jgrip/Amiga-2000-EATX/Schematics/2000ATX-REV22-Schematics.pdf

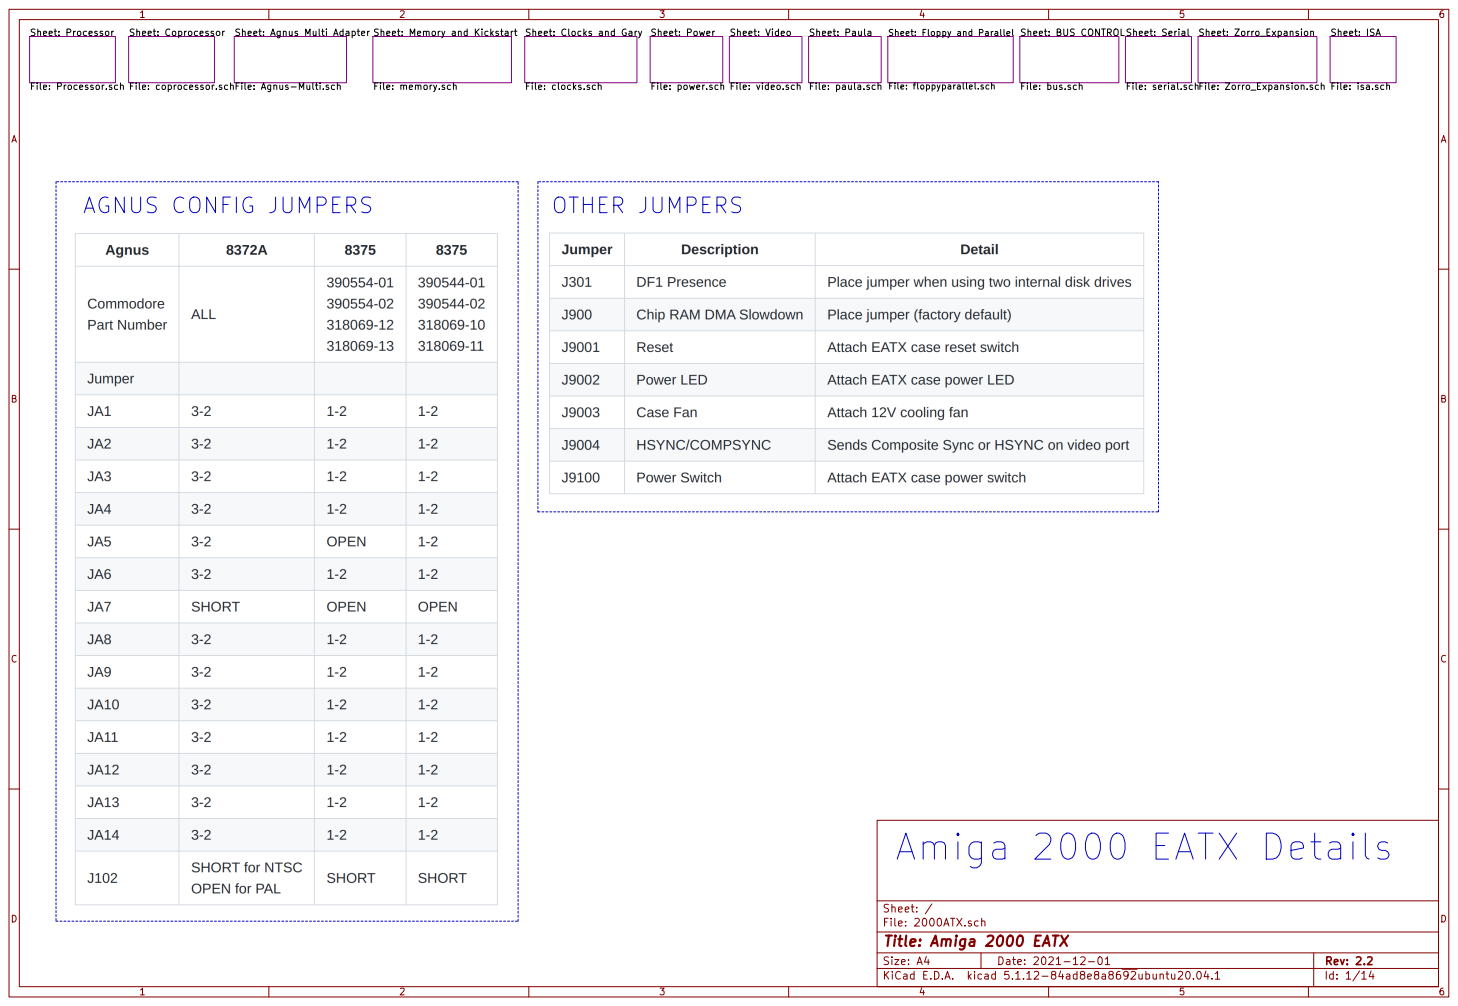
[picture p1: page 1]

Sheet: Memory and Kickstart

File: isa.sch Sheet: Zorro_Expansion

File: Agnus-Multi.sch

File: 2000ATX.sch Sheet: /
Id: 1/14 Title: Amiga 2000 EATX

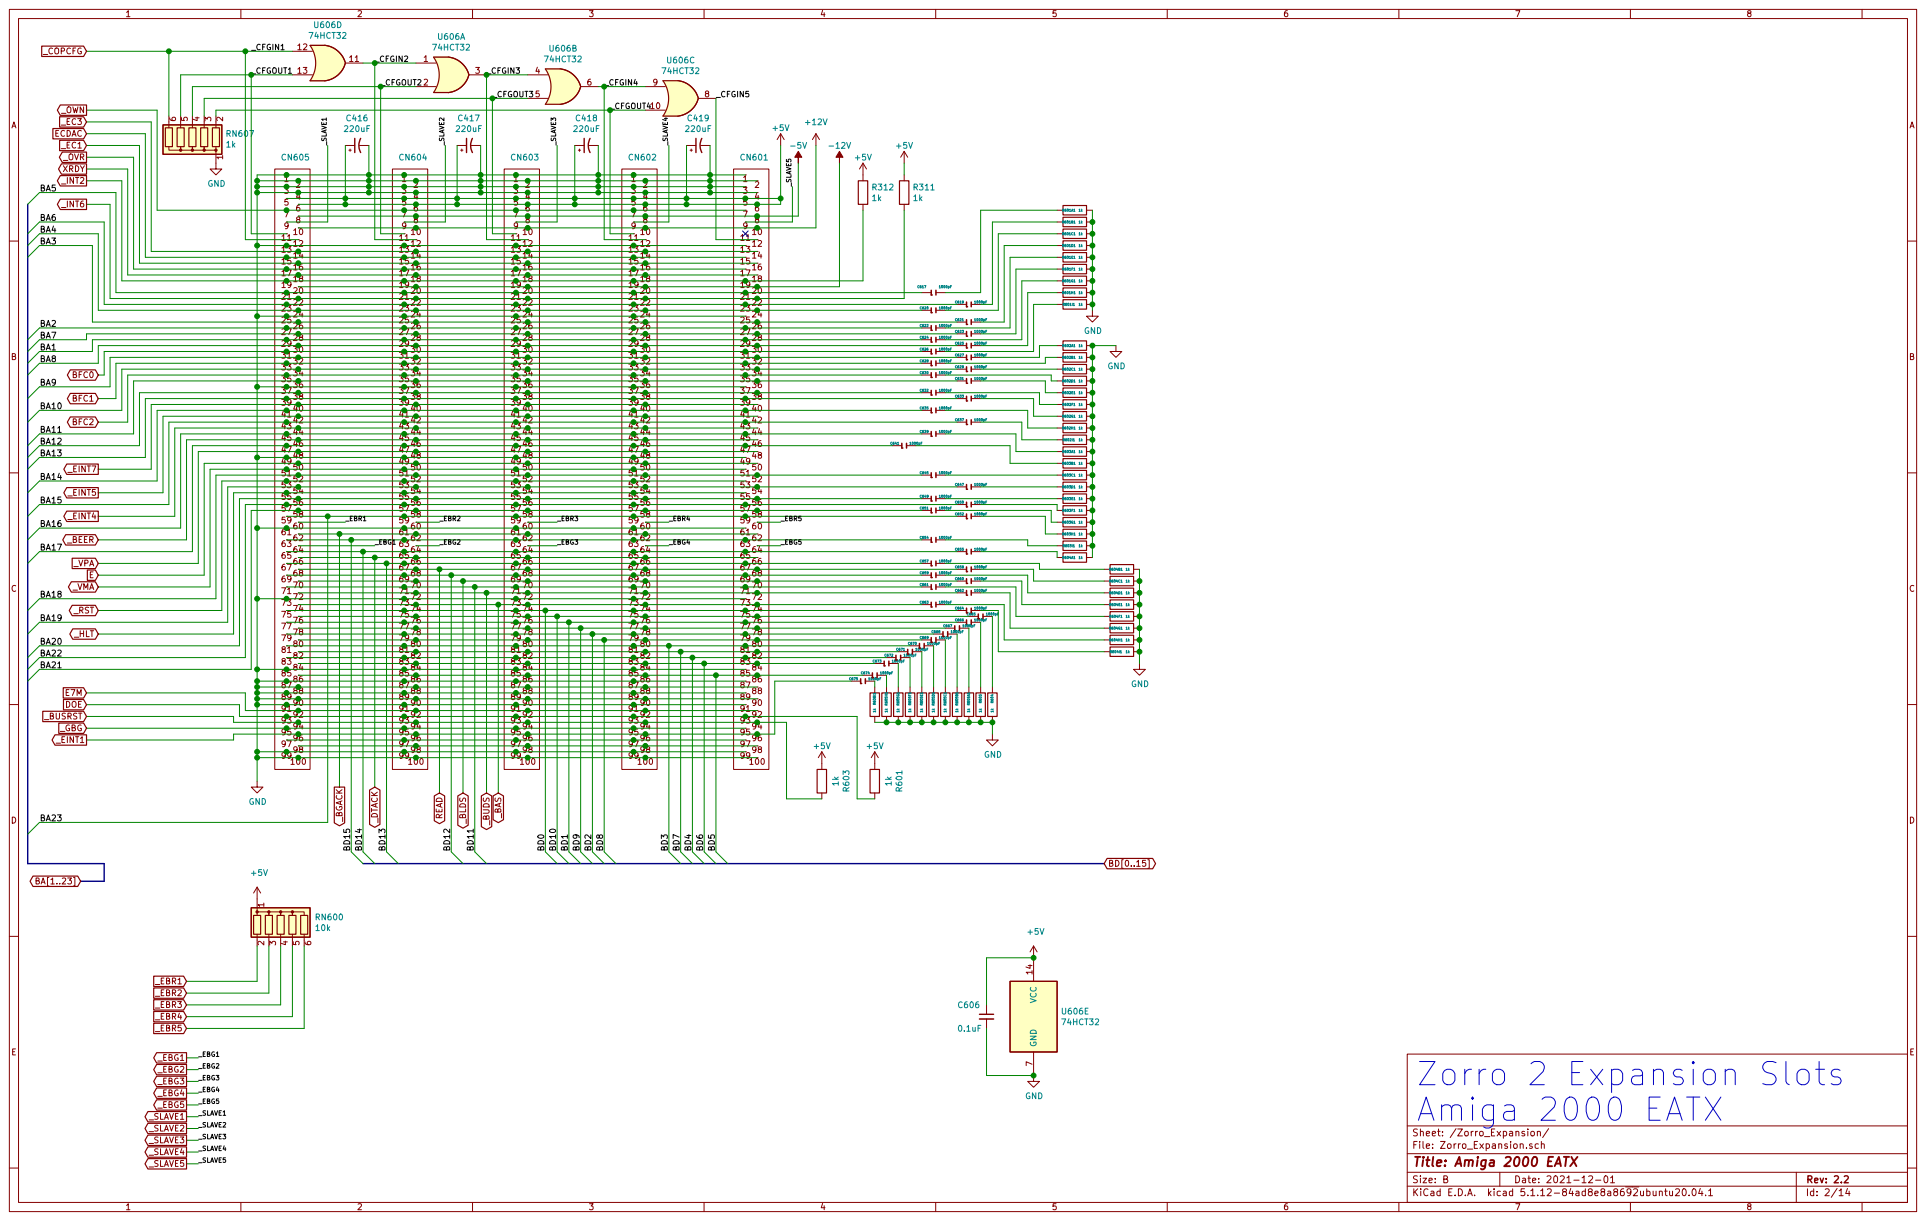
[picture p2: page 2]

495
59 6 24 25 | 59 6 24 25 | 59 6 24 25 | 59 6 24 25 | 59 6 24 25
697 26 27 28 | 697 26 27 28 | 697 26 27 28 | 697 26 27 28 | 697 26 27 28
79 8 32 | 79 8 32 | 79 8 32 | 79 8 32 | 79 8 32
899 35 | 899 35 | 899 35 | 899 35 | 899 35

21 | 21 | 21 | 21 | 21
22 | 22 | 22 | 22 | 22
23 | 23 | 23 | 23 | 23

30 | 30 | 30 | 30 | 30
31 | 31 | 31 | 31 | 31
33 | 33 | 33 | 33 | 33
34 | 34 | 34 | 34 | 34
36 37 | 36 37 | 36 37 | 36 37 | 36 37
38 | 38 | 38 | 38 | 38
41 42 | 41 42 | 41 42 | 41 42 | 41 42
43 44 | 43 44 | 43 44 | 43 44 | 43 44
45 46 | 45 46 | 45 46 | 45 46 | 45 46
47 48 50 51 | 47 48 50 51 | 47 48 50 51 | 47 48 50 51 | 47 48 50 51

52 53 | 52 53 | 52 53 | 52 53 | 52 53
54 55 | 54 55 | 54 55 | 54 55 | 54 55
56 | 56 | 56 | 56 | 56
57 | 57 | 57 | 57 | 57
58 | | 58 | 58 | 58 | 58

93 | 93 | 93 | 93 | 93
94 95 | 94 95 | 94 95 | 94 95 | 94 95
96 97 98 99 100 | 96 97 98 99 100 | 96 97 98 99 100 | 96 97 98 99 100 | 96 97 98 99 100

Sheet: /Zorro_Expansion/
File: Zorro_Expansion.sch
Id: 2/14 Title: Amiga 2000 EATX

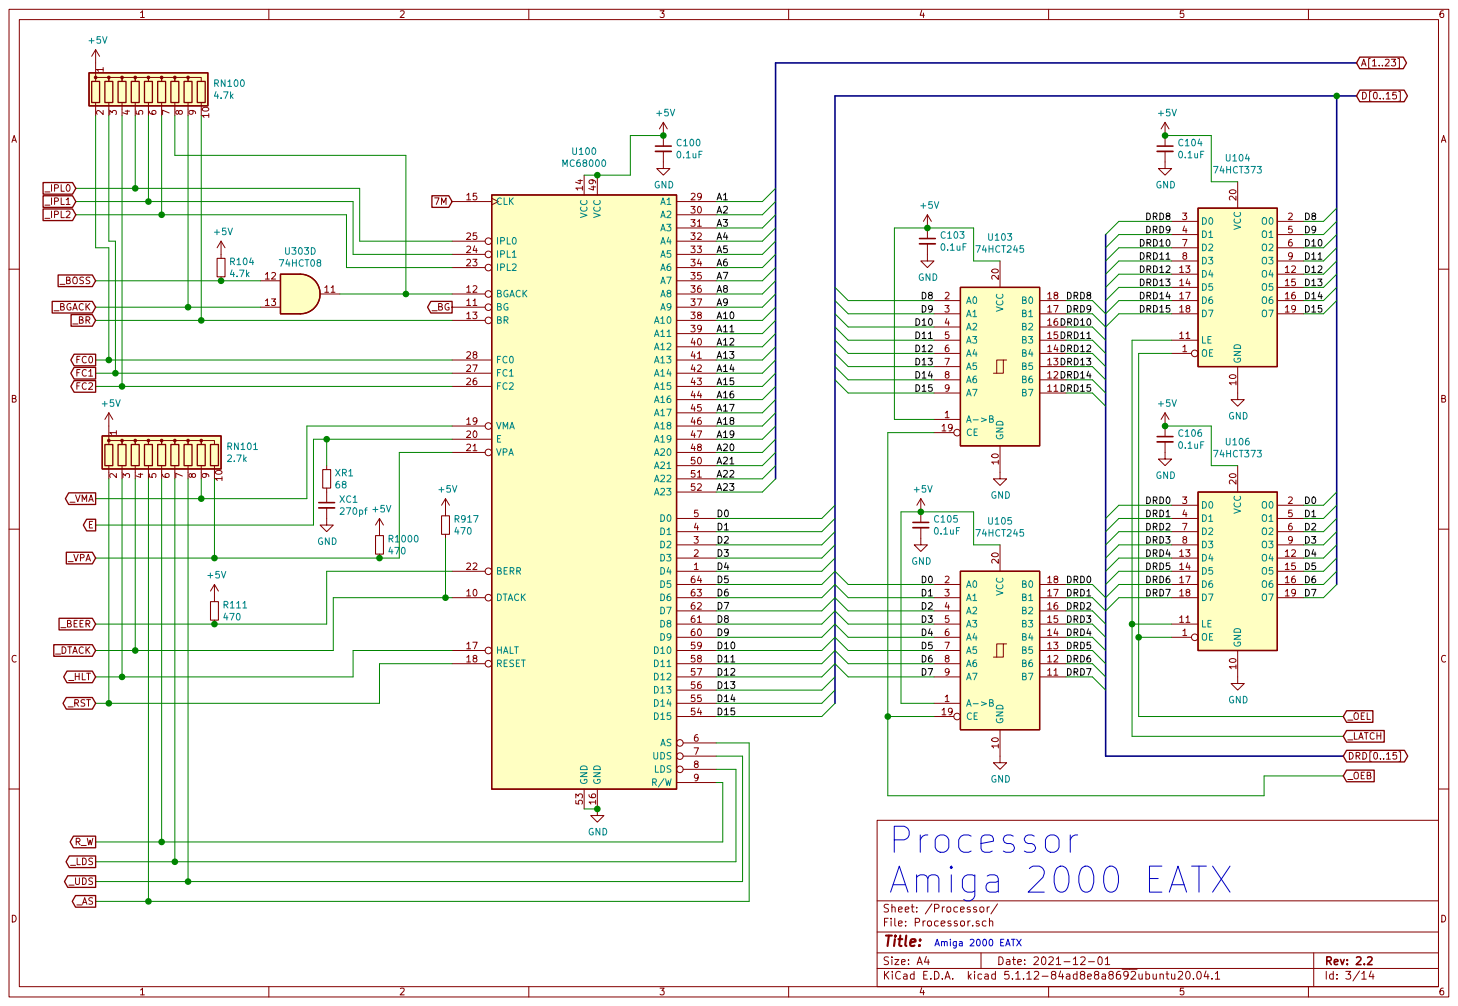
[picture p3: page 3]

Id: 3/14 Title: File: Processor.sch Sheet: /Processor/ GND

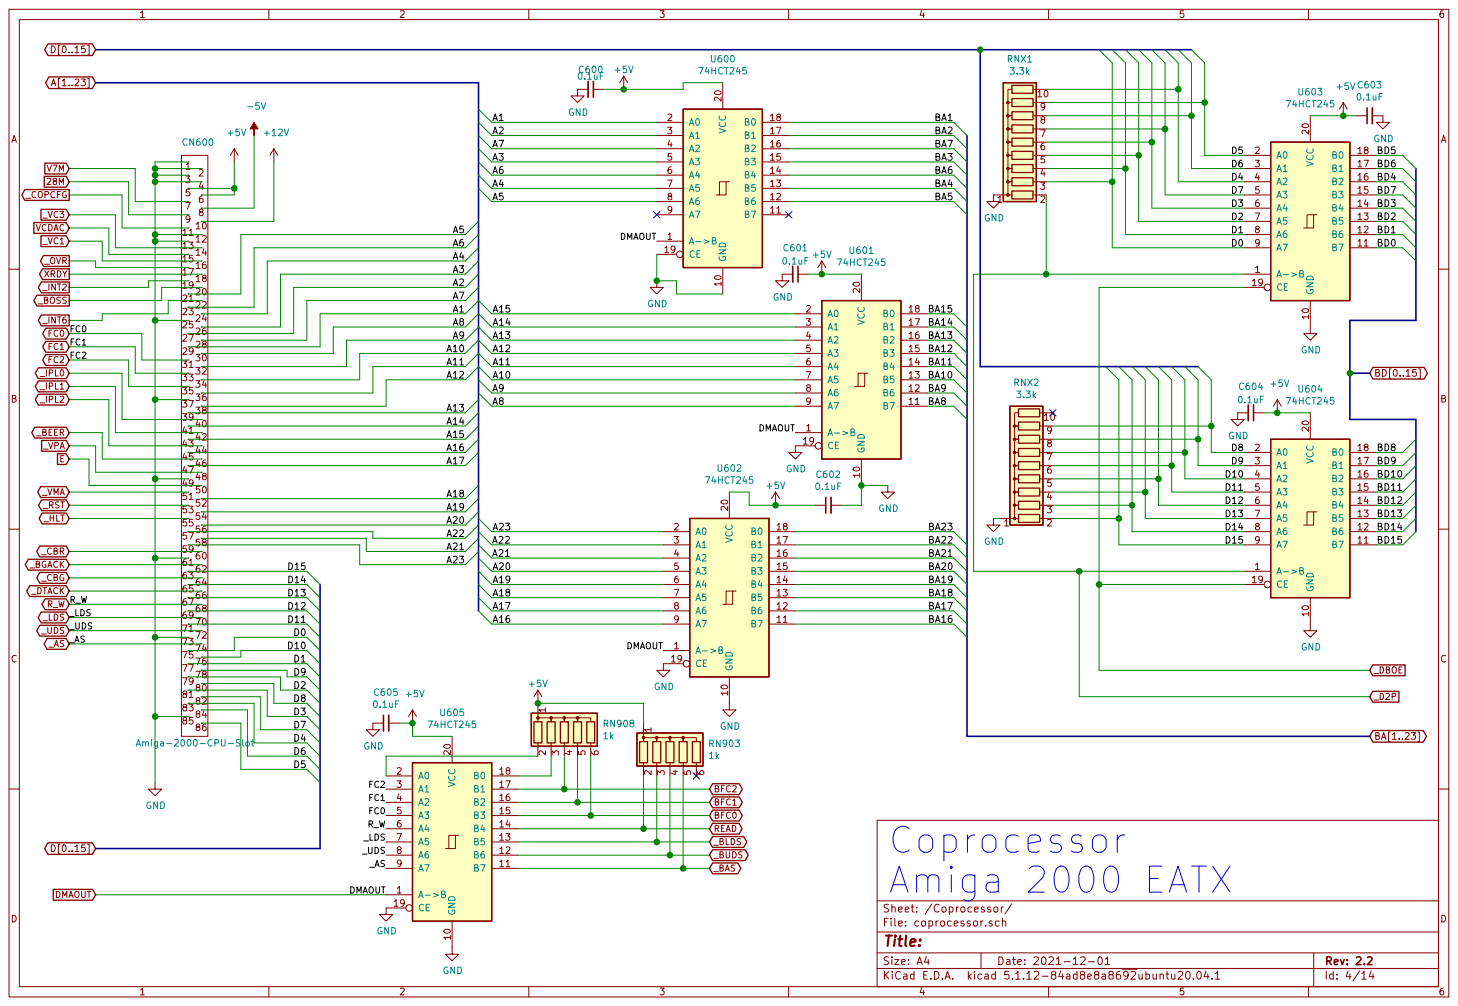
[picture p4: page 4]

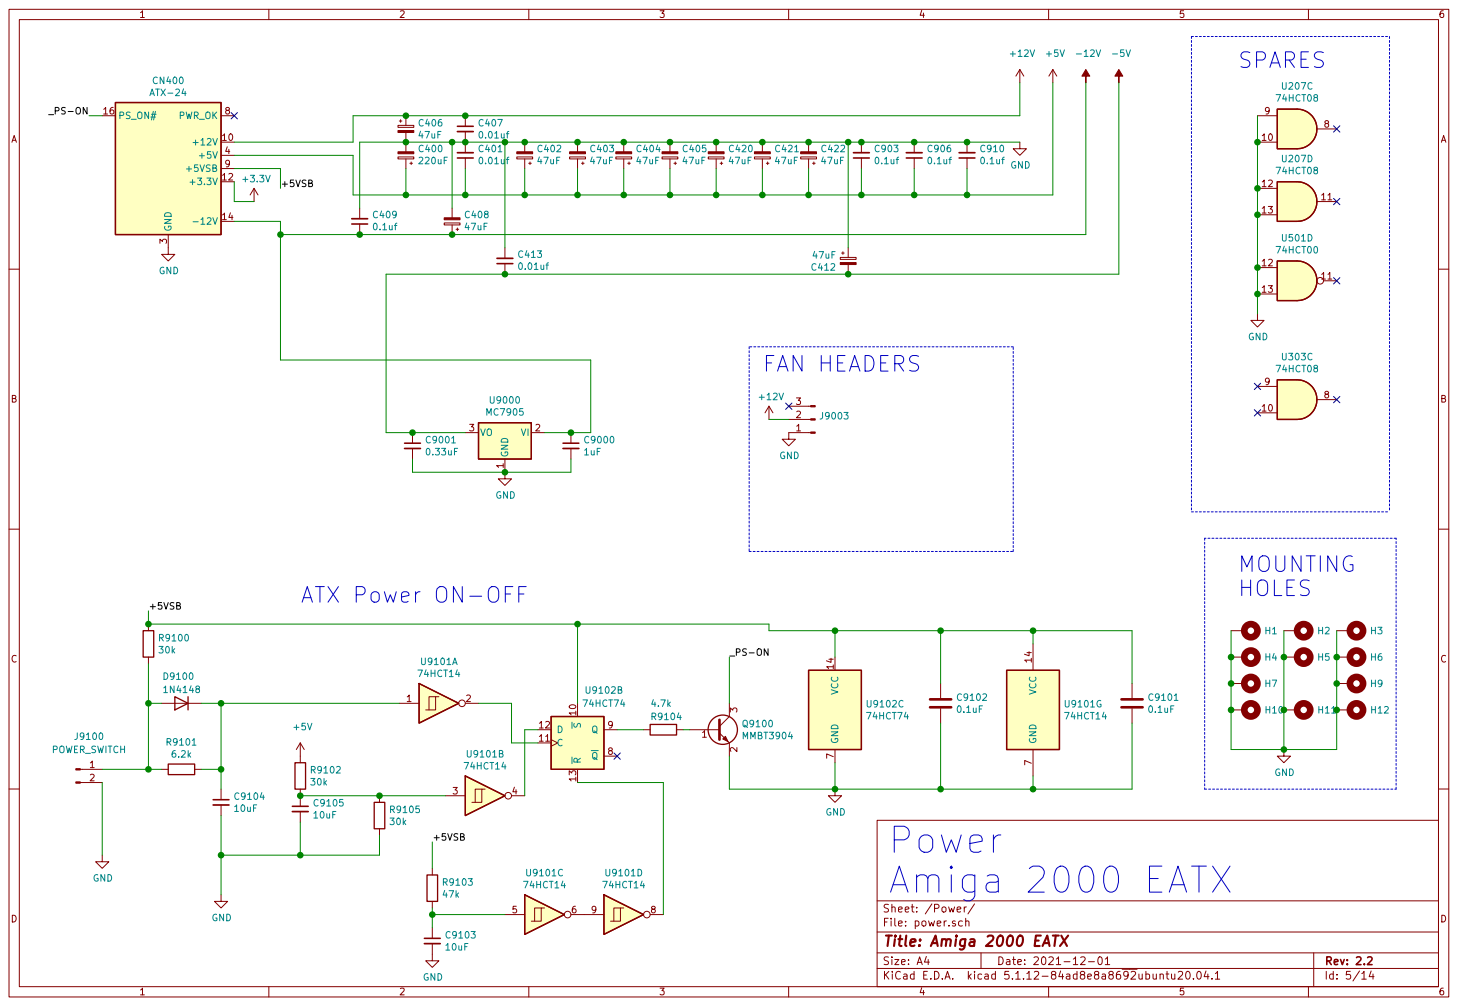
[picture p5: page 5]

File: power.sch Sheet: /Power/
Id: 5/14 Title: Amiga 2000 EATX

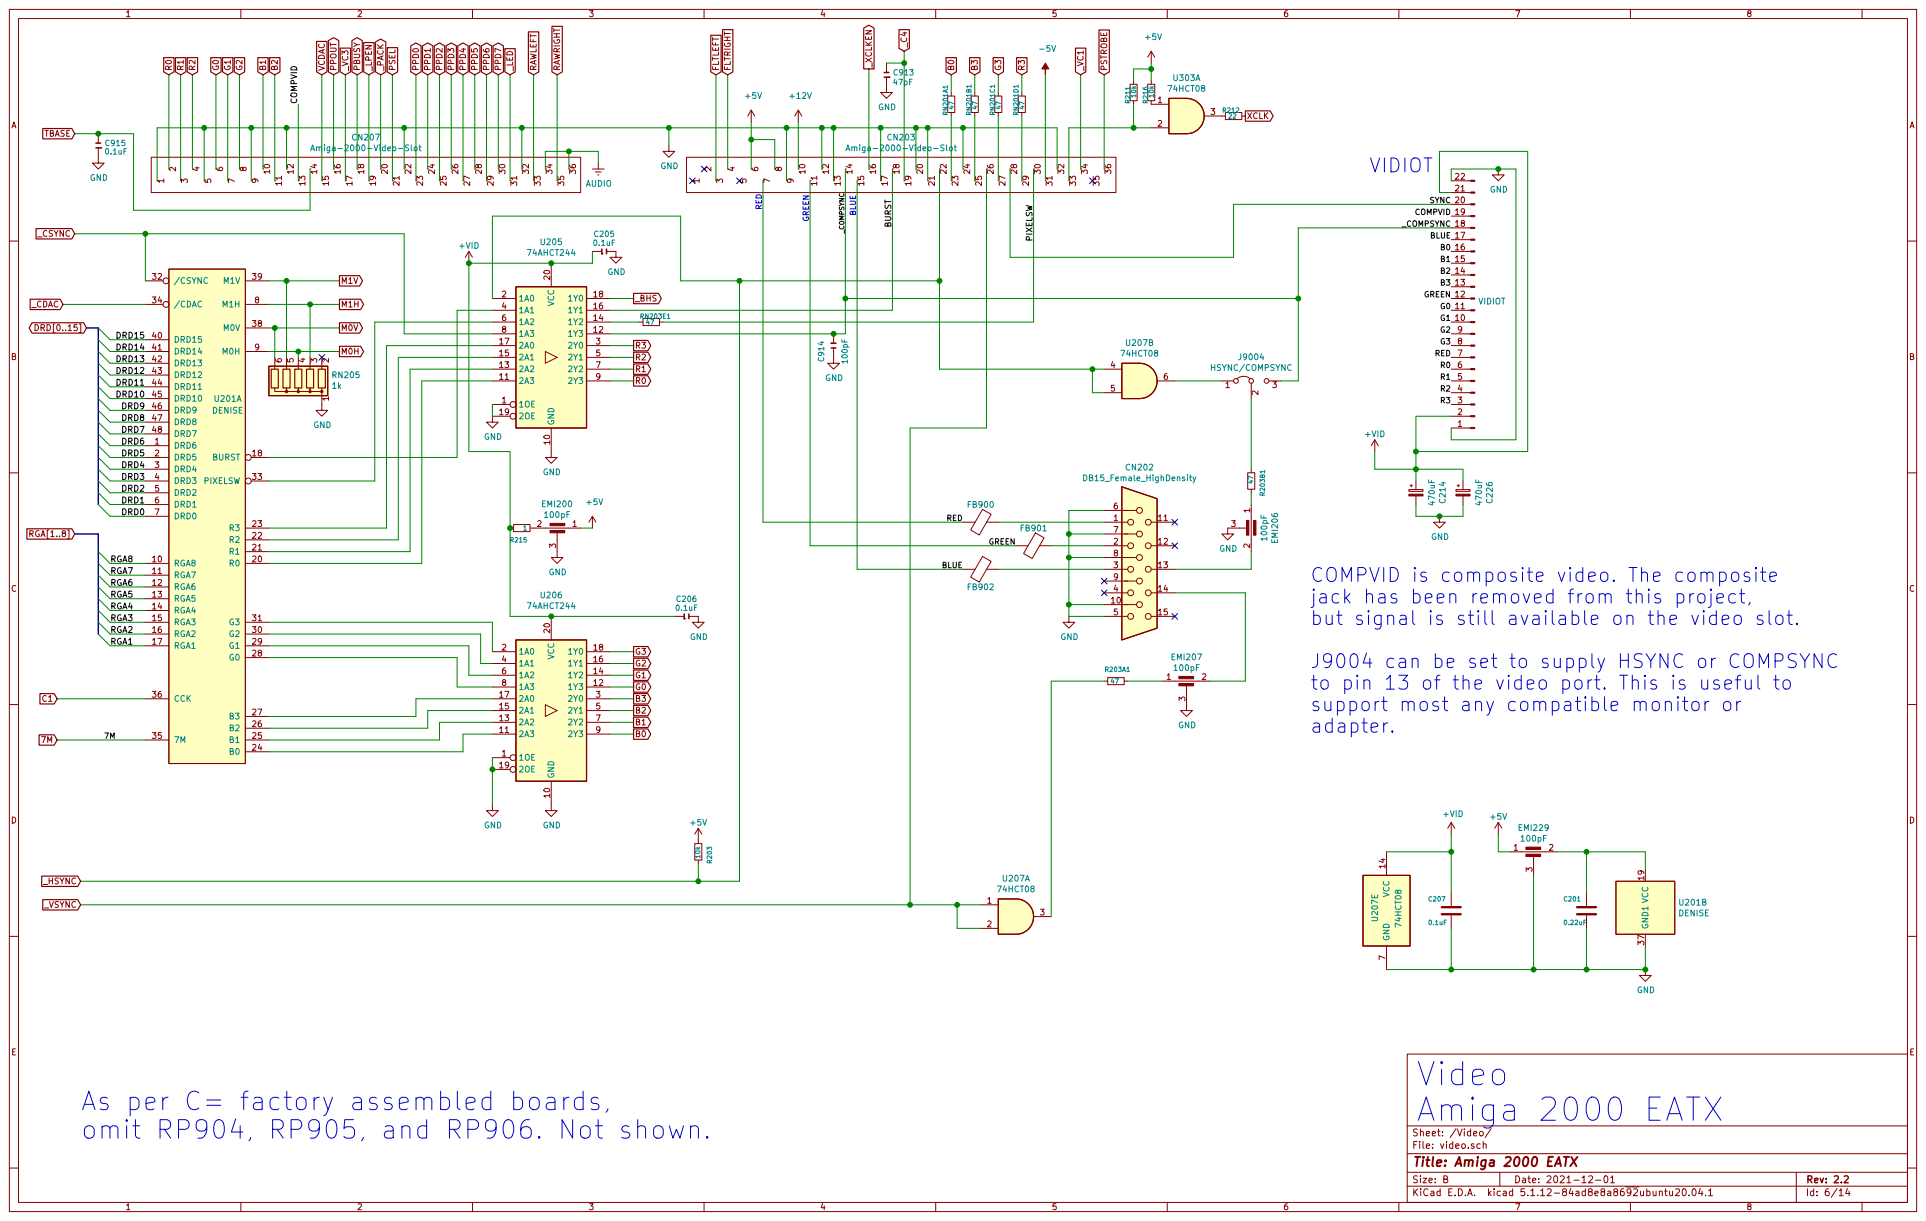
[picture p6: page 6]

9 CN207 Amiga-2000-Video-Slot FB901 GND

adapter. BLUE GREEN RED

COMPVID is composite video. The composite
jack has been removed from this project,
but signal is still available on the video slot.
J9004 can be set to supply HSYNC or COMPSYNC
to pin 13 of the video port. This is useful to
support most any compatible monitor or

As per C= factory assembled boards,
omit RP904, RP905, and RP906. Not shown.

Id: 6/14 Title: Amiga 2000 EATX

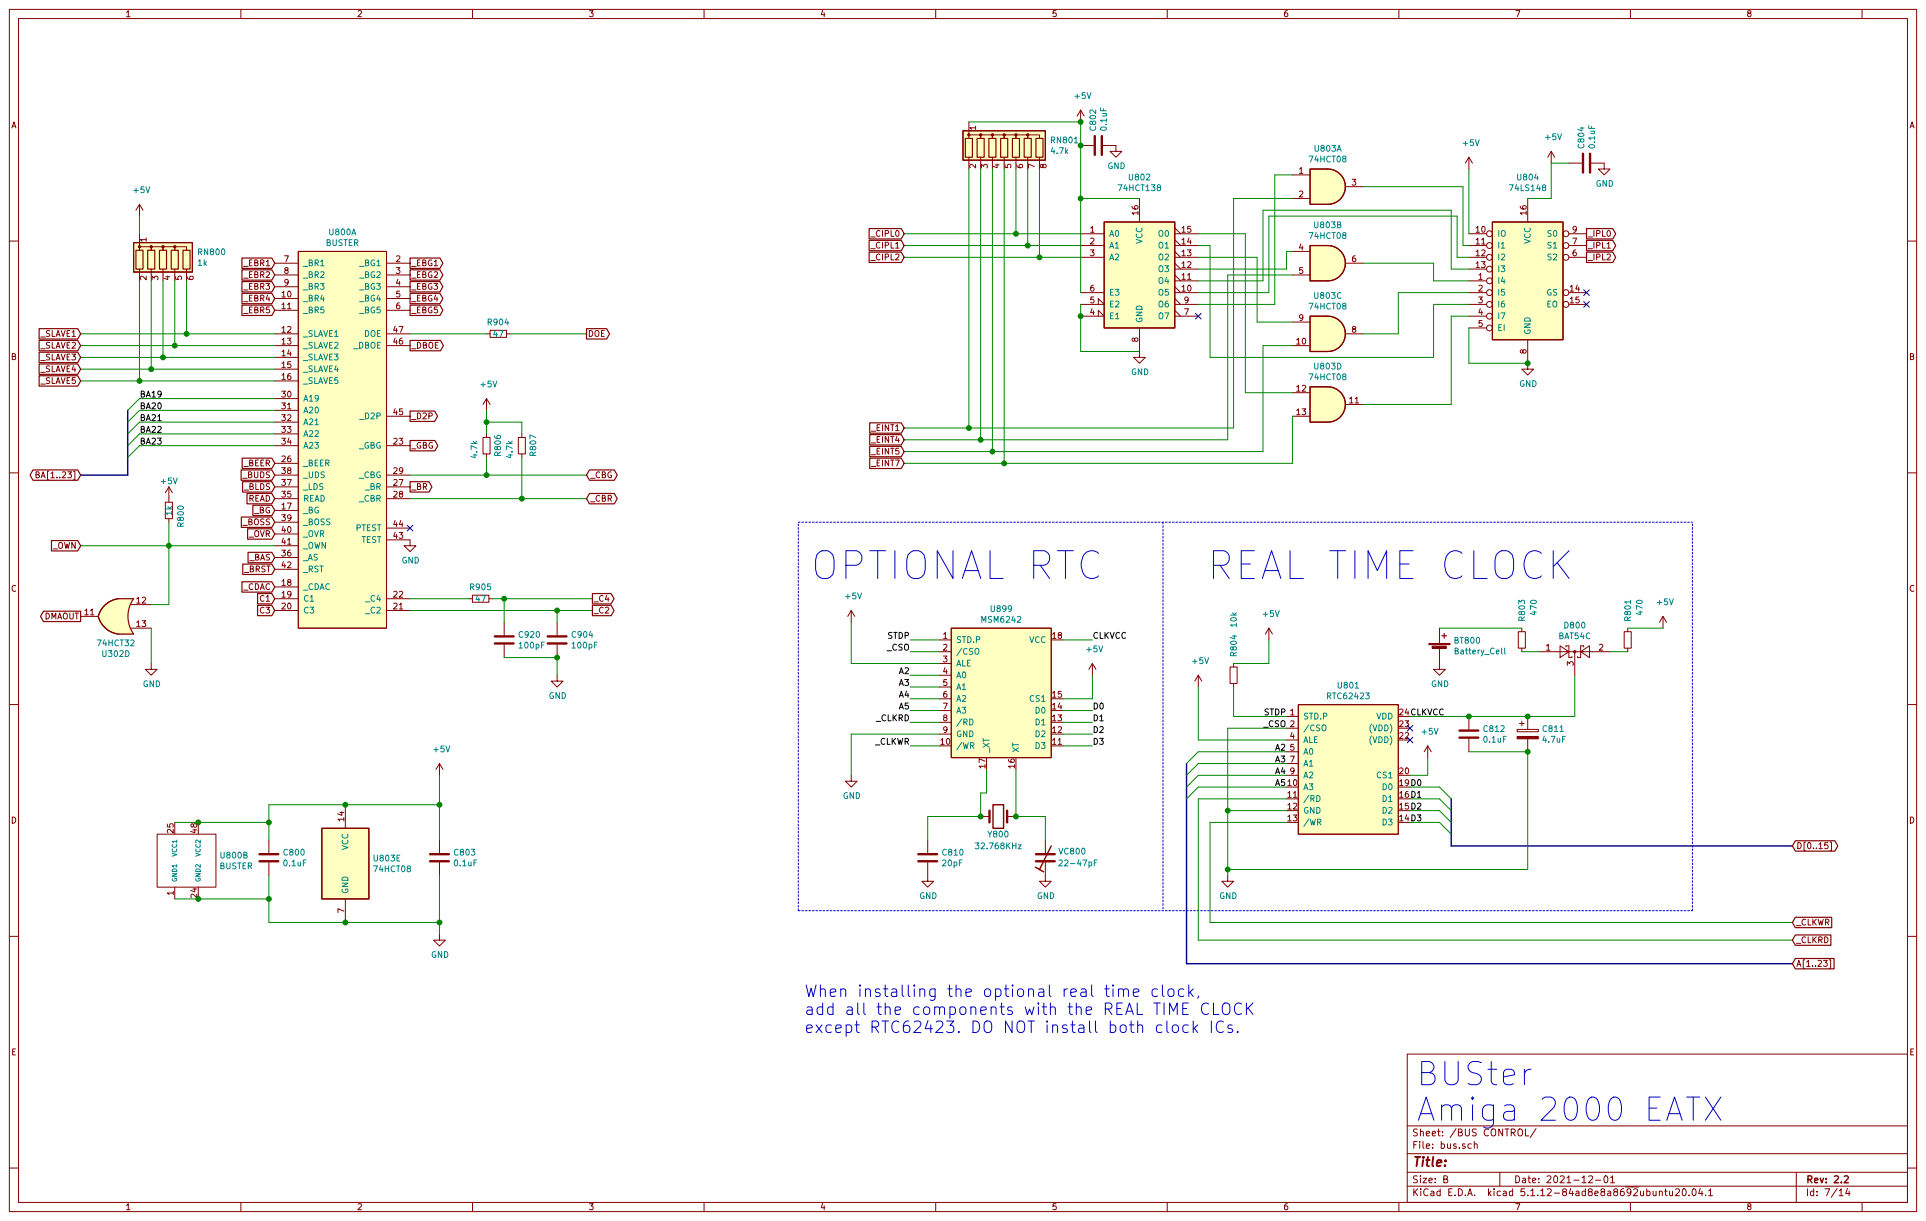
[picture p7: page 7]

When installing the optional real time clock,
add all the components with the REAL TIME CLOCK
except RTC62423. DO NOT install both clock ICs.

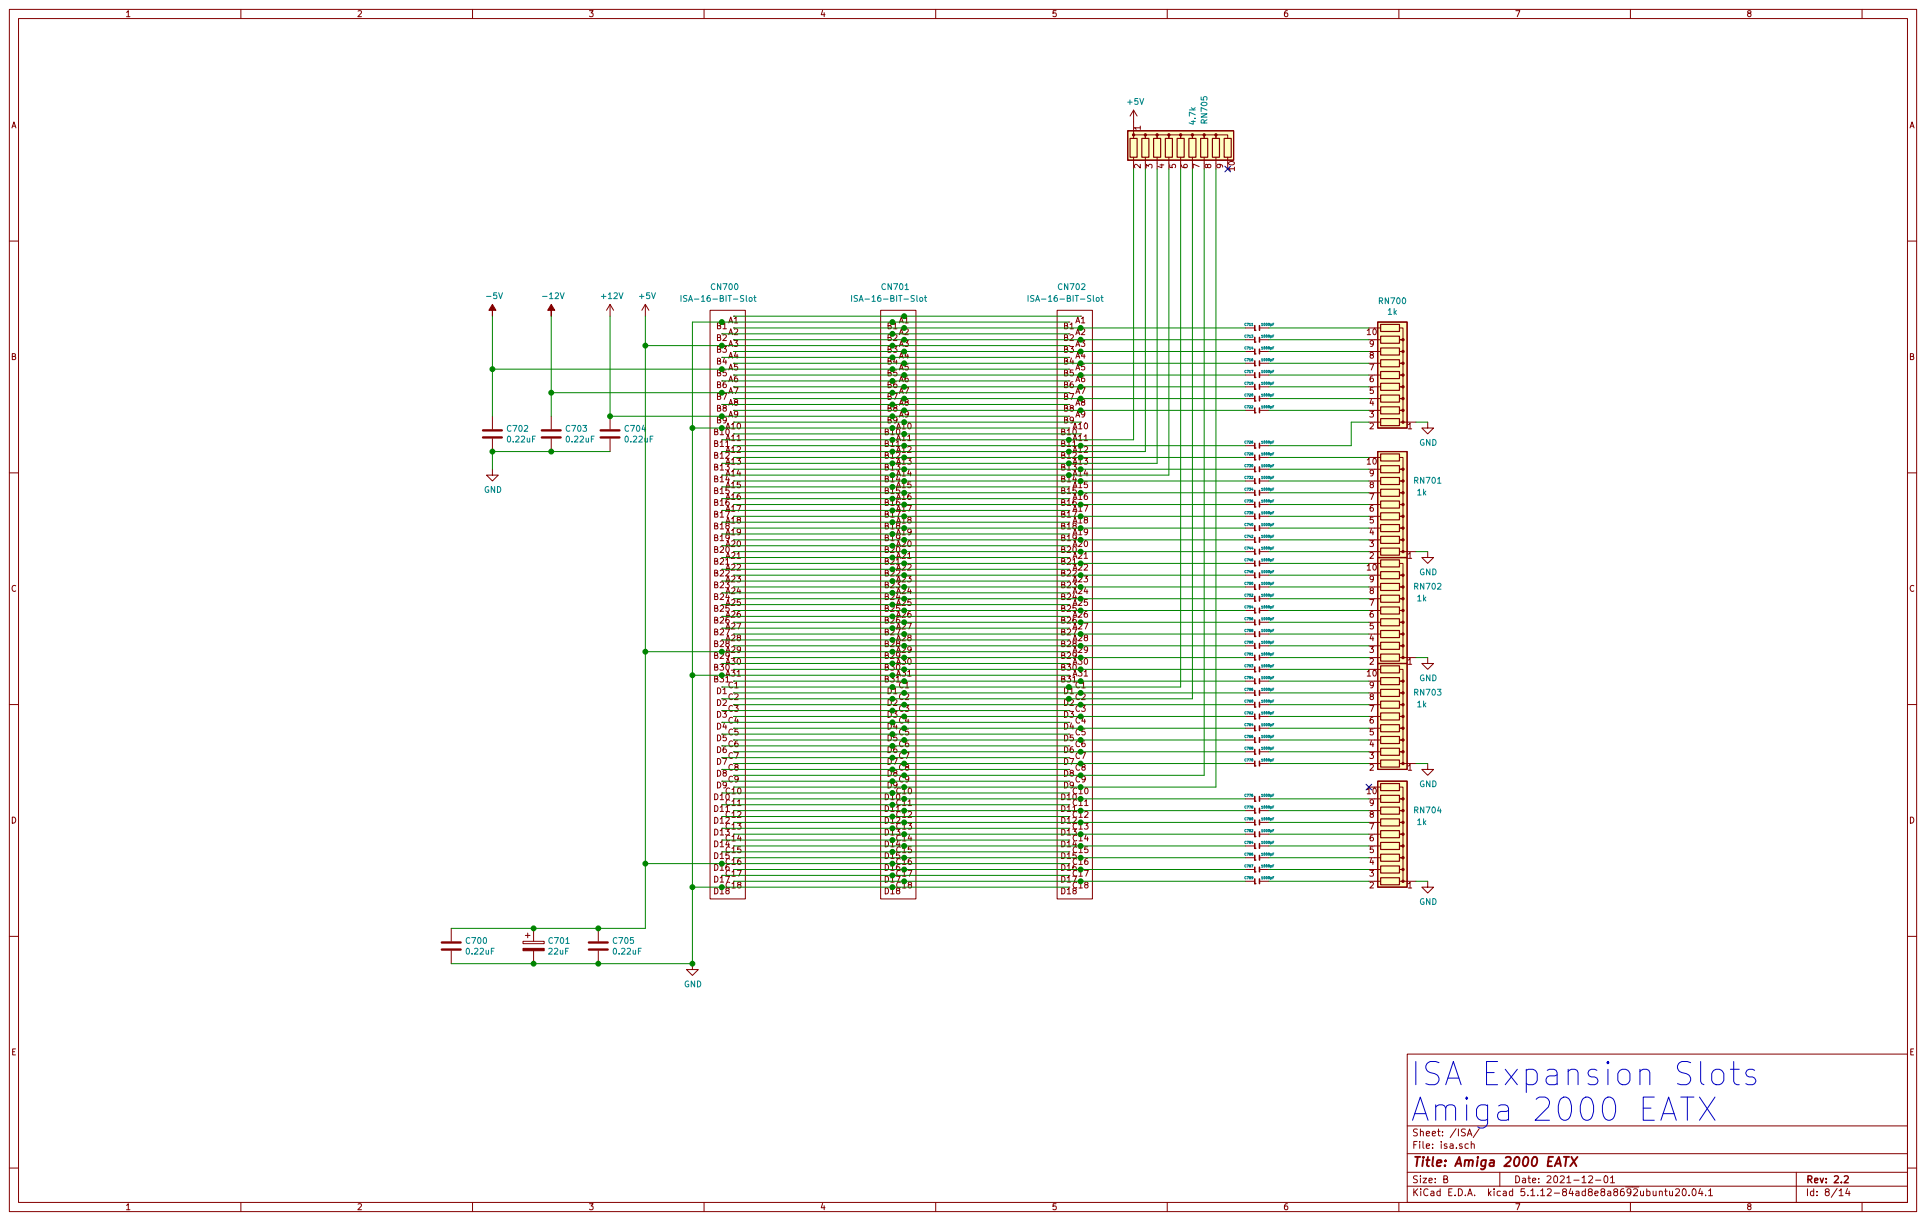
[picture p8: page 8]

File: isa.sch Sheet: /ISA/
Id: 8/14 Title: Amiga 2000 EATX

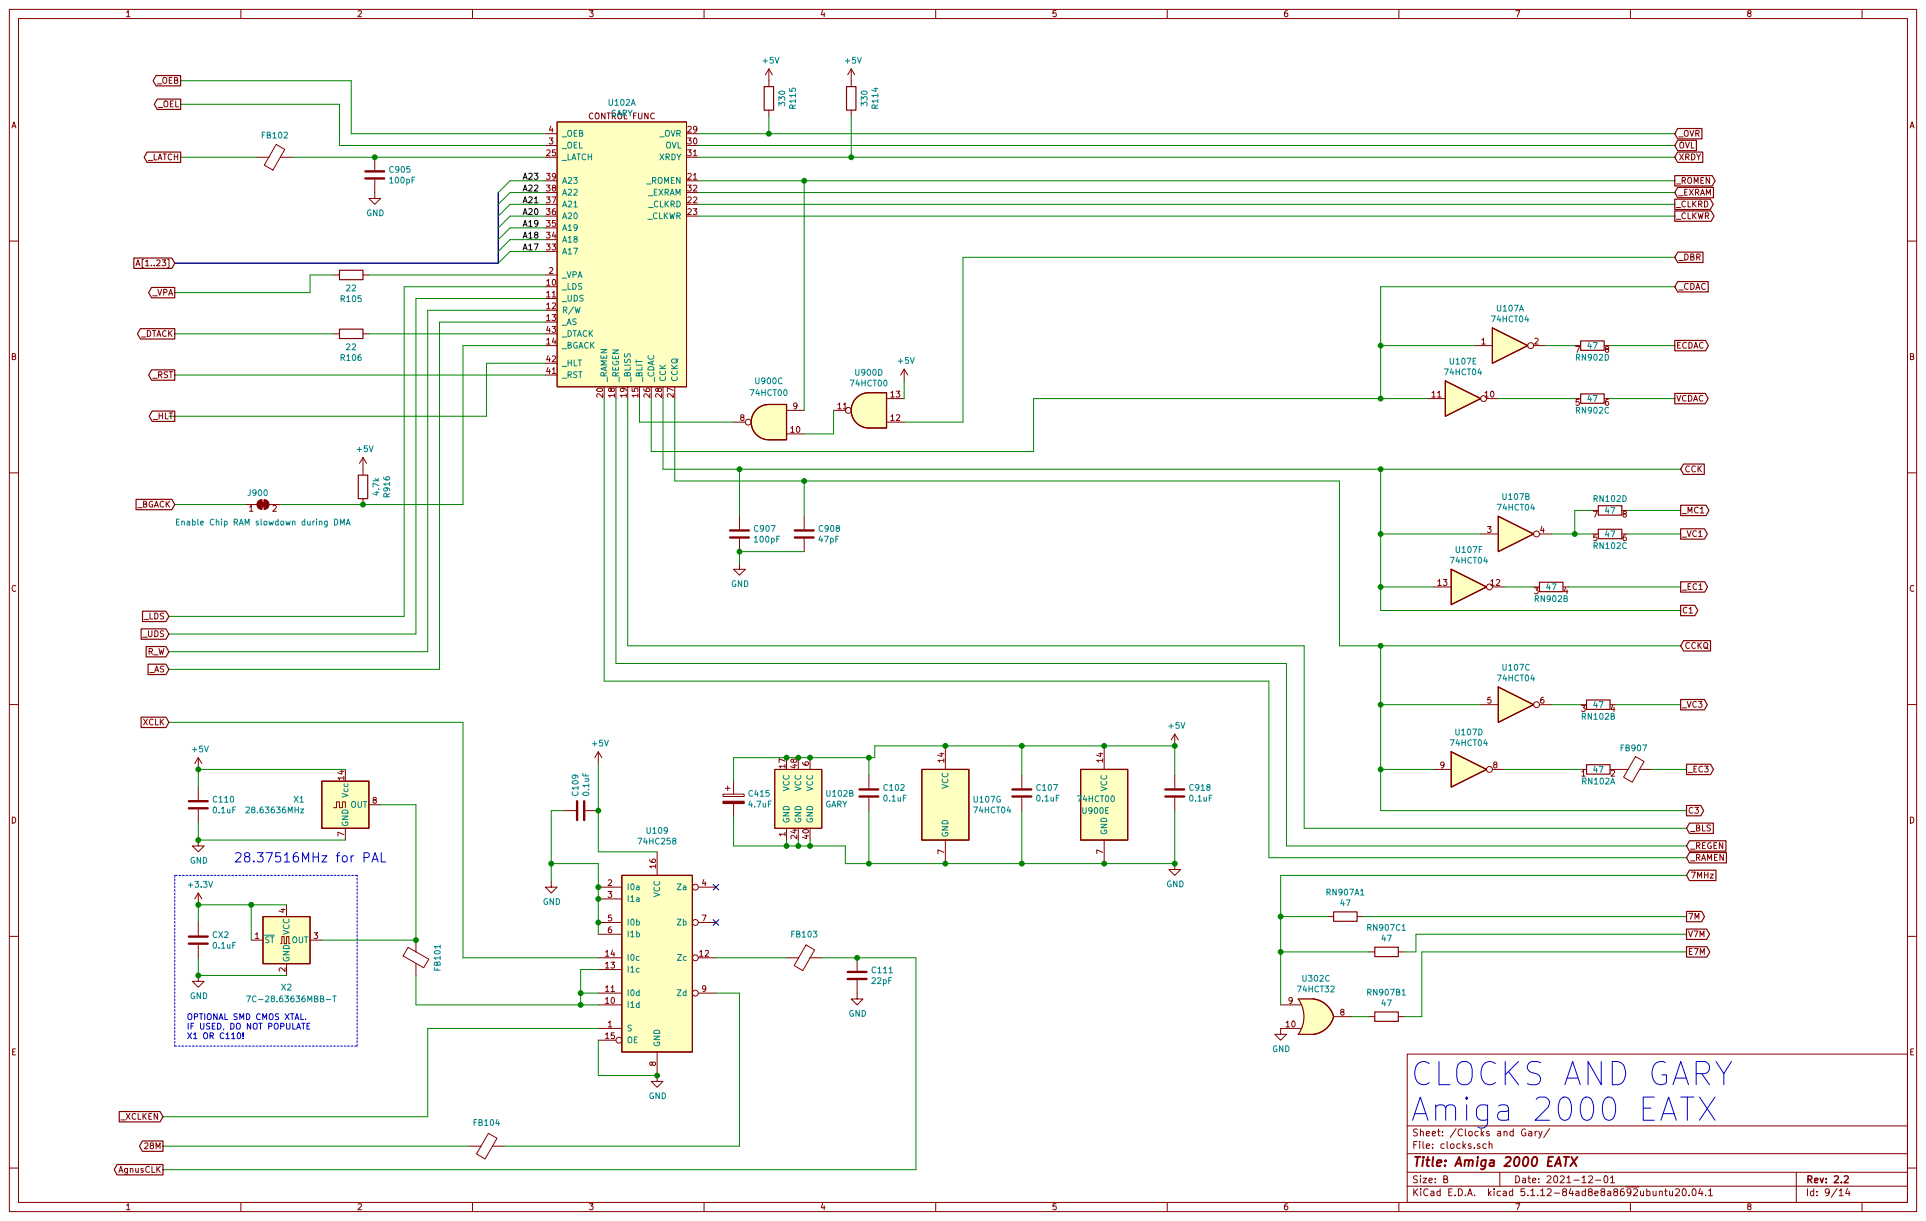
[picture p9: page 9]

J900 Enable Chip RAM slowdown during DMA

OPTIONAL SMD CMOS XTAL.
IF USED, DO NOT POPULATE X1 OR C110!

Id: 9/14 Title: Amiga 2000 EATX

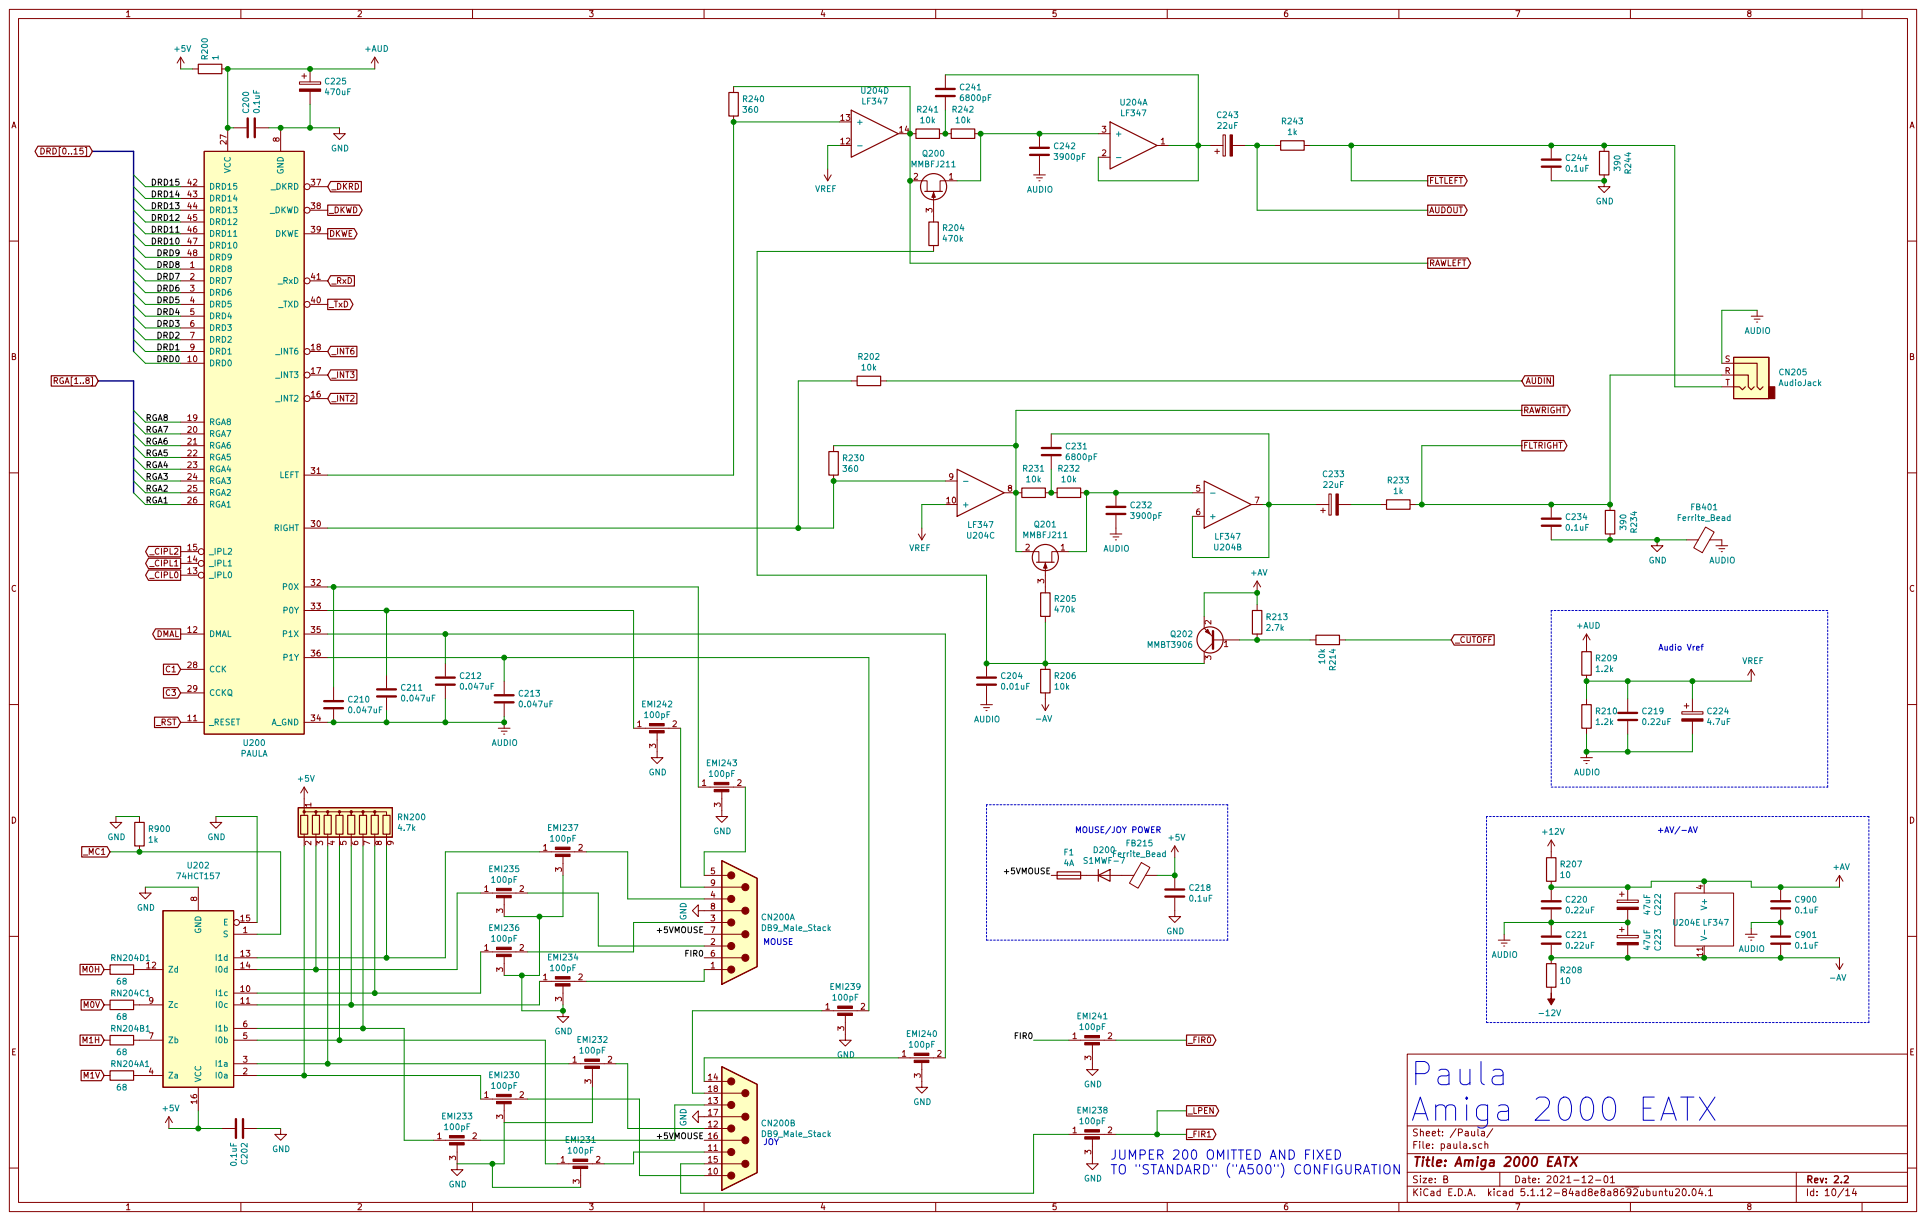
[picture p10: page 10]

Audio Vref JUMPER 200 OMITTED AND FIXED

Id: 10/14 Title: Amiga 2000 EATX

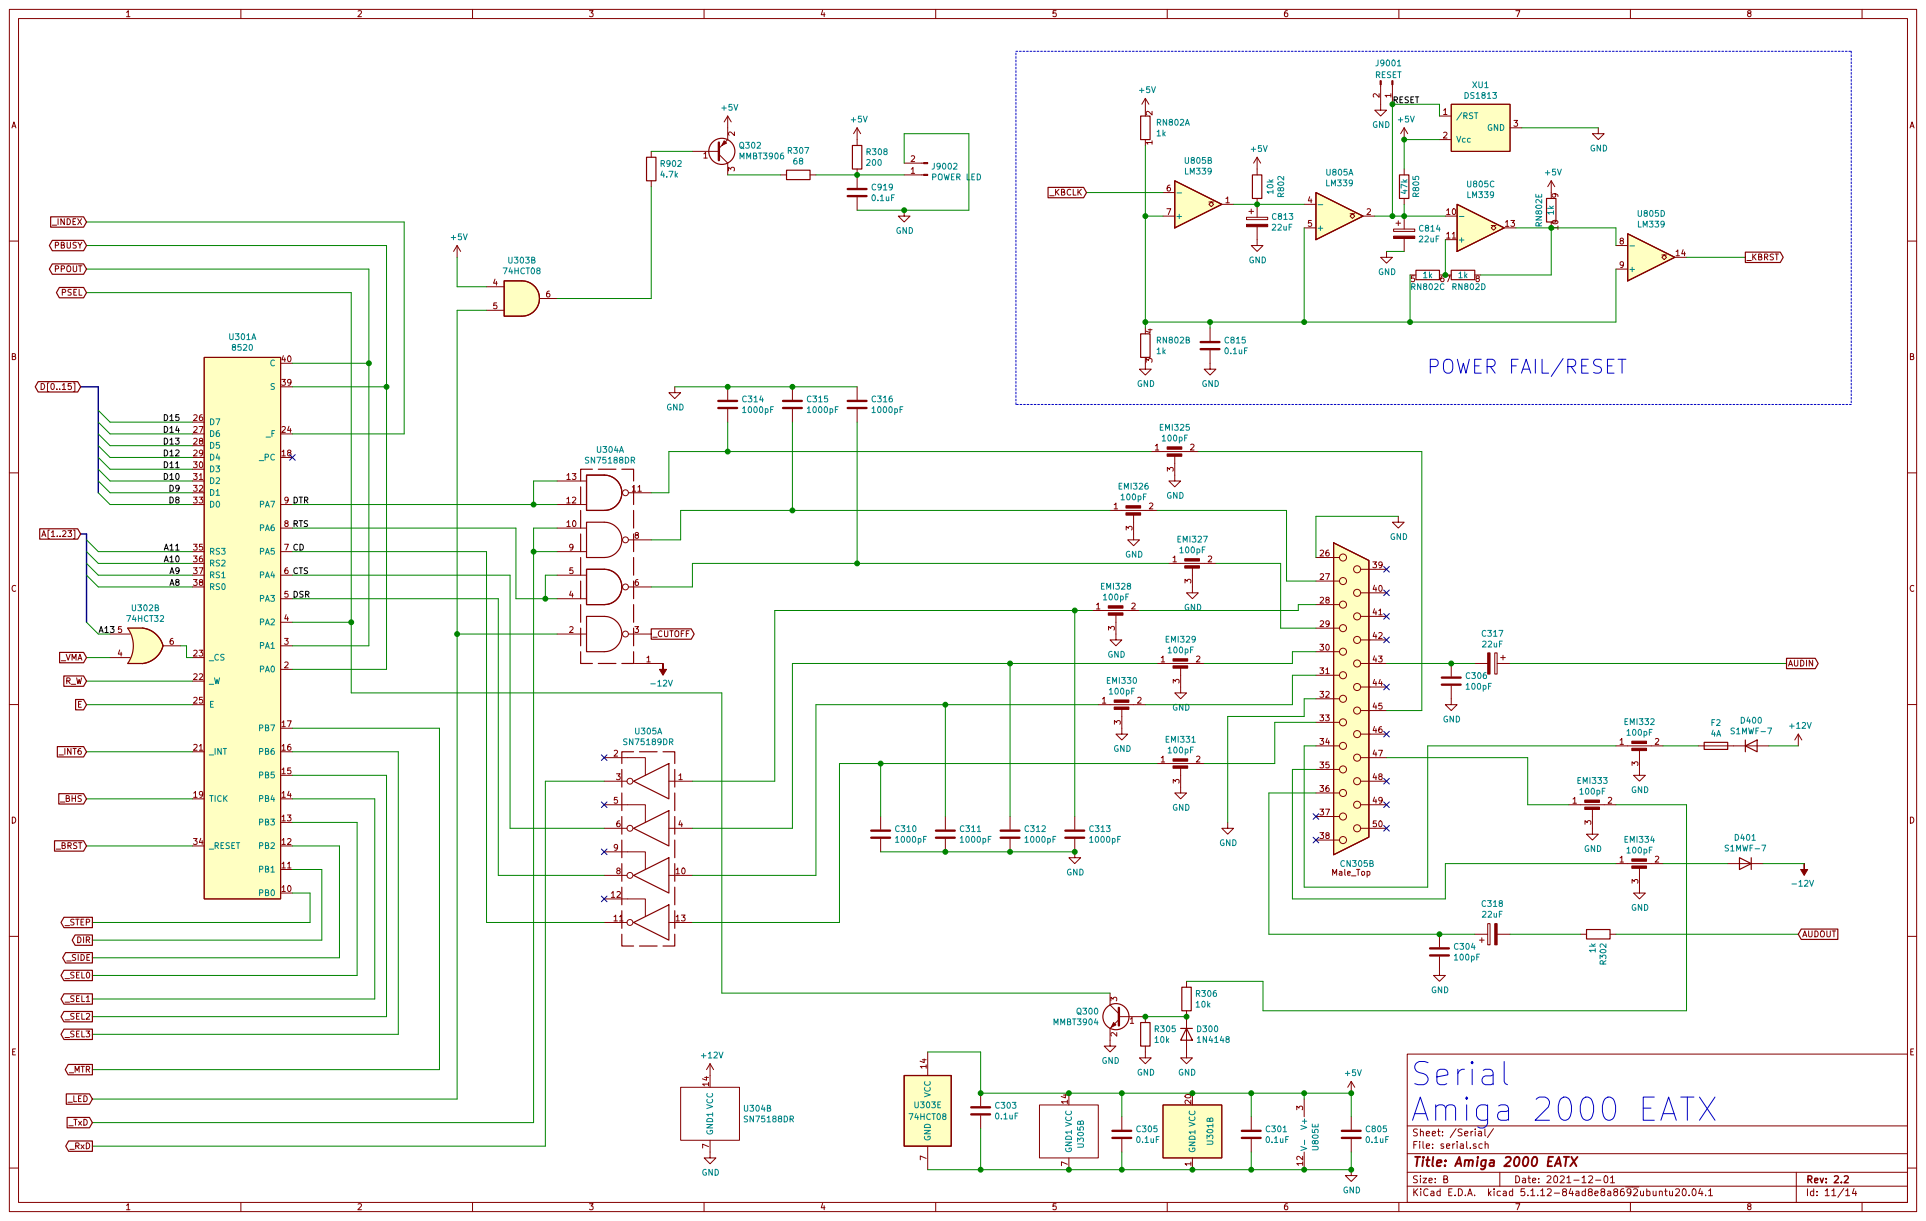
[picture p11: page 11]

DTR

File: serial.sch Sheet: /Serial/
Id: 11/14 Title: Amiga 2000 EATX

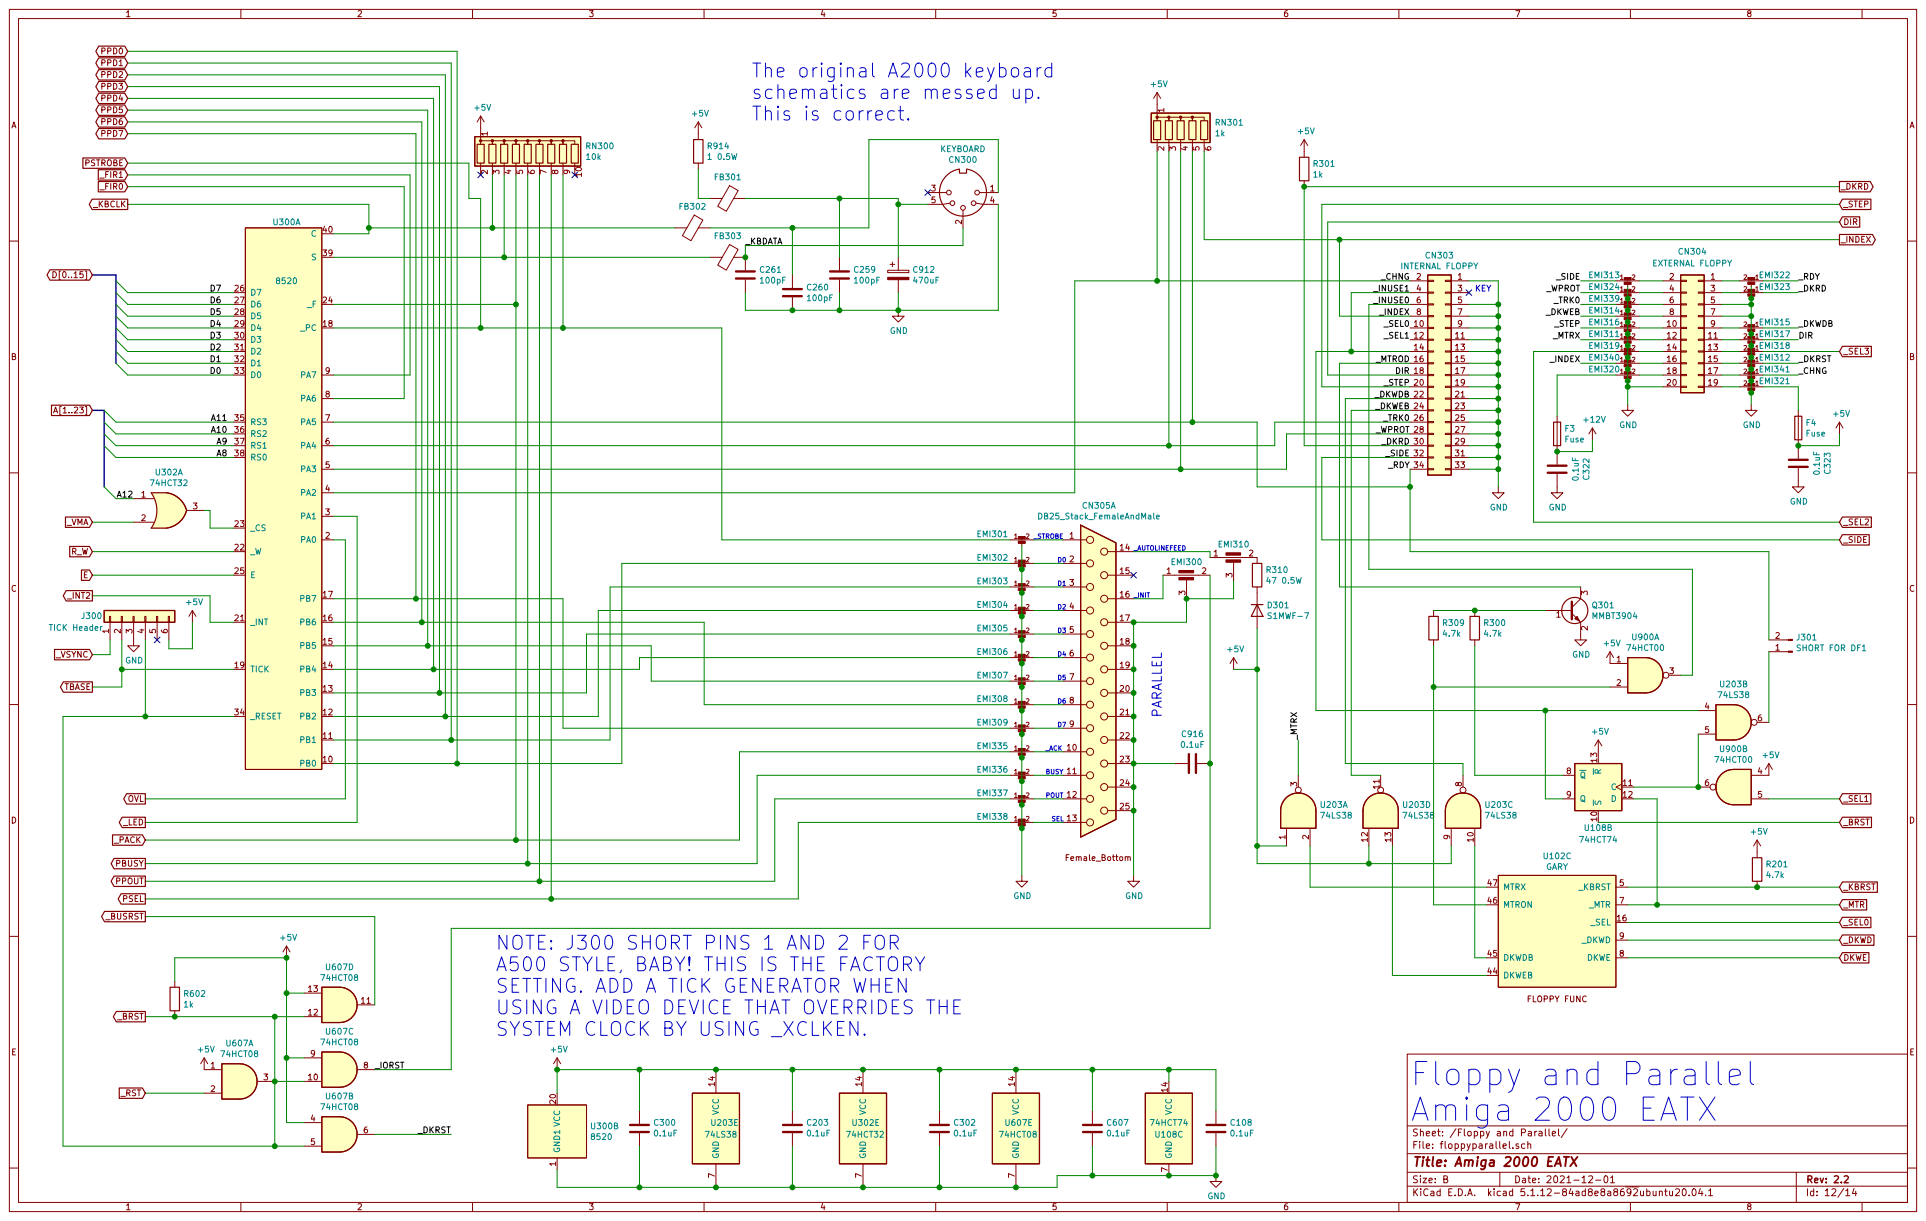
[picture p12: page 12]

_STROBE The original A2000 keyboard
schematics are messed up.
This is correct.

_INUSE1 4 | 3
_INUSE0 6 | 5

_DKWDB 22 | 21
_DKWEB 24 | 23

_DKRD 30 | 29
_SIDE 32 | 31
34 | 33

A500 STYLE, BABY! THIS IS THE FACTORY
SETTING. ADD A TICK GENERATOR WHEN
USING A VIDEO DEVICE THAT OVERRIDES THE
SYSTEM CLOCK BY USING _XCLKEN.

Sheet: /Floppy and Parallel/
File: floppyparallel.sch
Id: 12/14 Title: Amiga 2000 EATX

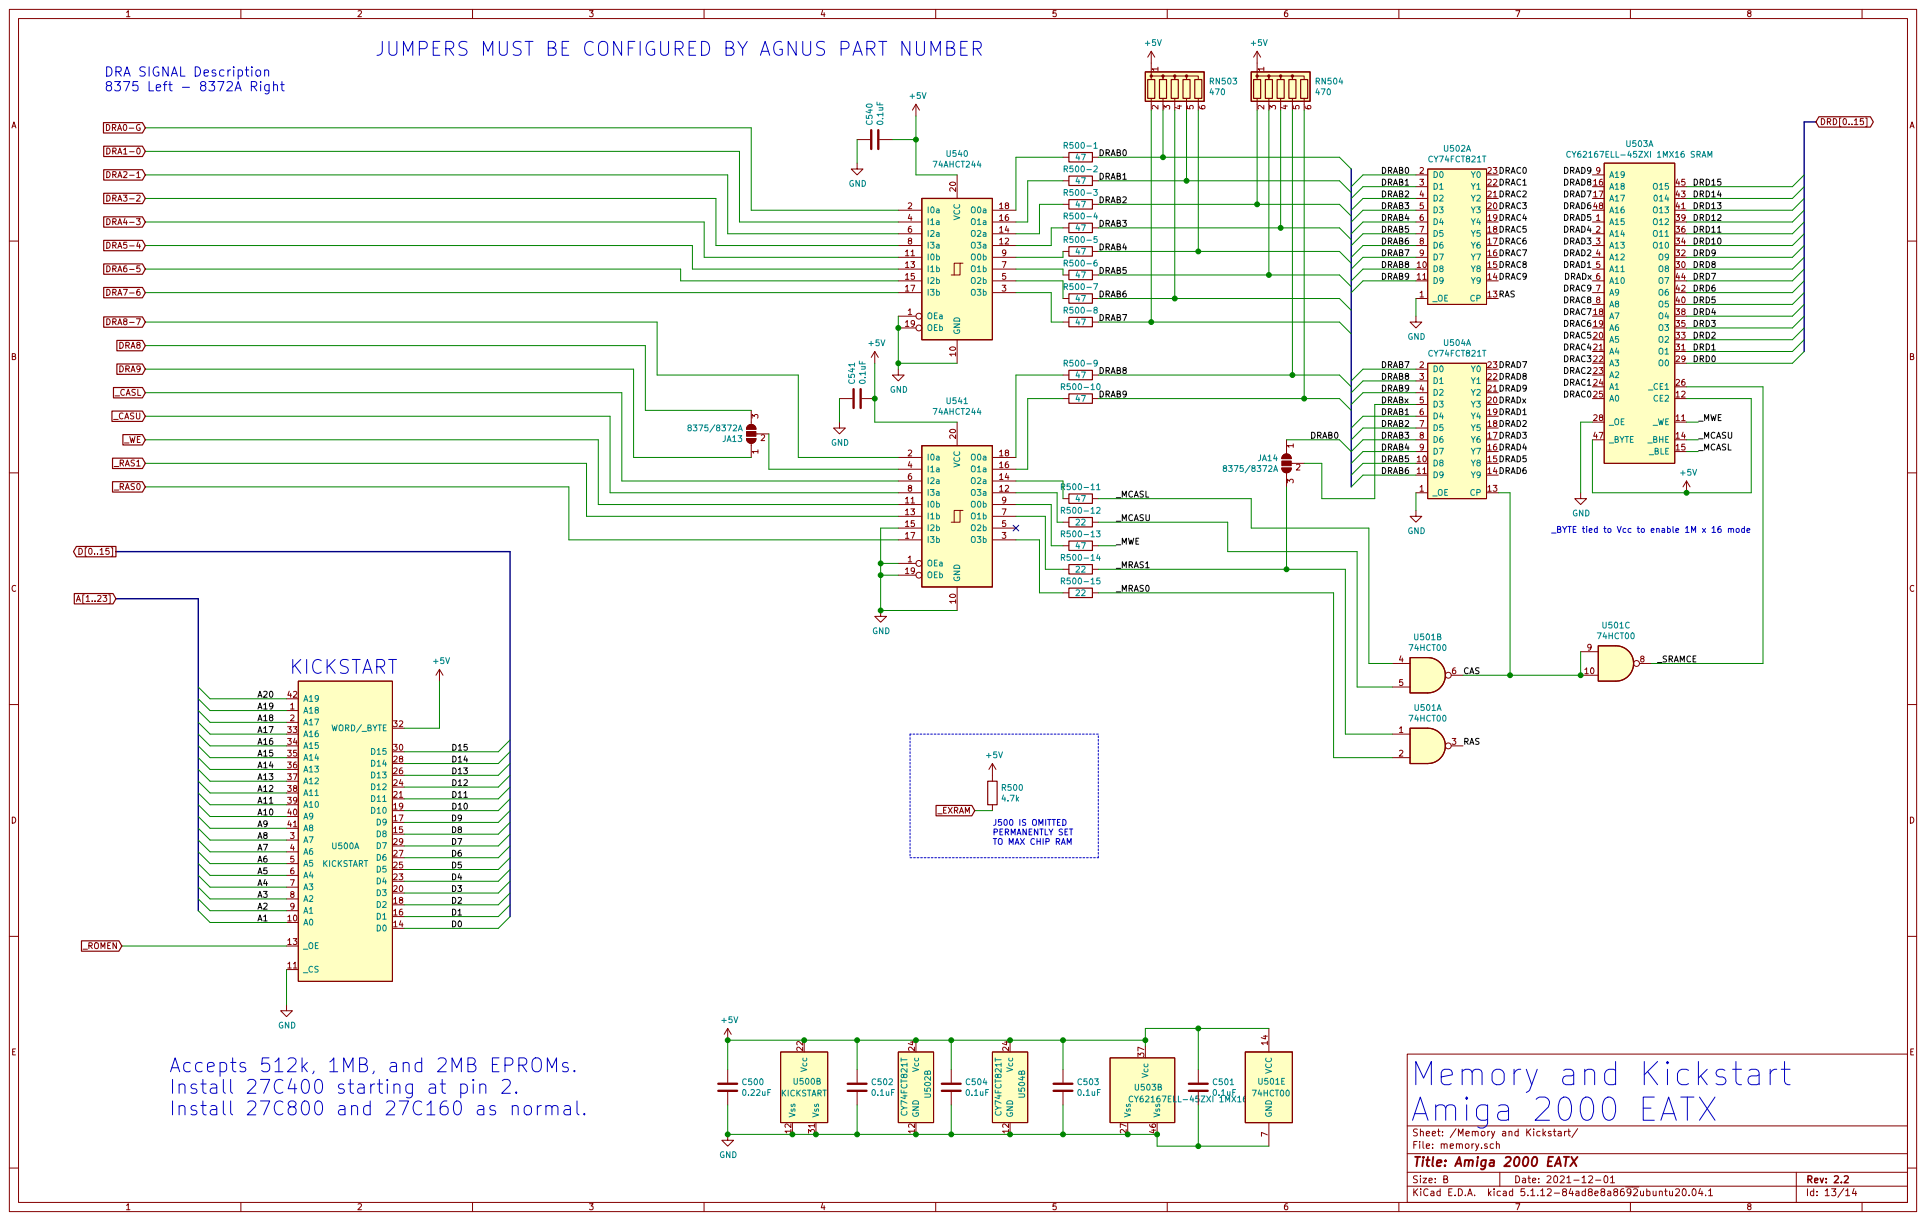
[picture p13: page 13]

_MRAS1 JUMPERS MUST BE CONFIGURED BY AGNUS PART NUMBER

_BYTE tied to Vcc to enable 1M x 16 mode Accepts 512k, 1MB, and 2MB EPROMs.

Install 27C400 starting at pin 2.
Install 27C800 and 27C160 as normal.

Sheet: /Memory and Kickstart/
File: memory.sch
Id: 13/14 Title: Amiga 2000 EATX

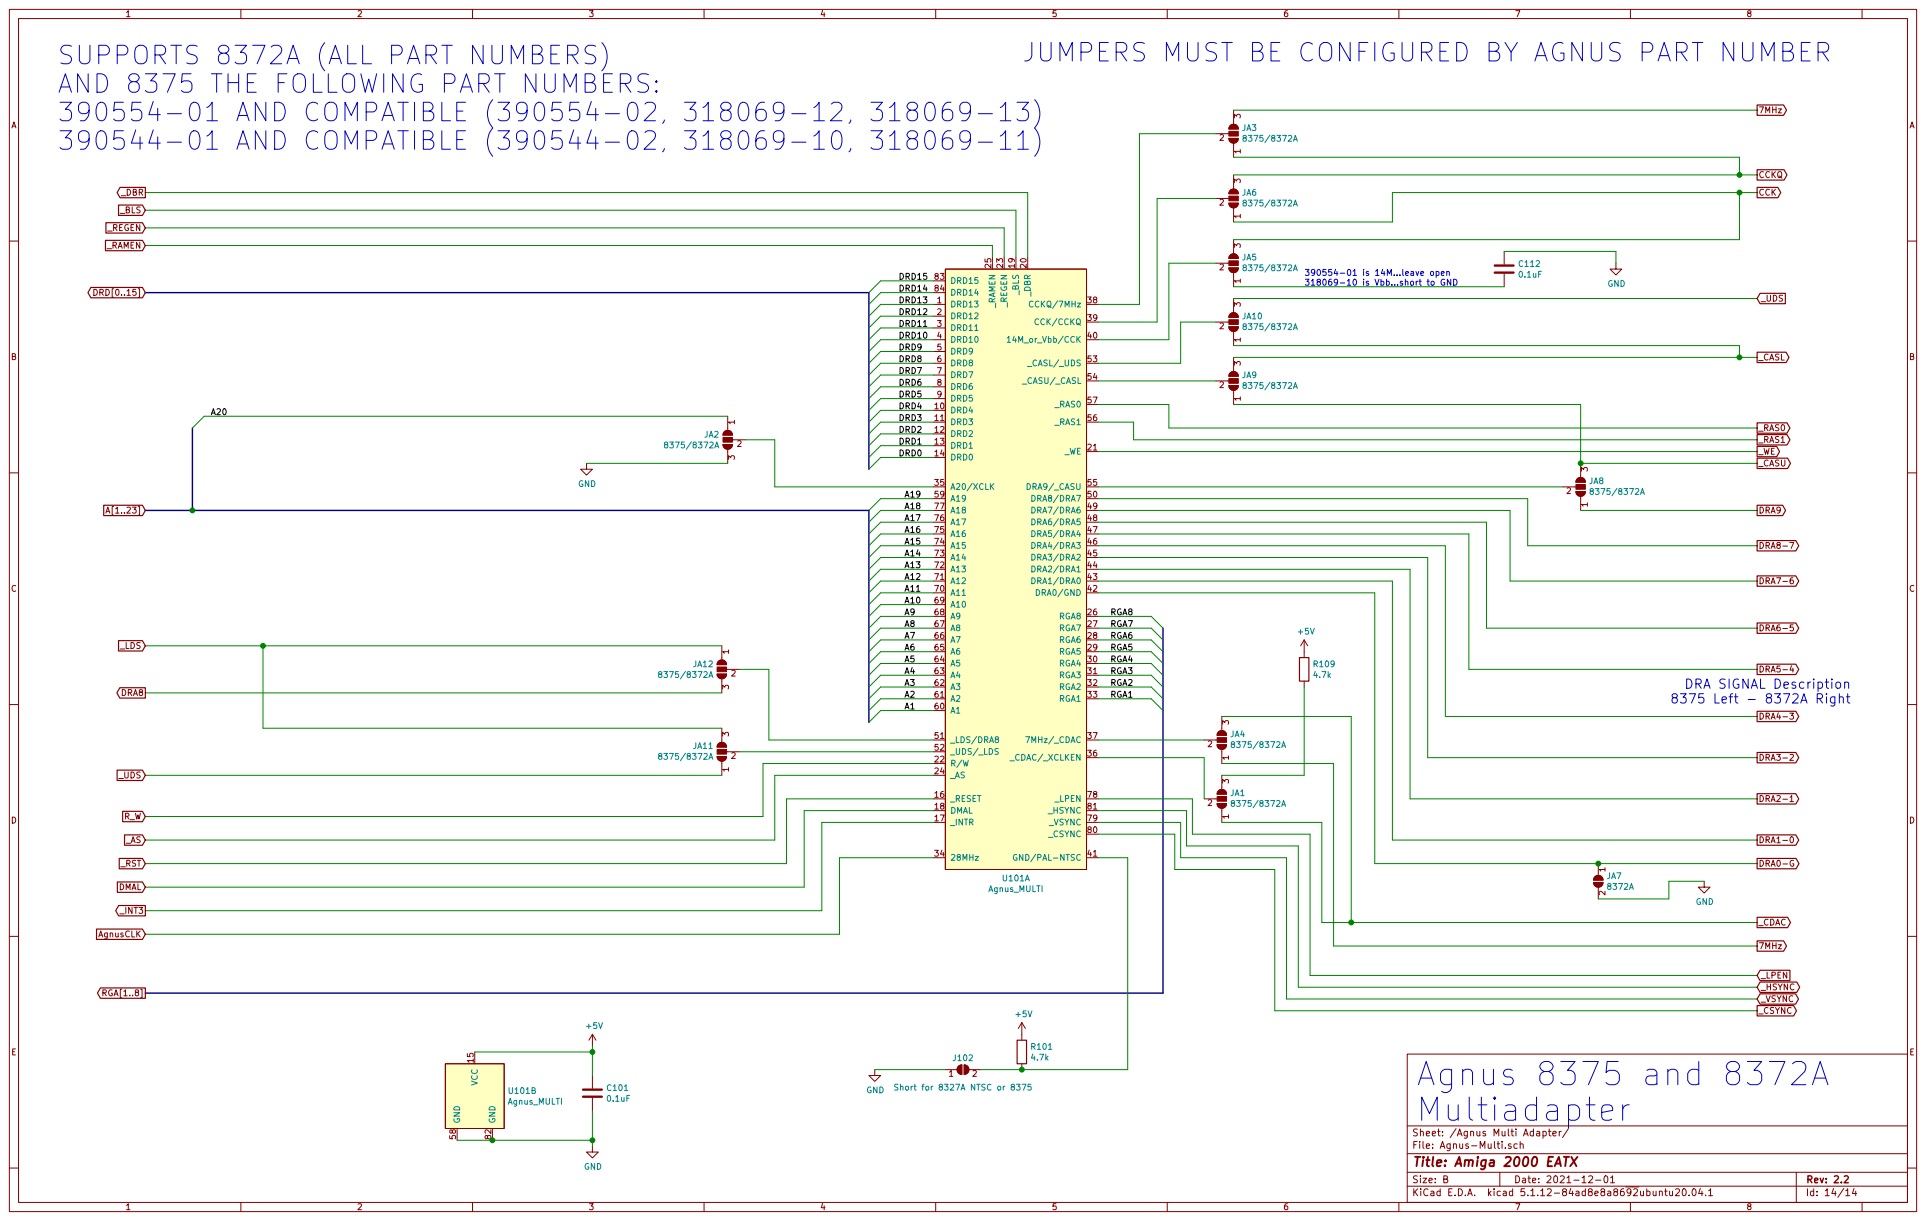
[picture p14: page 14]

318069-10 is Vbb...short to GND SUPPORTS 8372A (ALL PART NUMBERS)
AND 8375 THE FOLLOWING PART NUMBERS:
390554-01 AND COMPATIBLE (390554-02, 318069-12, 318069-13)
390544-01 AND COMPATIBLE (390544-02, 318069-10, 318069-11)

J102 Short for 8327A NTSC or 8375

Sheet: /Agnus Multi Adapter/
File: Agnus-Multi.sch
Id: 14/14 Title: Amiga 2000 EATX
