jgrip/Amiga-2000-EATX/TICK/TICK_OSC/TICK.kicad_pcb

## KiCad design TICK/TICK_OSC/TICK.kicad_pcb (2021-12-11)

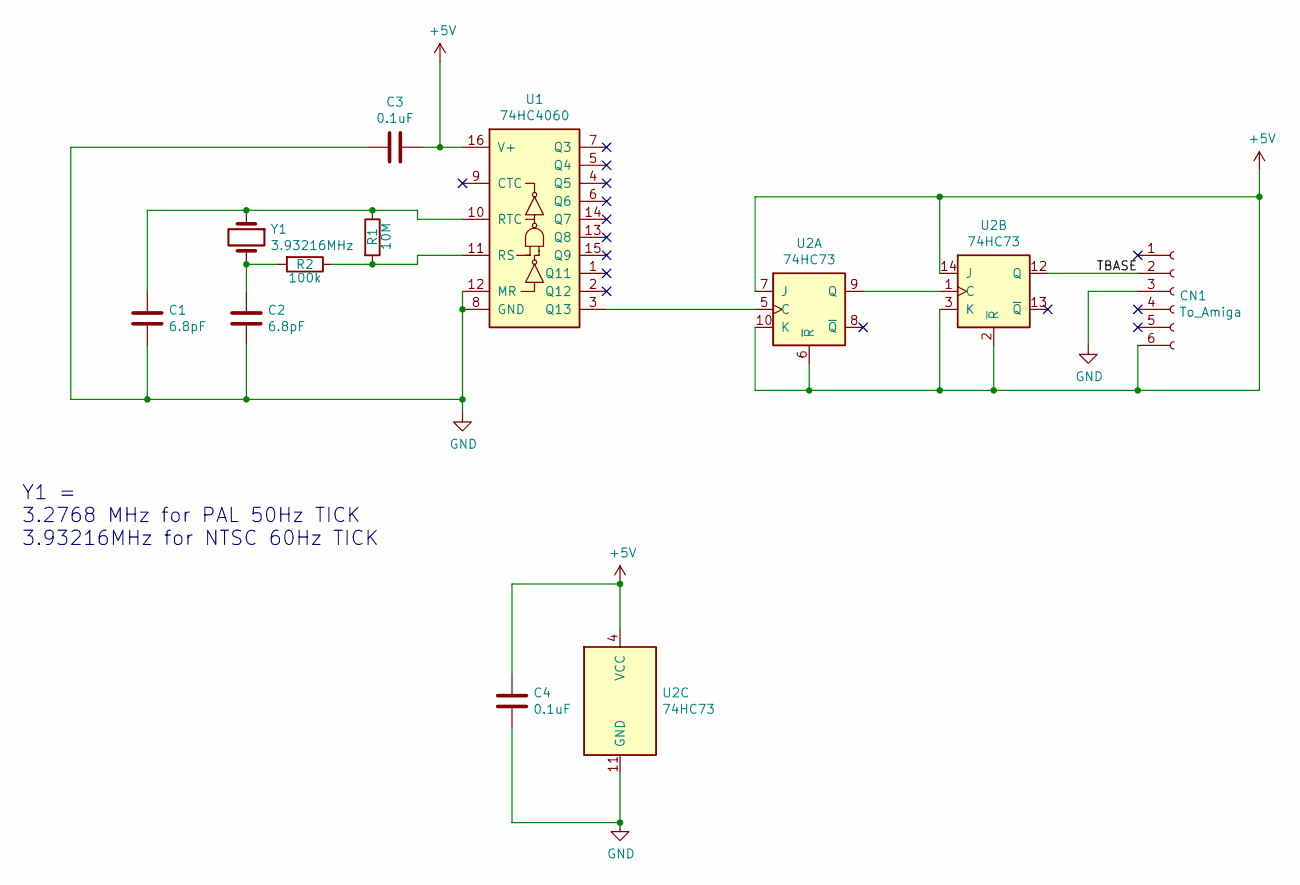
[picture p15: schematic TICK.sch]

Parts:
C1, C2: 6.8pF; C_1206_3216Metric
C3, C4: 0.1uF; C_1206_3216Metric
CN1: To_Amiga; PinSocket_1x06_P2.54mm_Vertical
R1: 10M; R_1206_3216Metric
R2: 100k; R_1206_3216Metric
U1: 74HC4060; SOIC-16_3.9x9.9mm_P1.27mm
U2: 74HC73; SOIC-14_3.9x8.7mm_P1.27mm
Y1: 3.93216MHz; Crystal_HC49-U_Vertical

Connections:
+5V: C3.1, C4.2, CN1.6, U1.16 (V+), U2.2 (~R), U2.3 (K), U2.4 (VCC), U2.6 (~R), U2.7 (J), U2.10 (K), U2.14 (J)
/TBASE: CN1.2, U2.12 (Q)
GND: C1.2, C2.2, C3.2, C4.1, CN1.3, U1.8 (GND), U1.12 (MR), U2.11 (GND)
unnamed: C1.1, R1.1, U1.10 (RTC), Y1.1
unnamed: C2.1, R2.2, Y1.2
unnamed: R1.2, R2.1, U1.11 (RS)
unnamed: U1.3 (Q13), U2.5 (C)
unnamed: U2.1 (C), U2.9 (Q)

Notes on the sheet:
Y1 = 3.2768 MHz for PAL 50Hz TICK 3.93216MHz for NTSC 60Hz TICK

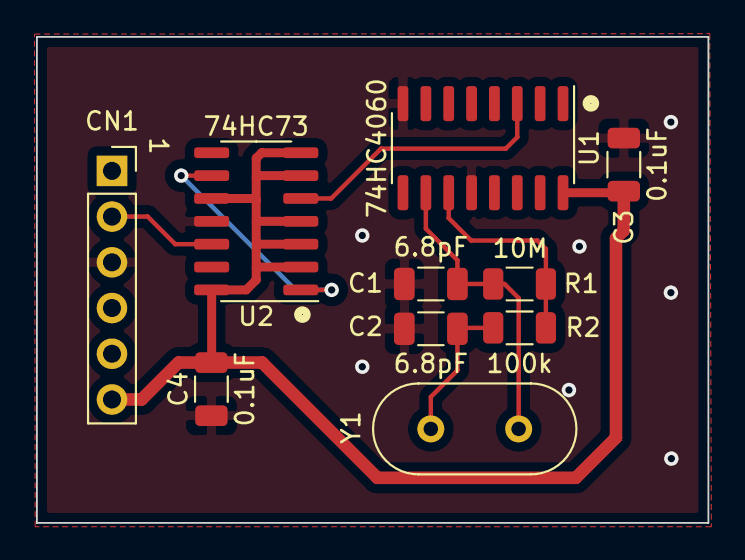
[picture p16: board TICK.kicad_pcb from above]

Board: 2 copper layers, 37.3 x 27.0 mm, 10 parts (0 on the bottom side), 8 nets.
