jgrip/Amiga-2000-EATX/TICK/TICK_AC/TICK_AC.kicad_pcb

## KiCad design TICK/TICK_AC/TICK_AC.kicad_pcb (2021-12-07)

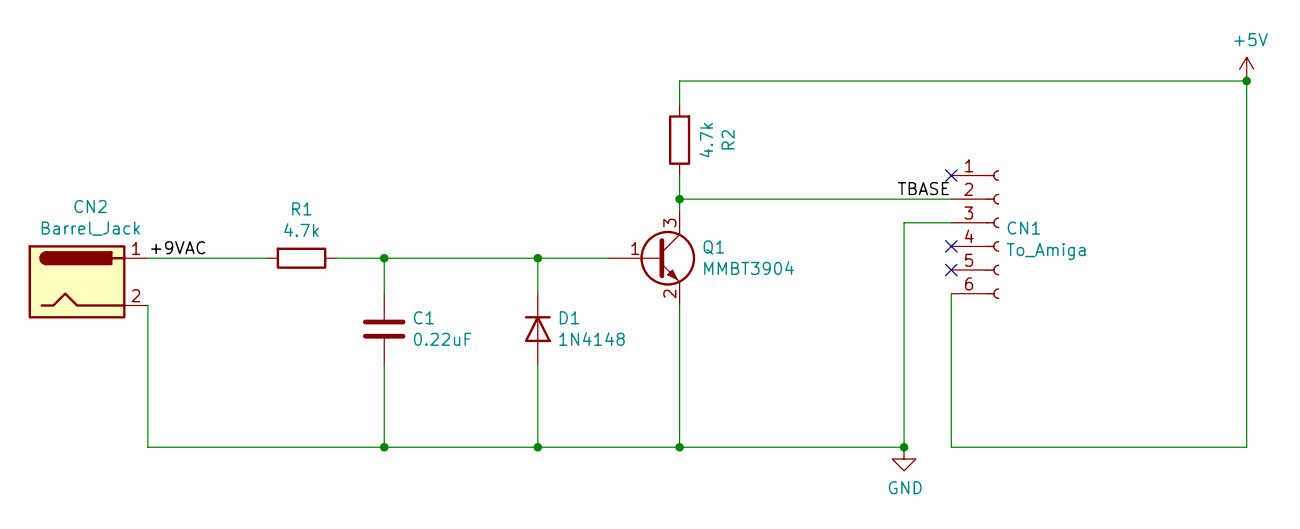
[picture p17: schematic TICK_AC.sch]

Parts:
C1: 0.22uF; C_1206_3216Metric
CN1: To_Amiga; PinSocket_1x06_P2.54mm_Vertical
CN2: Barrel_Jack; BarrelJack_Horizontal
D1: 1N4148; D_SOD-123
Q1: MMBT3904; SOT-23
R1, R2: 4.7k; R_1206_3216Metric

Connections:
+5V: CN1.6, R2.2
/+9VAC: CN2.1, R1.2
/TBASE: CN1.2, Q1.3 (C), R2.1
GND: C1.2, CN1.3, CN2.2, D1.2 (A), Q1.2 (E)
unnamed: C1.1, D1.1 (K), Q1.1 (B), R1.1

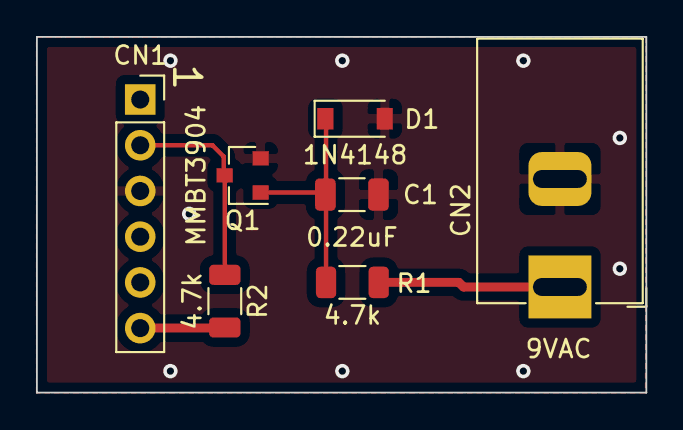
[picture p18: board TICK_AC.kicad_pcb from above]

Board: 2 copper layers, 33.9 x 19.8 mm, 7 parts (0 on the bottom side), 5 nets.
