jgrip/Amiga-2000-EATX/2000EATX-KiCAD-R22/Agnus-Multi.sch

## KiCad design 2000EATX-KiCAD-R22/Agnus-Multi.sch (2021-12-02)

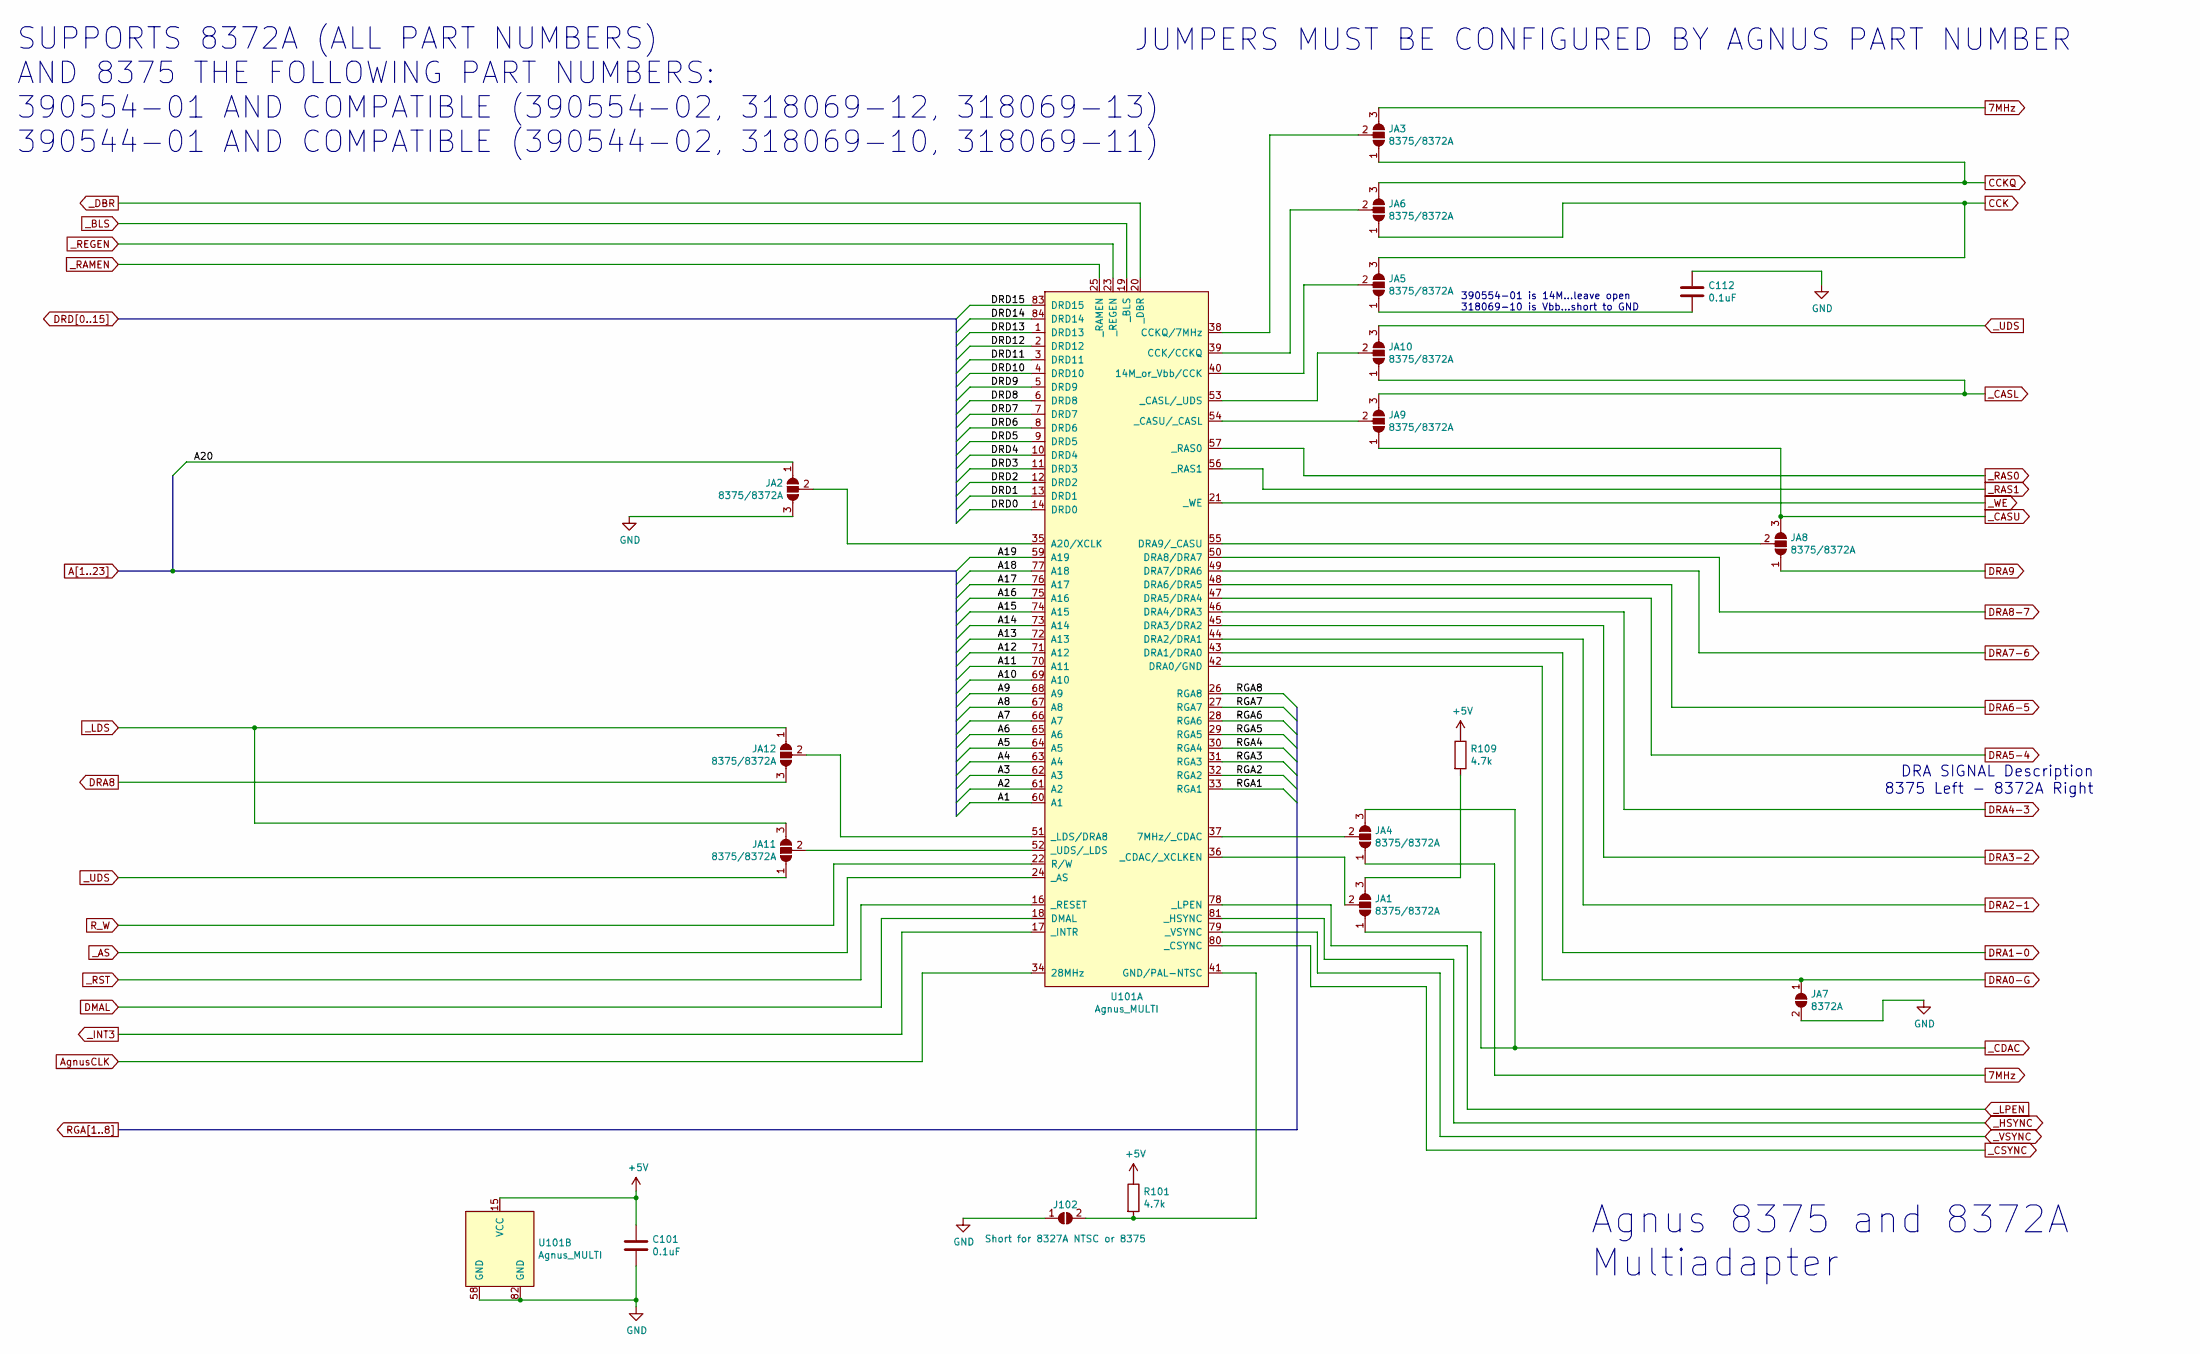
[picture p19: schematic Agnus-Multi.sch]

Parts:
C101, C112: 0.1uF; C_1206_3216Metric
J102: Short for 8327A NTSC or 8375; SolderJumper-2_P1.3mm_Open_RoundedPad1.0x1.5mm
JA1, JA2, JA3, JA4, JA5, JA6, JA8, JA9, JA10, JA11, JA12: 8375/8372A; SolderJumper-3_P1.3mm_Open_RoundedPad1.0x1.5mm
JA7: 8372A; SolderJumper-2_P1.3mm_Open_RoundedPad1.0x1.5mm
R101, R109: 4.7k; R_1206_3216Metric
U101: Agnus_MULTI; PLCC-84_THT-Socket

Connections:
7MHz: JA3.3 (B), JA4.1 (A)
+5V: C101.1, R101.1, R109.1, U101.15 (VCC)
A1: U101.60 (A1)
A2: U101.61 (A2)
A3: U101.62 (A3)
A4: U101.63 (A4)
A5: U101.64 (A5)
A6: U101.65 (A6)
A7: U101.66 (A7)
A8: U101.67 (A8)
A9: U101.68 (A9)
A10: U101.69 (A10)
A11: U101.70 (A11)
A12: U101.71 (A12)
A13: U101.72 (A13)
A14: U101.73 (A14)
A15: U101.74 (A15)
A16: U101.75 (A16)
A17: U101.76 (A17)
A18: U101.77 (A18)
A19: U101.59 (A19)
A20: JA2.1 (A)
AgnusCLK: U101.34 (28MHz)
CCK: JA5.3 (B), JA6.1 (A)
CCKQ: JA3.1 (A), JA6.3 (B)
DMAL: U101.18 (DMAL)
DRA0-G: JA7.1 (A), U101.42 (DRA0/GND)
DRA1-0: U101.43 (DRA1/DRA0)
DRA2-1: U101.44 (DRA2/DRA1)
DRA3-2: U101.45 (DRA3/DRA2)
DRA4-3: U101.46 (DRA4/DRA3)
DRA5-4: U101.47 (DRA5/DRA4)
DRA6-5: U101.48 (DRA6/DRA5)
DRA7-6: U101.49 (DRA7/DRA6)
DRA8: JA12.3 (B)
DRA8-7: U101.50 (DRA8/DRA7)
DRA9: JA8.1 (A)
DRD0: U101.14 (DRD0)
DRD1: U101.13 (DRD1)
DRD2: U101.12 (DRD2)
DRD3: U101.11 (DRD3)
DRD4: U101.10 (DRD4)
DRD5: U101.9 (DRD5)
DRD6: U101.8 (DRD6)
DRD7: U101.7 (DRD7)
DRD8: U101.6 (DRD8)
DRD9: U101.5 (DRD9)
DRD10: U101.4 (DRD10)
DRD11: U101.3 (DRD11)
DRD12: U101.2 (DRD12)
DRD13: U101.1 (DRD13)
DRD14: U101.84 (DRD14)
DRD15: U101.83 (DRD15)
GND: C101.2, C112.1, J102.1 (A), JA2.3 (B), JA7.2 (B), U101.58 (GND), U101.82 (GND)
unnamed: C112.2, JA5.1 (A)
unnamed: J102.2 (B), R101.2, U101.41 (GND/PAL-NTSC)
unnamed: JA1.2 (C), U101.36 (_CDAC/_XCLKEN)
unnamed: JA1.3 (B), R109.2
unnamed: JA2.2 (C), U101.35 (A20/XCLK)
unnamed: JA3.2 (C), U101.38 (CCKQ/7MHz)
unnamed: JA4.2 (C), U101.37 (7MHz/_CDAC)
unnamed: JA5.2 (C), U101.40 (14M_or_Vbb/CCK)
unnamed: JA6.2 (C), U101.39 (CCK/CCKQ)
unnamed: JA8.2 (C), U101.55 (DRA9/_CASU)
unnamed: JA9.2 (C), U101.54 (_CASU/_CASL)
unnamed: JA10.2 (C), U101.53 (_CASL/_UDS)
unnamed: JA11.2 (C), U101.52 (_UDS/_LDS)
unnamed: JA12.2 (C), U101.51 (_LDS/DRA8)
RGA1: U101.33 (RGA1)
RGA2: U101.32 (RGA2)
RGA3: U101.31 (RGA3)
RGA4: U101.30 (RGA4)
RGA5: U101.29 (RGA5)
RGA6: U101.28 (RGA6)
RGA7: U101.27 (RGA7)
RGA8: U101.26 (RGA8)
R_W: U101.22 (R/W)
_AS: U101.24 (_AS)
_BLS: U101.19 (_BLS)
_CASL: JA9.3 (B), JA10.1 (A)
_CASU: JA8.3 (B), JA9.1 (A)
_CDAC: JA1.1 (A), JA4.3 (B)
_CSYNC: U101.80 (_CSYNC)
_DBR: U101.20 (_DBR)
_HSYNC: U101.81 (_HSYNC)
_INT3: U101.17 (_INTR)
_LDS: JA11.3 (B), JA12.1 (A)
_LPEN: U101.78 (_LPEN)
_RAMEN: U101.25 (_RAMEN)
_RAS0: U101.57 (_RAS0)
_RAS1: U101.56 (_RAS1)
_REGEN: U101.23 (_REGEN)
_RST: U101.16 (_RESET)
_UDS: JA10.3 (B), JA11.1 (A)
_VSYNC: U101.79 (_VSYNC)
_WE: U101.21 (_WE)

Notes on the sheet:
Agnus 8375 and 8372A Multiadapter
390554-01 is 14M...leave open 318069-10 is Vbb...short to GND
SUPPORTS 8372A (ALL PART NUMBERS) AND 8375 THE FOLLOWING PART NUMBERS: 390554-01 AND COMPATIBLE (390554-02, 318069-12, 318069-13) 390544-01 AND COMPATIBLE (390544-02, 318069-10, 318069-11)
JUMPERS MUST BE CONFIGURED BY AGNUS PART NUMBER
DRA SIGNAL Description 8375 Left - 8372A Right
