jgrip/Amiga-2000-EATX/2000EATX-KiCAD-R22/Processor.sch

## KiCad design 2000EATX-KiCAD-R22/Processor.sch (2021-12-02)

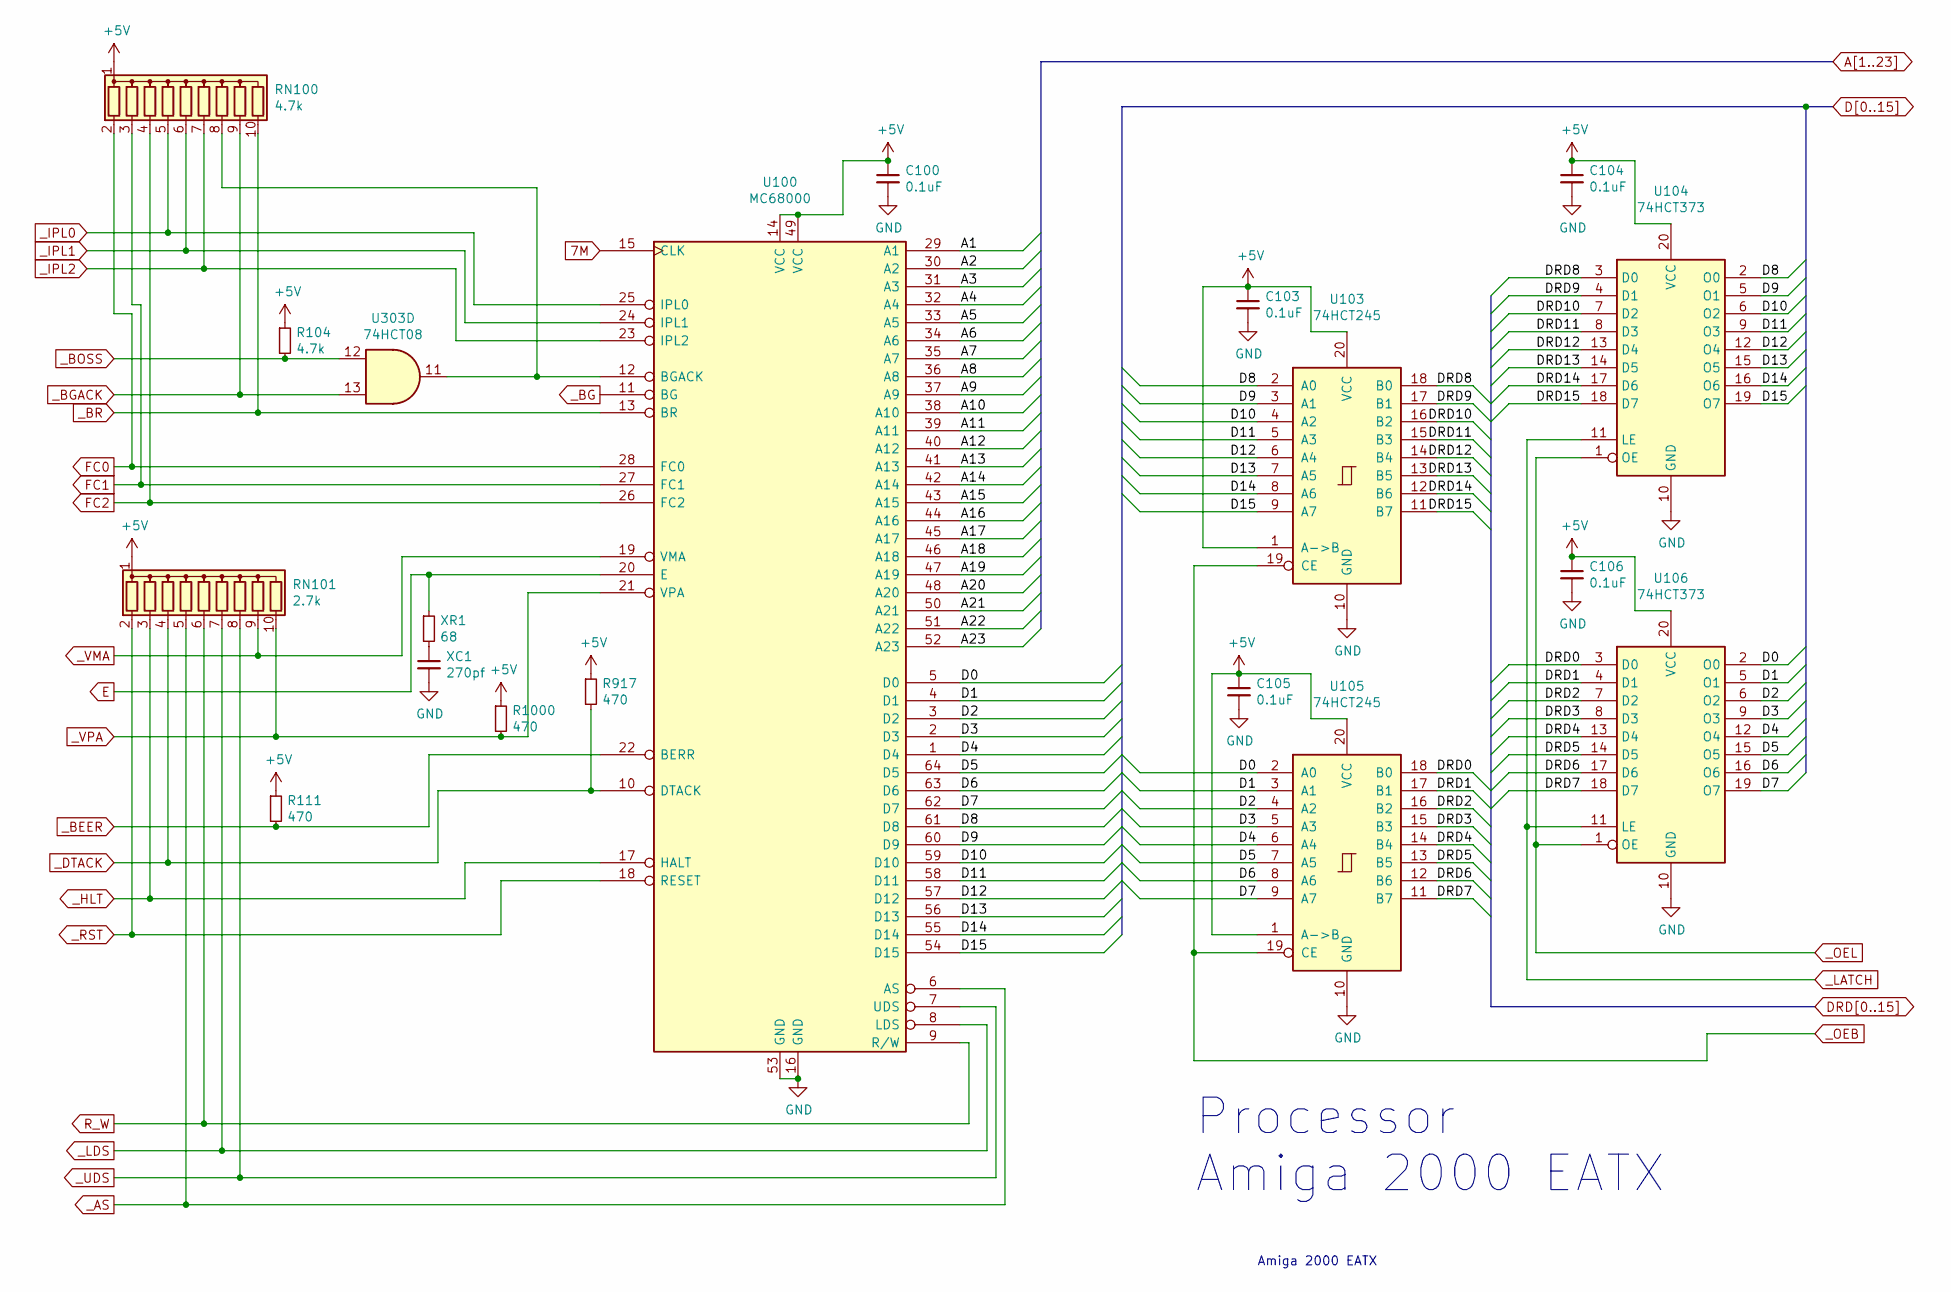
[picture p20: schematic Processor.sch]

Parts:
C100, C103, C104, C105, C106: 0.1uF; C_1206_3216Metric
R104: 4.7k; R_1206_3216Metric
R111, R917, R1000: 470; R_1206_3216Metric
RN100: 4.7k; R_Array_SIP10
RN101: 2.7k; R_Array_SIP10
U100: MC68000; DIP-64_W22.86mm_Socket
U103, U105: 74HCT245; SOIC-20W_7.5x12.8mm_P1.27mm
U104, U106: 74HCT373; SOIC-20W_7.5x12.8mm_P1.27mm
U303: 74HCT08; SOIC-14_3.9x8.7mm_P1.27mm
XC1: 270pf; C_1206_3216Metric
XR1: 68; R_1206_3216Metric

Connections:
7M: U100.15 (CLK)
+5V: C100.1, C103.1, C104.1, C105.1, C106.1, R104.1, R111.1, R917.1, R1000.1, RN100.1 (common), RN101.1 (common), U100.14 (VCC), U100.49 (VCC), U103.1 (A->B), U103.20 (VCC), U104.20 (VCC), U105.1 (A->B), U105.20 (VCC), U106.20 (VCC)
A1: U100.29 (A1)
A2: U100.30 (A2)
A3: U100.31 (A3)
A4: U100.32 (A4)
A5: U100.33 (A5)
A6: U100.34 (A6)
A7: U100.35 (A7)
A8: U100.36 (A8)
A9: U100.37 (A9)
A10: U100.38 (A10)
A11: U100.39 (A11)
A12: U100.40 (A12)
A13: U100.41 (A13)
A14: U100.42 (A14)
A15: U100.43 (A15)
A16: U100.44 (A16)
A17: U100.45 (A17)
A18: U100.46 (A18)
A19: U100.47 (A19)
A20: U100.48 (A20)
A21: U100.50 (A21)
A22: U100.51 (A22)
A23: U100.52 (A23)
D0: U100.5 (D0), U105.2 (A0), U106.2 (O0)
D1: U100.4 (D1), U105.3 (A1), U106.5 (O1)
D2: U100.3 (D2), U105.4 (A2), U106.6 (O2)
D3: U100.2 (D3), U105.5 (A3), U106.9 (O3)
D4: U100.1 (D4), U105.6 (A4), U106.12 (O4)
D5: U100.64 (D5), U105.7 (A5), U106.15 (O5)
D6: U100.63 (D6), U105.8 (A6), U106.16 (O6)
D7: U100.62 (D7), U105.9 (A7), U106.19 (O7)
D8: U100.61 (D8), U103.2 (A0), U104.2 (O0)
D9: U100.60 (D9), U103.3 (A1), U104.5 (O1)
D10: U100.59 (D10), U103.4 (A2), U104.6 (O2)
D11: U100.58 (D11), U103.5 (A3), U104.9 (O3)
D12: U100.57 (D12), U103.6 (A4), U104.12 (O4)
D13: U100.56 (D13), U103.7 (A5), U104.15 (O5)
D14: U100.55 (D14), U103.8 (A6), U104.16 (O6)
D15: U100.54 (D15), U103.9 (A7), U104.19 (O7)
DRD0: U105.18 (B0), U106.3 (D0)
DRD1: U105.17 (B1), U106.4 (D1)
DRD2: U105.16 (B2), U106.7 (D2)
DRD3: U105.15 (B3), U106.8 (D3)
DRD4: U105.14 (B4), U106.13 (D4)
DRD5: U105.13 (B5), U106.14 (D5)
DRD6: U105.12 (B6), U106.17 (D6)
DRD7: U105.11 (B7), U106.18 (D7)
DRD8: U103.18 (B0), U104.3 (D0)
DRD9: U103.17 (B1), U104.4 (D1)
DRD10: U103.16 (B2), U104.7 (D2)
DRD11: U103.15 (B3), U104.8 (D3)
DRD12: U103.14 (B4), U104.13 (D4)
DRD13: U103.13 (B5), U104.14 (D5)
DRD14: U103.12 (B6), U104.17 (D6)
DRD15: U103.11 (B7), U104.18 (D7)
E: U100.20 (E), XR1.1
FC0: RN100.2 (R1), U100.28 (FC0)
FC1: RN100.3 (R2), U100.27 (FC1)
FC2: RN100.4 (R3), U100.26 (FC2)
GND: C100.2, C103.2, C104.2, C105.2, C106.2, U100.16 (GND), U100.53 (GND), U103.10 (GND), U104.10 (GND), U105.10 (GND), U106.10 (GND), XC1.2
unnamed: RN100.8 (R7), U100.12 (BGACK), U303.11
unnamed: XC1.1, XR1.2
R_W: RN101.6 (R5), U100.9 (R/W)
_AS: RN101.5 (R4), U100.6 (AS)
_BEER: R111.2, U100.22 (BERR)
_BG: U100.11 (BG)
_BGACK: RN100.9 (R8), U303.13
_BOSS: R104.2, U303.12
_BR: RN100.10 (R9), U100.13 (BR)
_DTACK: R917.2, RN101.4 (R3), U100.10 (DTACK)
_HLT: RN101.3 (R2), U100.17 (HALT)
_IPL0: RN100.5 (R4), U100.25 (IPL0)
_IPL1: RN100.6 (R5), U100.24 (IPL1)
_IPL2: RN100.7 (R6), U100.23 (IPL2)
_LATCH: U104.11 (LE), U106.11 (LE)
_LDS: RN101.7 (R6), U100.8 (LDS)
_OEB: U103.19 (CE), U105.19 (CE)
_OEL: U104.1 (OE), U106.1 (OE)
_RST: RN101.2 (R1), U100.18 (RESET)
_UDS: RN101.8 (R7), U100.7 (UDS)
_VMA: RN101.9 (R8), U100.19 (VMA)
_VPA: R1000.2, RN101.10 (R9), U100.21 (VPA)

Notes on the sheet:
Processor Amiga 2000 EATX
Amiga 2000 EATX
