jgrip/Amiga-2000-EATX/2000EATX-KiCAD-R22/Zorro_Expansion.sch

## KiCad design 2000EATX-KiCAD-R22/Zorro_Expansion.sch (2021-12-02)

Schematic: Zorro_Expansion.sch

Parts:
C416, C417, C418, C419: 220uF; CP_Elec_8x10
C606: 0.1uF; C_1206_3216Metric
C617, C619, C620, C621, C622, C623, C624, C625, C626, C627, C628, C629, C630, C631, C632, C633, C635, C637, C639, C641, C645, C647, C649, C650, C651, C652, C654, C655, C657, C658, C659, C660, C661, C662, C663, C664, C665, C666, C667, C668, C669, C670, C671, C672, C673, C674, C675: 1000pF; C_0805_2012Metric
CN601, CN602, CN603, CN604, CN605: Amiga-2000-Zorro-Slot; Samtec_HLE-150-02-xx-DV-TE_2x50_P2.54mm_Horizontal
R311, R312, R601, R603: 1k; R_1206_3216Metric
R601A1, R601B1, R601C1, R601D1, R601E1, R601F1, R601G1, R601H1, R601I1, R602A1, R602B1, R602C1, R602D1, R602E1, R602F1, R602G1, R602H1, R602I1, R603A1, R603B1, R603C1, R603D1, R603E1, R603F1, R603G1, R603H1, R603I1, R604, R604A1, R604B1, R604C1, R604D1, R604E1, R604F1, R604G1, R604H1, R604I1, R605, R605A1, R605B1, R605C1, R605D1, R605E1, R605F1, R605G1, R605H1, R605I1: 1k; R_0805_2012Metric
RN600: 10k; R_Array_SIP6
RN607: 1k; R_Array_SIP6
U606: 74HCT32; SOIC-14_3.9x8.7mm_P1.27mm

Connections:
+5V: C416.1, C417.1, C418.1, C419.1, C606.1, CN601.5, CN601.6, CN602.5, CN602.6, CN603.5, CN603.6, CN604.5, CN604.6, CN605.5, CN605.6, R311.1, R312.1, R601.1, R603.1, RN600.1 (common), U606.14 (VCC)
+12V: CN601.10, CN602.10, CN603.10, CN604.10, CN605.10
-5V: CN601.8, CN602.8, CN603.8, CN604.8, CN605.8
-12V: CN601.20, CN602.20, CN603.20, CN604.20, CN605.20
BA1: C624.2, CN601.29, CN602.29, CN603.29, CN604.29, CN605.29
BA2: C622.2, CN601.27, CN602.27, CN603.27, CN604.27, CN605.27
BA3: C621.2, CN601.26, CN602.26, CN603.26, CN604.26, CN605.26
BA4: C620.2, CN601.24, CN602.24, CN603.24, CN604.24, CN605.24
BA5: C617.2, CN601.21, CN602.21, CN603.21, CN604.21, CN605.21
BA6: C619.2, CN601.23, CN602.23, CN603.23, CN604.23, CN605.23
BA7: C623.2, CN601.28, CN602.28, CN603.28, CN604.28, CN605.28
BA8: C625.2, CN601.30, CN602.30, CN603.30, CN604.30, CN605.30
BA9: C627.2, CN601.32, CN602.32, CN603.32, CN604.32, CN605.32
BA10: C629.2, CN601.34, CN602.34, CN603.34, CN604.34, CN605.34
BA11: C631.2, CN601.36, CN602.36, CN603.36, CN604.36, CN605.36
BA12: C632.2, CN601.38, CN602.38, CN603.38, CN604.38, CN605.38
BA13: C633.2, CN601.39, CN602.39, CN603.39, CN604.39, CN605.39
BA14: C635.2, CN601.41, CN602.41, CN603.41, CN604.41, CN605.41
BA15: C637.2, CN601.43, CN602.43, CN603.43, CN604.43, CN605.43
BA16: C639.2, CN601.45, CN602.45, CN603.45, CN604.45, CN605.45
BA17: C641.2, CN601.47, CN602.47, CN603.47, CN604.47, CN605.47
BA18: C645.2, CN601.52, CN602.52, CN603.52, CN604.52, CN605.52
BA19: C647.2, CN601.54, CN602.54, CN603.54, CN604.54, CN605.54
BA20: C649.2, CN601.56, CN602.56, CN603.56, CN604.56, CN605.56
BA21: C651.2, CN601.58, CN602.58, CN603.58, CN604.58, CN605.58
BA22: C650.2, CN601.57, CN602.57, CN603.57, CN604.57, CN605.57
BA23: C652.2, CN601.59, CN602.59, CN603.59, CN604.59, CN605.59
BD0: C664.2, CN601.75, CN602.75, CN603.75, CN604.75, CN605.75
BD1: C666.2, CN601.77, CN602.77, CN603.77, CN604.77, CN605.77
BD2: C668.2, CN601.79, CN602.79, CN603.79, CN604.79, CN605.79
BD3: C670.2, CN601.81, CN602.81, CN603.81, CN604.81, CN605.81
BD4: C672.2, CN601.83, CN602.83, CN603.83, CN604.83, CN605.83
BD5: C674.2, CN601.86, CN602.86, CN603.86, CN604.86, CN605.86
BD6: C673.2, CN601.84, CN602.84, CN603.84, CN604.84, CN605.84
BD7: C671.2, CN601.82, CN602.82, CN603.82, CN604.82, CN605.82
BD8: C669.2, CN601.80, CN602.80, CN603.80, CN604.80, CN605.80
BD9: C667.2, CN601.78, CN602.78, CN603.78, CN604.78, CN605.78
BD10: C665.2, CN601.76, CN602.76, CN603.76, CN604.76, CN605.76
BD11: C661.2, CN601.71, CN602.71, CN603.71, CN604.71, CN605.71
BD12: C659.2, CN601.69, CN602.69, CN603.69, CN604.69, CN605.69
BD13: C657.2, CN601.67, CN602.67, CN603.67, CN604.67, CN605.67
BD14: C655.2, CN601.65, CN602.65, CN603.65, CN604.65, CN605.65
BD15: C654.2, CN601.63, CN602.63, CN603.63, CN604.63, CN605.63
BFC0: C626.2, CN601.31, CN602.31, CN603.31, CN604.31, CN605.31
BFC1: C628.2, CN601.33, CN602.33, CN603.33, CN604.33, CN605.33
BFC2: C630.2, CN601.35, CN602.35, CN603.35, CN604.35, CN605.35
DOE: CN601.93, CN602.93, CN603.93, CN604.93, CN605.93, R601.2
E: CN601.50, CN602.50, CN603.50, CN604.50, CN605.50
E7M: CN601.92, CN602.92, CN603.92, CN604.92, CN605.92
ECDAC: CN601.15, CN602.15, CN603.15, CN604.15, CN605.15
GND: C416.2, C417.2, C418.2, C419.2, C606.2, CN601.1, CN601.2, CN601.3, CN601.4, CN601.13, CN601.25, CN601.37, CN601.49, CN601.61, CN601.73, CN601.85, CN601.87, CN601.88, CN601.89, CN601.90, CN601.91, CN601.99, CN601.100, CN602.1, CN602.2, CN602.3, CN602.4, CN602.13, CN602.25, CN602.37, CN602.49, CN602.61, CN602.73, CN602.85, CN602.87, CN602.88, CN602.89, CN602.90, CN602.91, CN602.99, CN602.100, CN603.1, CN603.2, CN603.3, CN603.4, CN603.13, CN603.25, CN603.37, CN603.49, CN603.61, CN603.73, CN603.85, CN603.87, CN603.88, CN603.89, CN603.90, CN603.91, CN603.99, CN603.100, CN604.1, CN604.2, CN604.3, CN604.4, CN604.13, CN604.25, CN604.37, CN604.49, CN604.61, CN604.73, CN604.85, CN604.87, CN604.88, CN604.89, CN604.90, CN604.91, CN604.99, CN604.100, CN605.1, CN605.2, CN605.3, CN605.4, CN605.13, CN605.25, CN605.37, CN605.49, CN605.61, CN605.73, CN605.85, CN605.87, CN605.88, CN605.89, CN605.90, CN605.91, CN605.99, CN605.100, R601A1.1, R601B1.1, R601C1.1, R601D1.1, R601E1.1, R601F1.1, R601G1.1, R601H1.1, R601I1.1, R602A1.1, R602B1.1, R602C1.1, R602D1.1, R602E1.1, R602F1.1, R602G1.1, R602H1.1, R602I1.1, R603A1.1, R603B1.1, R603C1.1, R603D1.1, R603E1.1, R603F1.1, R603G1.1, R603H1.1, R603I1.1, R604.1, R604A1.1, R604B1.1, R604C1.1, R604D1.1, R604E1.1, R604F1.1, R604G1.1, R604H1.1, R604I1.1, R605.1, R605A1.1, R605B1.1, R605C1.1, R605D1.1, R605E1.1, R605F1.1, R605G1.1, R605H1.1, R605I1.1, RN607.1 (common), U606.7 (GND)
unnamed: C617.1, R601A1.2
unnamed: C619.1, R601B1.2
unnamed: C620.1, R601C1.2
unnamed: C621.1, R601D1.2
unnamed: C622.1, R601E1.2
unnamed: C623.1, R601F1.2
unnamed: C624.1, R601G1.2
unnamed: C625.1, R601H1.2
unnamed: C626.1, R601I1.2
unnamed: C627.1, R602A1.2
unnamed: C628.1, R602B1.2
unnamed: C629.1, R602C1.2
unnamed: C630.1, R602D1.2
unnamed: C631.1, R602E1.2
unnamed: C632.1, R602F1.2
unnamed: C633.1, R602G1.2
unnamed: C635.1, R602H1.2
unnamed: C637.1, R602I1.2
unnamed: C639.1, R603A1.2
unnamed: C641.1, R603B1.2
unnamed: C645.1, R603C1.2
unnamed: C647.1, R603D1.2
unnamed: C649.1, R603E1.2
unnamed: C650.1, R603F1.2
unnamed: C651.1, R603G1.2
unnamed: C652.1, R603H1.2
unnamed: C654.1, R603I1.2
unnamed: C655.1, R604A1.2
unnamed: C657.1, R604B1.2
unnamed: C658.1, R604C1.2
unnamed: C659.1, R604D1.2
unnamed: C660.1, R604E1.2
unnamed: C661.1, R604F1.2
unnamed: C662.1, R604G1.2
unnamed: C663.1, R604H1.2
unnamed: C664.1, R604I1.2
unnamed: C665.1, R604.2
unnamed: C666.1, R605.2
unnamed: C667.1, R605A1.2
unnamed: C668.1, R605B1.2
unnamed: C669.1, R605C1.2
unnamed: C670.1, R605D1.2
unnamed: C671.1, R605E1.2
unnamed: C672.1, R605F1.2
unnamed: C673.1, R605G1.2
unnamed: C674.1, R605H1.2
unnamed: C675.1, R605I1.2
unnamed: CN601.97, CN602.97, CN603.97, CN604.97, CN605.97
unnamed: CN601.98, CN602.98, CN603.98, CN604.98, CN605.98
READ: C658.2, CN601.68, CN602.68, CN603.68, CN604.68, CN605.68
XRDY: CN601.18, CN602.18, CN603.18, CN604.18, CN605.18
_BAS: C663.2, CN601.74, CN602.74, CN603.74, CN604.74, CN605.74
_BEER: CN601.46, CN602.46, CN603.46, CN604.46, CN605.46
_BGACK: CN601.62, CN602.62, CN603.62, CN604.62, CN605.62
_BLDS: C660.2, CN601.70, CN602.70, CN603.70, CN604.70, CN605.70
_BUDS: C662.2, CN601.72, CN602.72, CN603.72, CN604.72, CN605.72
_BUSRST: CN601.94, CN602.94, CN603.94, CN604.94, CN605.94, R603.2
_CFGIN2: CN604.12, U606.1, U606.11
_CFGIN3: CN603.12, U606.3, U606.4
_CFGIN4: CN602.12, U606.6, U606.9
_CFGIN5: CN601.12, U606.8
_CFGOUT1: CN605.11, RN607.5 (R4), U606.13
_CFGOUT2: CN604.11, RN607.4 (R3), U606.2
_CFGOUT3: CN603.11, RN607.3 (R2), U606.5
_CFGOUT4: CN602.11, RN607.2 (R1), U606.10
_COPCFG: CN605.12, RN607.6 (R5), U606.12
_DTACK: CN601.66, CN602.66, CN603.66, CN604.66, CN605.66
_EBG1: CN605.64
_EBG2: CN604.64
_EBG3: CN603.64
_EBG4: CN602.64
_EBG5: CN601.64
_EBR1: CN605.60, RN600.2 (R1)
_EBR2: CN604.60, RN600.3 (R2)
_EBR3: CN603.60, RN600.4 (R3)
_EBR4: CN602.60, RN600.5 (R4)
_EBR5: CN601.60, RN600.6 (R5)
_EC1: CN601.16, CN602.16, CN603.16, CN604.16, CN605.16
_EC3: CN601.14, CN602.14, CN603.14, CN604.14, CN605.14
_EINT1: C675.2, CN601.96, CN602.96, CN603.96, CN604.96, CN605.96
_EINT4: CN601.44, CN602.44, CN603.44, CN604.44, CN605.44
_EINT5: CN601.42, CN602.42, CN603.42, CN604.42, CN605.42
_EINT7: CN601.40, CN602.40, CN603.40, CN604.40, CN605.40
_GBG: CN601.95, CN602.95, CN603.95, CN604.95, CN605.95
_HLT: CN601.55, CN602.55, CN603.55, CN604.55, CN605.55
_INT2: CN601.19, CN602.19, CN603.19, CN604.19, CN605.19, R312.2
_INT6: CN601.22, CN602.22, CN603.22, CN604.22, CN605.22, R311.2
_OVR: CN601.17, CN602.17, CN603.17, CN604.17, CN605.17
_OWN: CN601.7, CN602.7, CN603.7, CN604.7, CN605.7
_RST: CN601.53, CN602.53, CN603.53, CN604.53, CN605.53
_SLAVE1: CN605.9
_SLAVE2: CN604.9
_SLAVE3: CN603.9
_SLAVE4: CN602.9
_SLAVE5: CN601.9
_VMA: CN601.51, CN602.51, CN603.51, CN604.51, CN605.51
_VPA: CN601.48, CN602.48, CN603.48, CN604.48, CN605.48

Notes on the sheet:
Zorro 2 Expansion Slots Amiga 2000 EATX
