jgrip/Amiga-2000-EATX/2000EATX-KiCAD-R22/agnus.sch

## KiCad design 2000EATX-KiCAD-R22/agnus.sch (2021-12-02)

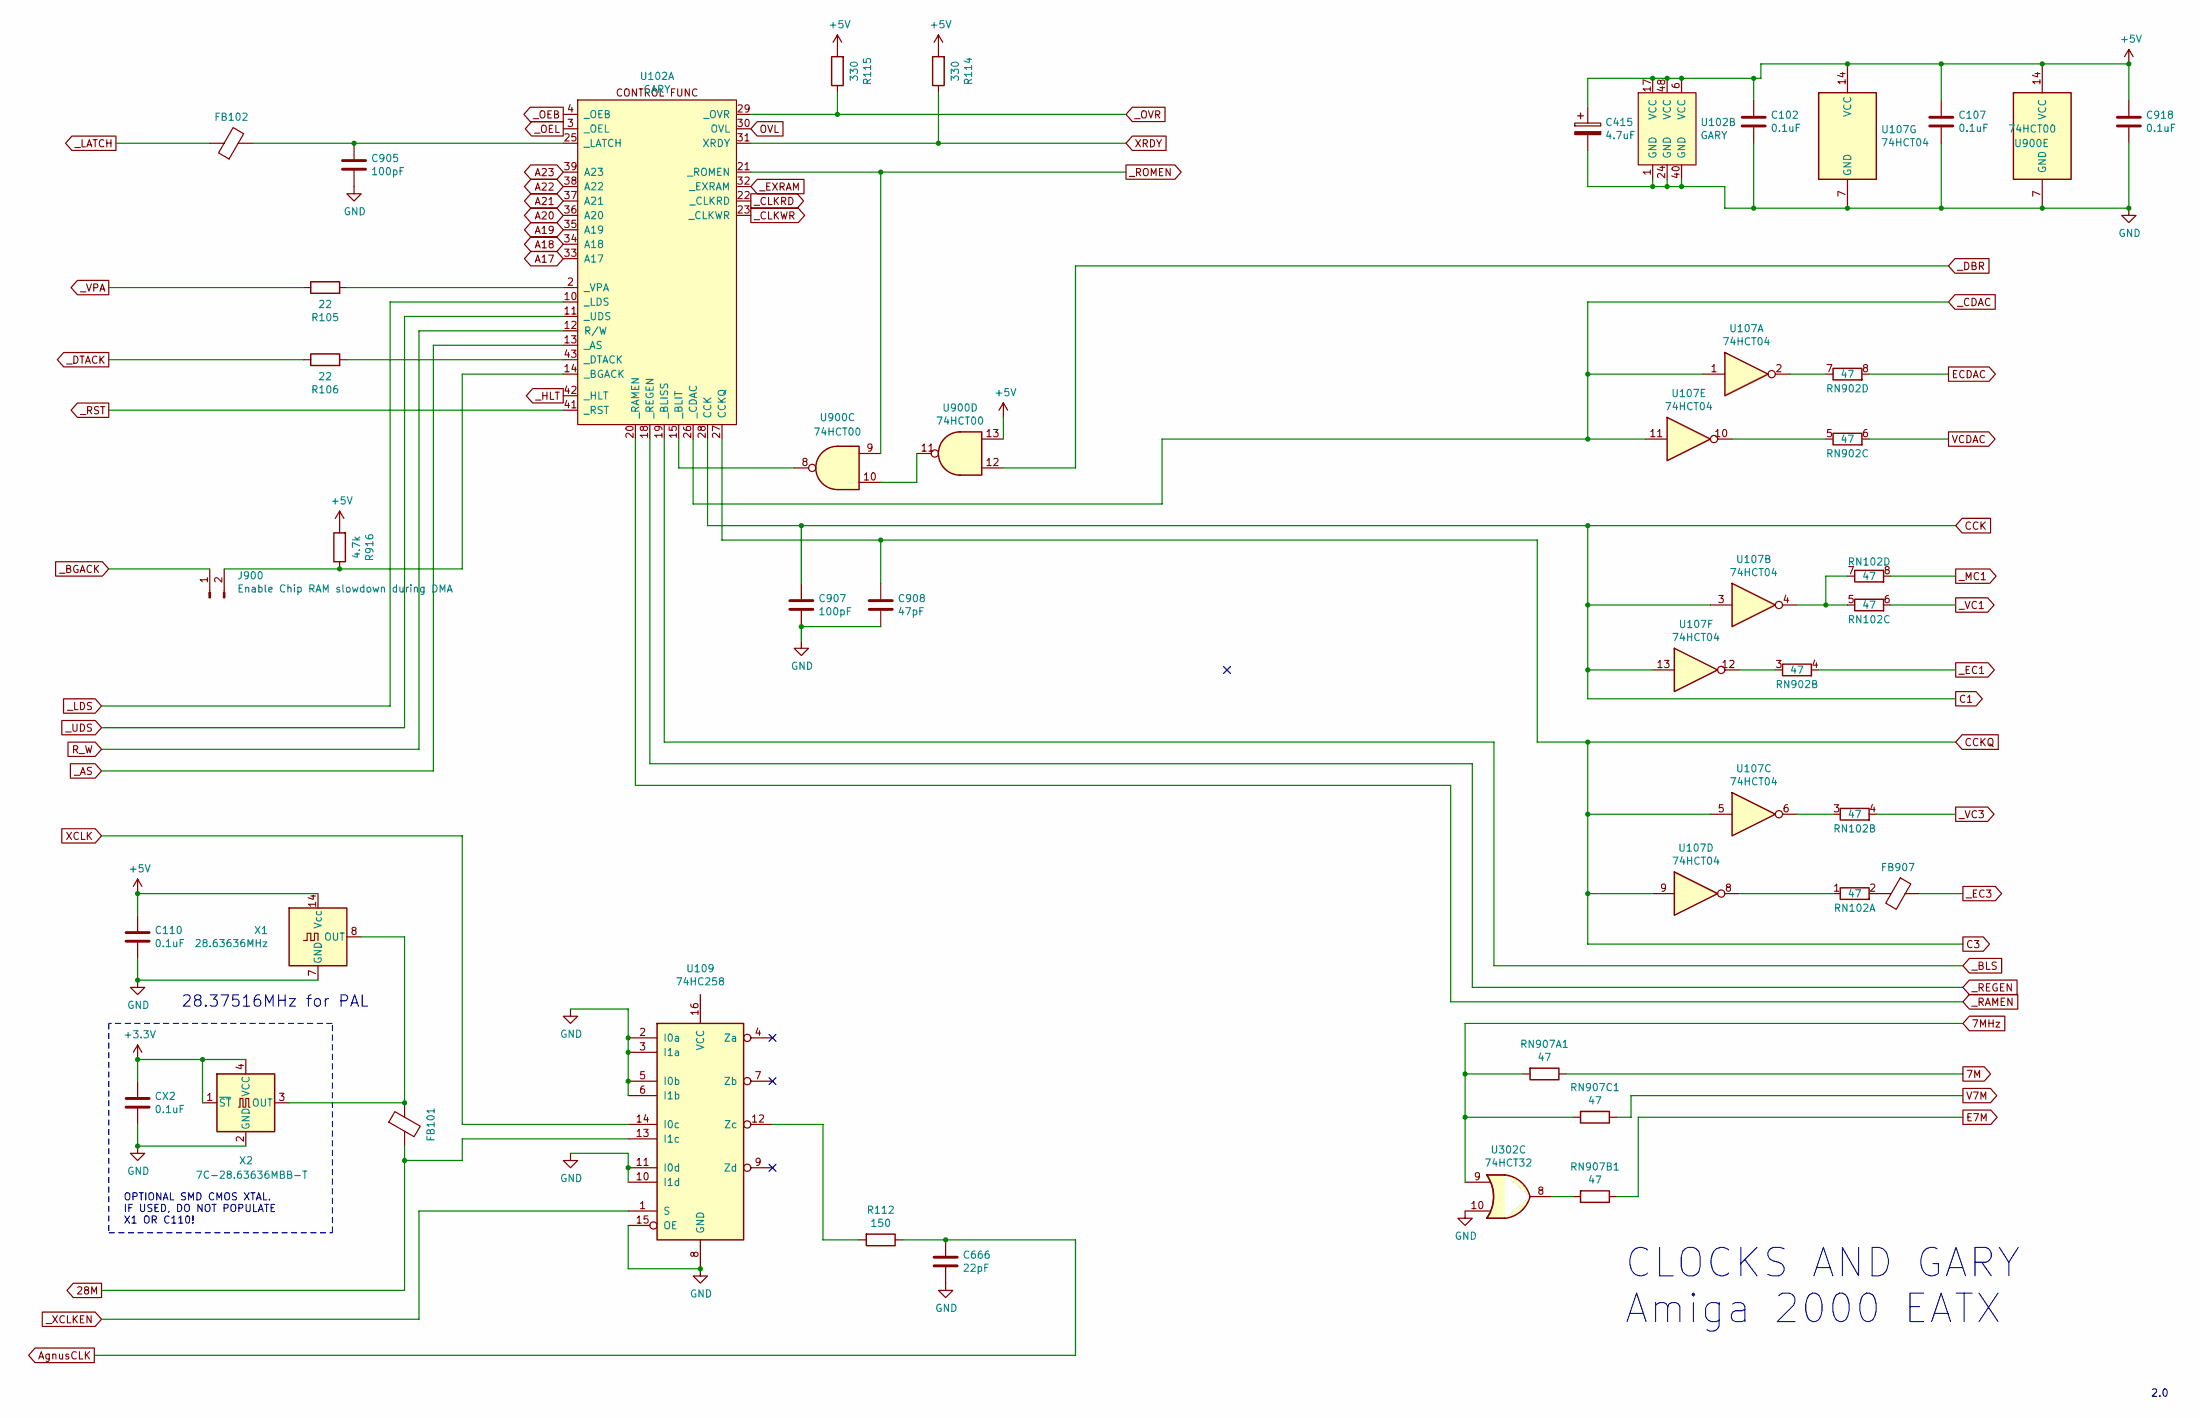
[picture p21: schematic agnus.sch]

Parts:
C102, C107, C110, C918: 0.1uF; C_1206_3216Metric
C415: 4.7uF; CP_Elec_4x5.8
C666: 22pF; C_1206_3216Metric
C905, C907: 100pF; C_1206_3216Metric
C908: 47pF; C_1206_3216Metric
CX2: 0.1uF; C_1206_3216Metric
FB101, FB102, FB907: Ferrite_Bead; C_1206_3216Metric
J900: Enable Chip RAM slowdown during DMA; PinHeader_1x02_P2.54mm_Vertical
R105, R106: 22; R_1206_3216Metric
R112: 150; R_1206_3216Metric
R114, R115: 330; R_1206_3216Metric
R916: 4.7k; R_1206_3216Metric
RN102, RN902: 47; R_Array_SIP8
RN907A1, RN907B1, RN907C1: 47; R_1206_3216Metric
U102: GARY; DIP-48_W15.24mm
U107: 74HCT04; SOIC-14_3.9x8.7mm_P1.27mm
U109: 74HC258; SOIC-16_4.55x10.3mm_P1.27mm
U302: 74HCT32; SOIC-14_3.9x8.7mm_P1.27mm
U900: 74HCT00; SOIC-14_3.9x8.7mm_P1.27mm
X1: 28.63636MHz; Oscillator_DIP-14
X2: 7C-28.63636MBB-T; Oscillator_SMD_SeikoEpson_SG8002LB-4Pin_5.0x3.2mm

Connections:
7M: RN907A1.1
7MHz: RN907A1.2, RN907C1.2, U302.9
28M: FB101.2, U109.13 (I1c)
+3.3V: CX2.1, X2.1 (~ST), X2.4 (VCC)
+5V: C102.1, C107.1, C110.1, C415.1, C918.1, R114.2, R115.2, R916.2, U102.6 (VCC), U102.17 (VCC), U102.48 (VCC), U107.14 (VCC), U900.13, U900.14 (VCC), X1.14 (Vcc)
A17: U102.33 (A17)
A18: U102.34 (A18)
A19: U102.35 (A19)
A20: U102.36 (A20)
A21: U102.37 (A21)
A22: U102.38 (A22)
A23: U102.39 (A23)
AgnusCLK: C666.1, R112.1
C1: C907.1, U102.28 (CCK), U107.3, U107.13
C3: C908.1, U102.27 (CCKQ), U107.5, U107.9
E7M: RN907B1.1
ECDAC: RN902.8 (R4.2)
GND: C102.2, C107.2, C110.2, C415.2, C666.2, C905.2, C907.2, C908.2, C918.2, CX2.2, U102.1 (GND), U102.24 (GND), U102.40 (GND), U107.7 (GND), U109.2 (I0a), U109.3 (I1a), U109.5 (I0b), U109.6 (I1b), U109.8 (GND), U109.10 (I1d), U109.11 (I0d), U109.15 (OE), U302.10, U900.7 (GND), X1.7 (GND), X2.2 (GND)
unnamed: C905.1, FB102.2, U102.25 (_LATCH)
unnamed: FB101.1, X1.8 (OUT), X2.3 (OUT)
unnamed: FB907.2, RN102.2 (R1.2)
unnamed: J900.2, R916.1, U102.14 (_BGACK)
unnamed: R105.2, U102.2 (_VPA)
unnamed: R106.2, U102.43 (_DTACK)
unnamed: R112.2, U109.12 (Zc)
unnamed: RN102.1 (R1.1), U107.8
unnamed: RN102.3 (R2.1), U107.6
unnamed: RN102.5 (R3.1), RN102.7 (R4.1), U107.4
unnamed: RN902.3 (R2.1), U107.12
unnamed: RN902.5 (R3.1), U107.10
unnamed: RN902.7 (R4.1), U107.2
unnamed: RN907B1.2, U302.8
unnamed: U102.15 (_BLIT), U900.8
unnamed: U900.10, U900.11
OVL: U102.30 (OVL)
R_W: U102.12 (R/W)
V7M: RN907C1.1
VCDAC: RN902.6 (R3.2)
XCLK: U109.14 (I0c)
XRDY: R114.1, U102.31 (XRDY)
_AS: U102.13 (_AS)
_BGACK: J900.1
_BLS: U102.19 (_BLISS)
_CDAC: U102.26 (_CDAC), U107.1, U107.11
_CLKRD: U102.22 (_CLKRD)
_CLKWR: U102.23 (_CLKWR)
_DBR: U900.12
_DTACK: R106.1
_EC1: RN902.4 (R2.2)
_EC3: FB907.1
_EXRAM: U102.32 (_EXRAM)
_HLT: U102.42 (_HLT)
_LATCH: FB102.1
_LDS: U102.10 (_LDS)
_MC1: RN102.8 (R4.2)
_OEB: U102.4 (_OEB)
_OEL: U102.3 (_OEL)
_OVR: R115.1, U102.29 (_OVR)
_RAMEN: U102.20 (_RAMEN)
_REGEN: U102.18 (_REGEN)
_ROMEN: U102.21 (_ROMEN), U900.9
_RST: U102.41 (_RST)
_UDS: U102.11 (_UDS)
_VC1: RN102.6 (R3.2)
_VC3: RN102.4 (R2.2)
_VPA: R105.1
_XCLKEN: U109.1 (S)

Notes on the sheet:
CLOCKS AND GARY Amiga 2000 EATX
2.0
OPTIONAL SMD CMOS XTAL. IF USED, DO NOT POPULATE X1 OR C110!
28.37516MHz for PAL
