jgrip/Amiga-2000-EATX/2000EATX-KiCAD-R22/bus.sch

## KiCad design 2000EATX-KiCAD-R22/bus.sch (2021-12-02)

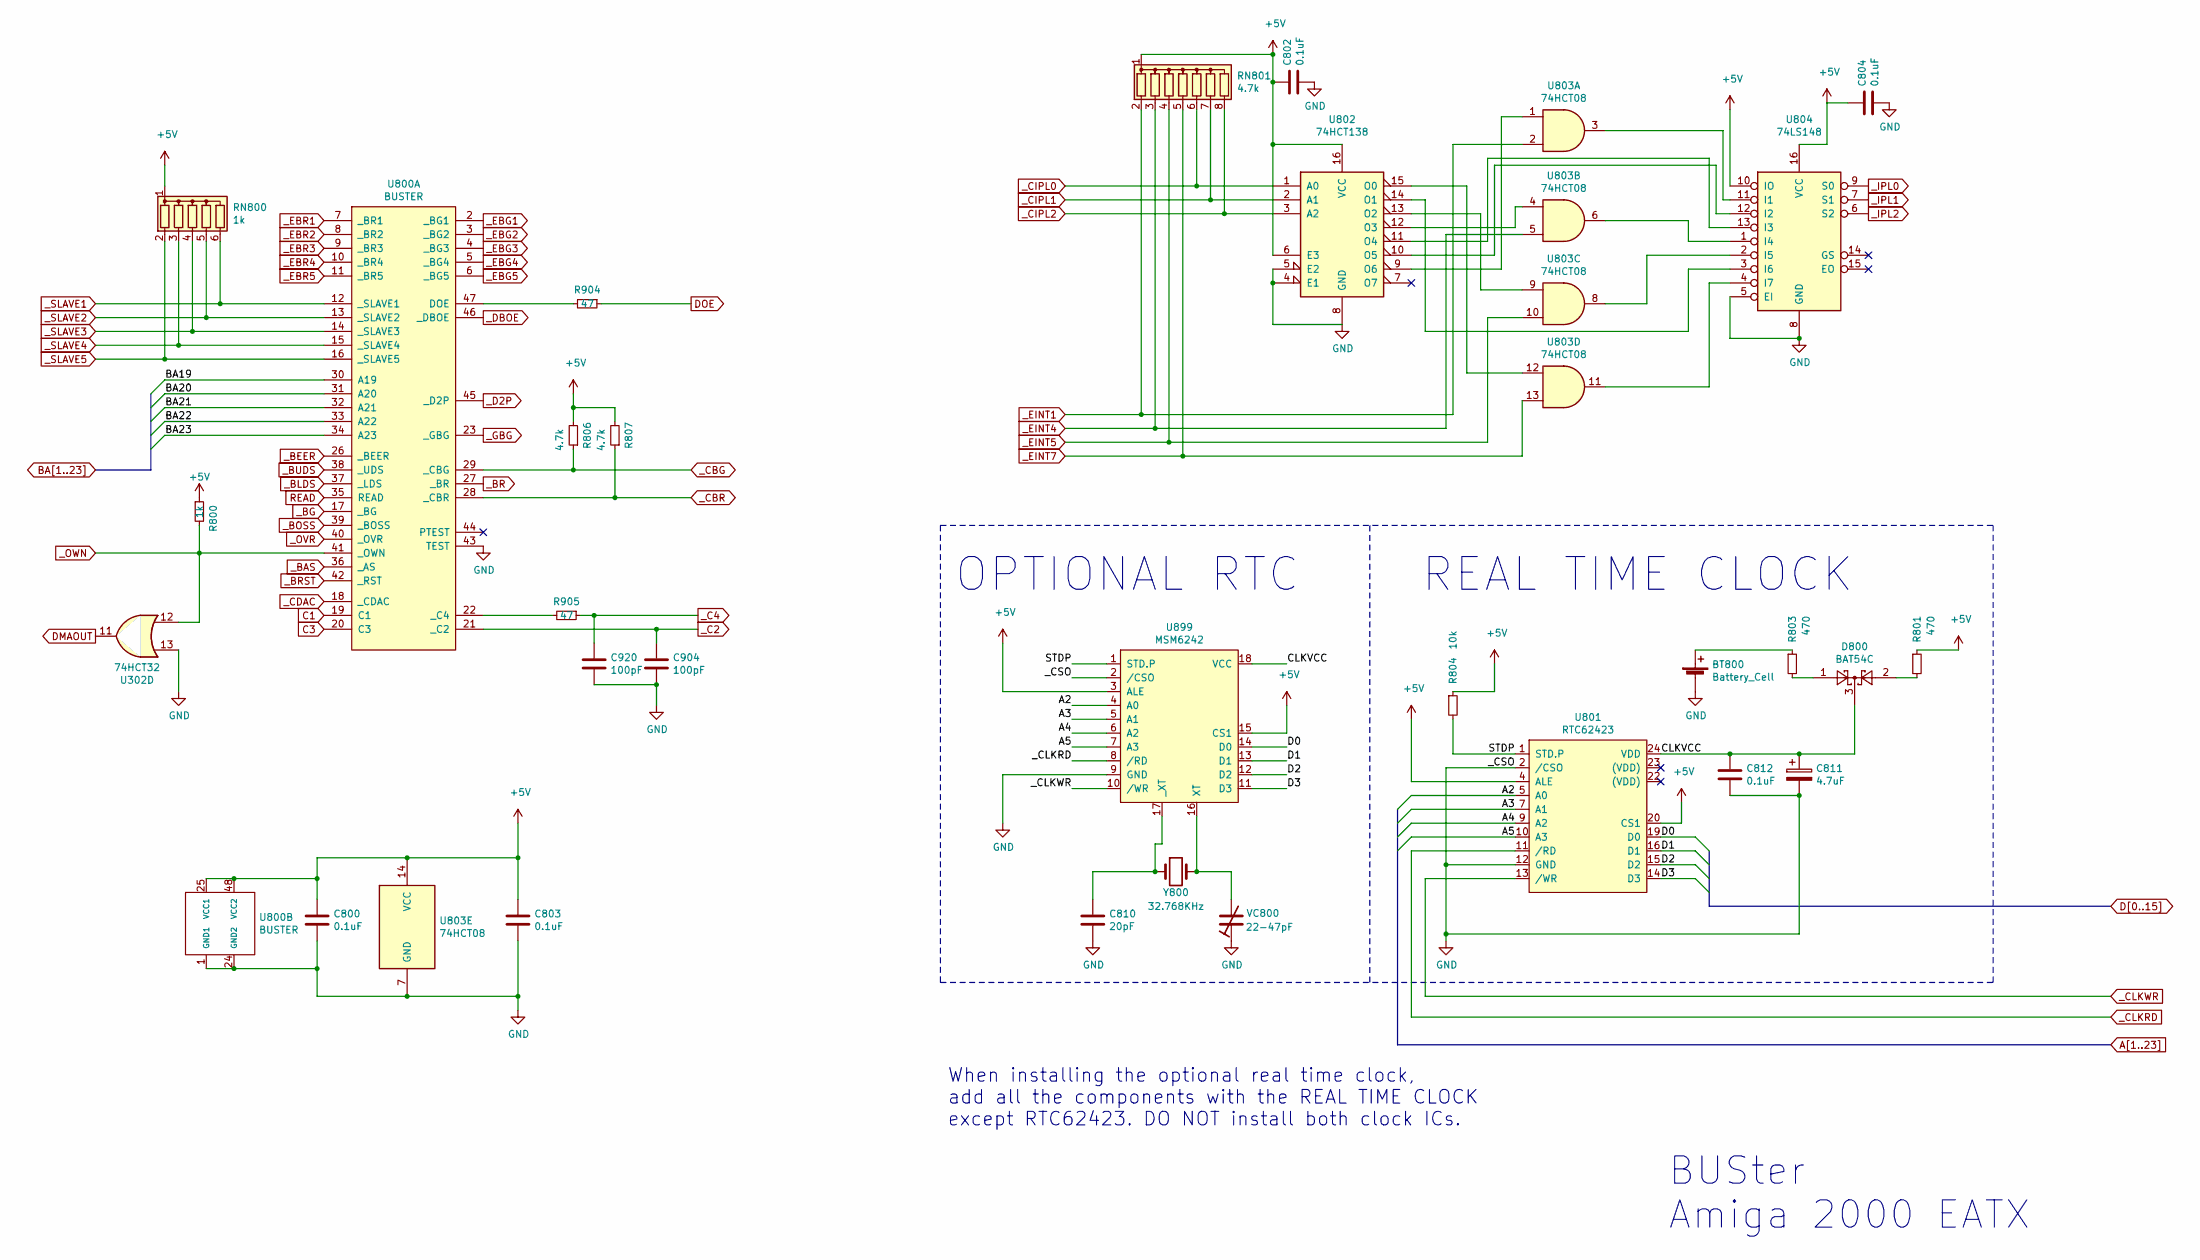
[picture p22: schematic bus.sch]

Parts:
BT800: Battery_Cell; BatteryHolder_Keystone_103_1x20mm
C800, C802, C803, C804, C812: 0.1uF; C_1206_3216Metric
C810: 20pF; C_1206_3216Metric
C811: 4.7uF; CP_Elec_4x5.8
C904, C920: 100pF; C_1206_3216Metric
D800: BAT54C; SOT-23
R800: 1k; R_1206_3216Metric
R801, R803: 470; R_1206_3216Metric
R804: 10k; R_1206_3216Metric
R806, R807: 4.7k; R_1206_3216Metric
R904, R905: 47; R_1206_3216Metric
RN800: 1k; R_Array_SIP6
RN801: 4.7k; R_Array_SIP8
U302: 74HCT32; SOIC-14_3.9x8.7mm_P1.27mm
U800: BUSTER; DIP-48_W15.24mm
U801: RTC62423; SOIC-24W_RTC62423
U802: 74HCT138; SOIC-16_3.9x9.9mm_P1.27mm
U803: 74HCT08; SOIC-14_3.9x8.7mm_P1.27mm
U804: 74LS148; SOIC-16_3.9x9.9mm_P1.27mm
U899: MSM6242; DIP-18_W7.62mm_Socket
VC800: 22-47pF; TrimmerCap
Y800: 32.768KHz; Crystal_SMD_3215-2Pin_3.2x1.5mm

Connections:
+5V: C800.1, C802.1, C803.1, C804.1, R800.1, R801.1, R804.1, R806.2, R807.2, RN800.1 (common), RN801.1 (common), U800.25 (VCC1), U800.48 (VCC2), U801.4 (ALE), U801.20 (CS1), U802.6 (E3), U802.16 (VCC), U803.14 (VCC), U804.10 (IO), U804.16 (VCC), U899.3 (ALE), U899.15 (CS1)
A2: U801.5 (A0), U899.4 (A0)
A3: U801.7 (A1), U899.5 (A1)
A4: U801.9 (A2), U899.6 (A2)
A5: U801.10 (A3), U899.7 (A3)
BA19: U800.30 (A19)
BA20: U800.31 (A20)
BA21: U800.32 (A21)
BA22: U800.33 (A22)
BA23: U800.34 (A23)
C1: U800.19 (C1)
C3: U800.20 (C3)
CLKVCC: C811.1, C812.1, D800.3, U801.24 (VDD), U899.18 (VCC)
D0: U801.19 (D0), U899.14 (D0)
D1: U801.16 (D1), U899.13 (D1)
D2: U801.15 (D2), U899.12 (D2)
D3: U801.14 (D3), U899.11 (D3)
DMAOUT: U302.11
DOE: R904.1
GND: BT800.2 (-), C800.2, C802.2, C803.2, C804.2, C810.2, C811.2, C812.2, C904.2, C920.2, U302.13, U800.1 (GND1), U800.24 (GND2), U800.43 (TEST), U801.2 (/CSO), U801.12 (GND), U802.4 (E1), U802.5 (E2), U802.8 (GND), U803.7 (GND), U804.5 (EI), U804.8 (GND), U899.2 (/CSO), U899.9 (GND), VC800.1
unnamed: BT800.1 (+), R803.1
unnamed: C810.1, U899.17 (_XT), Y800.1
unnamed: D800.1, R803.2
unnamed: D800.2, R801.2
unnamed: R904.2, U800.47 (DOE)
unnamed: R905.2, U800.22 (_C4)
unnamed: U802.9 (O6), U803.1
unnamed: U802.10 (O5), U804.12 (I2)
unnamed: U802.11 (O4), U804.13 (I3)
unnamed: U802.12 (O3), U803.4
unnamed: U802.13 (O2), U803.9
unnamed: U802.14 (O1), U804.3 (I6)
unnamed: U802.15 (O0), U803.12
unnamed: U803.3, U804.11 (I1)
unnamed: U803.6, U804.1 (I4)
unnamed: U803.8, U804.2 (I5)
unnamed: U803.11, U804.4 (I7)
unnamed: U899.16 (XT), VC800.2, Y800.2
READ: U800.35 (READ)
STDP: R804.2, U801.1 (STD.P), U899.1 (STD.P)
_BAS: U800.36 (_AS)
_BEER: U800.26 (_BEER)
_BG: U800.17 (_BG)
_BLDS: U800.37 (_LDS)
_BOSS: U800.39 (_BOSS)
_BR: U800.27 (_BR)
_BRST: U800.42 (_RST)
_BUDS: U800.38 (_UDS)
_C2: C904.1, U800.21 (_C2)
_C4: C920.1, R905.1
_CBG: R806.1, U800.29 (_CBG)
_CBR: R807.1, U800.28 (_CBR)
_CDAC: U800.18 (_CDAC)
_CIPL0: RN801.6 (R5), U802.1 (A0)
_CIPL1: RN801.7 (R6), U802.2 (A1)
_CIPL2: RN801.8 (R7), U802.3 (A2)
_CLKRD: U801.11 (/RD), U899.8 (/RD)
_CLKWR: U801.13 (/WR), U899.10 (/WR)
_D2P: U800.45 (_D2P)
_DBOE: U800.46 (_DBOE)
_EBG1: U800.2 (_BG1)
_EBG2: U800.3 (_BG2)
_EBG3: U800.4 (_BG3)
_EBG4: U800.5 (_BG4)
_EBG5: U800.6 (_BG5)
_EBR1: U800.7 (_BR1)
_EBR2: U800.8 (_BR2)
_EBR3: U800.9 (_BR3)
_EBR4: U800.10 (_BR4)
_EBR5: U800.11 (_BR5)
_EINT1: RN801.2 (R1), U803.2
_EINT4: RN801.3 (R2), U803.5
_EINT5: RN801.4 (R3), U803.10
_EINT7: RN801.5 (R4), U803.13
_GBG: U800.23 (_GBG)
_IPL0: U804.9 (S0)
_IPL1: U804.7 (S1)
_IPL2: U804.6 (S2)
_OVR: U800.40 (_OVR)
_OWN: R800.2, U302.12, U800.41 (_OWN)
_SLAVE1: RN800.6 (R5), U800.12 (_SLAVE1)
_SLAVE2: RN800.5 (R4), U800.13 (_SLAVE2)
_SLAVE3: RN800.4 (R3), U800.14 (_SLAVE3)
_SLAVE4: RN800.3 (R2), U800.15 (_SLAVE4)
_SLAVE5: RN800.2 (R1), U800.16 (_SLAVE5)

Notes on the sheet:
BUSter Amiga 2000 EATX
REAL TIME CLOCK
OPTIONAL RTC
When installing the optional real time clock, add all the components with the REAL TIME CLOCK except RTC62423. DO NOT install both clock ICs.
