jgrip/Amiga-2000-EATX/2000EATX-KiCAD-R22/coprocessor.sch

## KiCad design 2000EATX-KiCAD-R22/coprocessor.sch (2021-12-02)

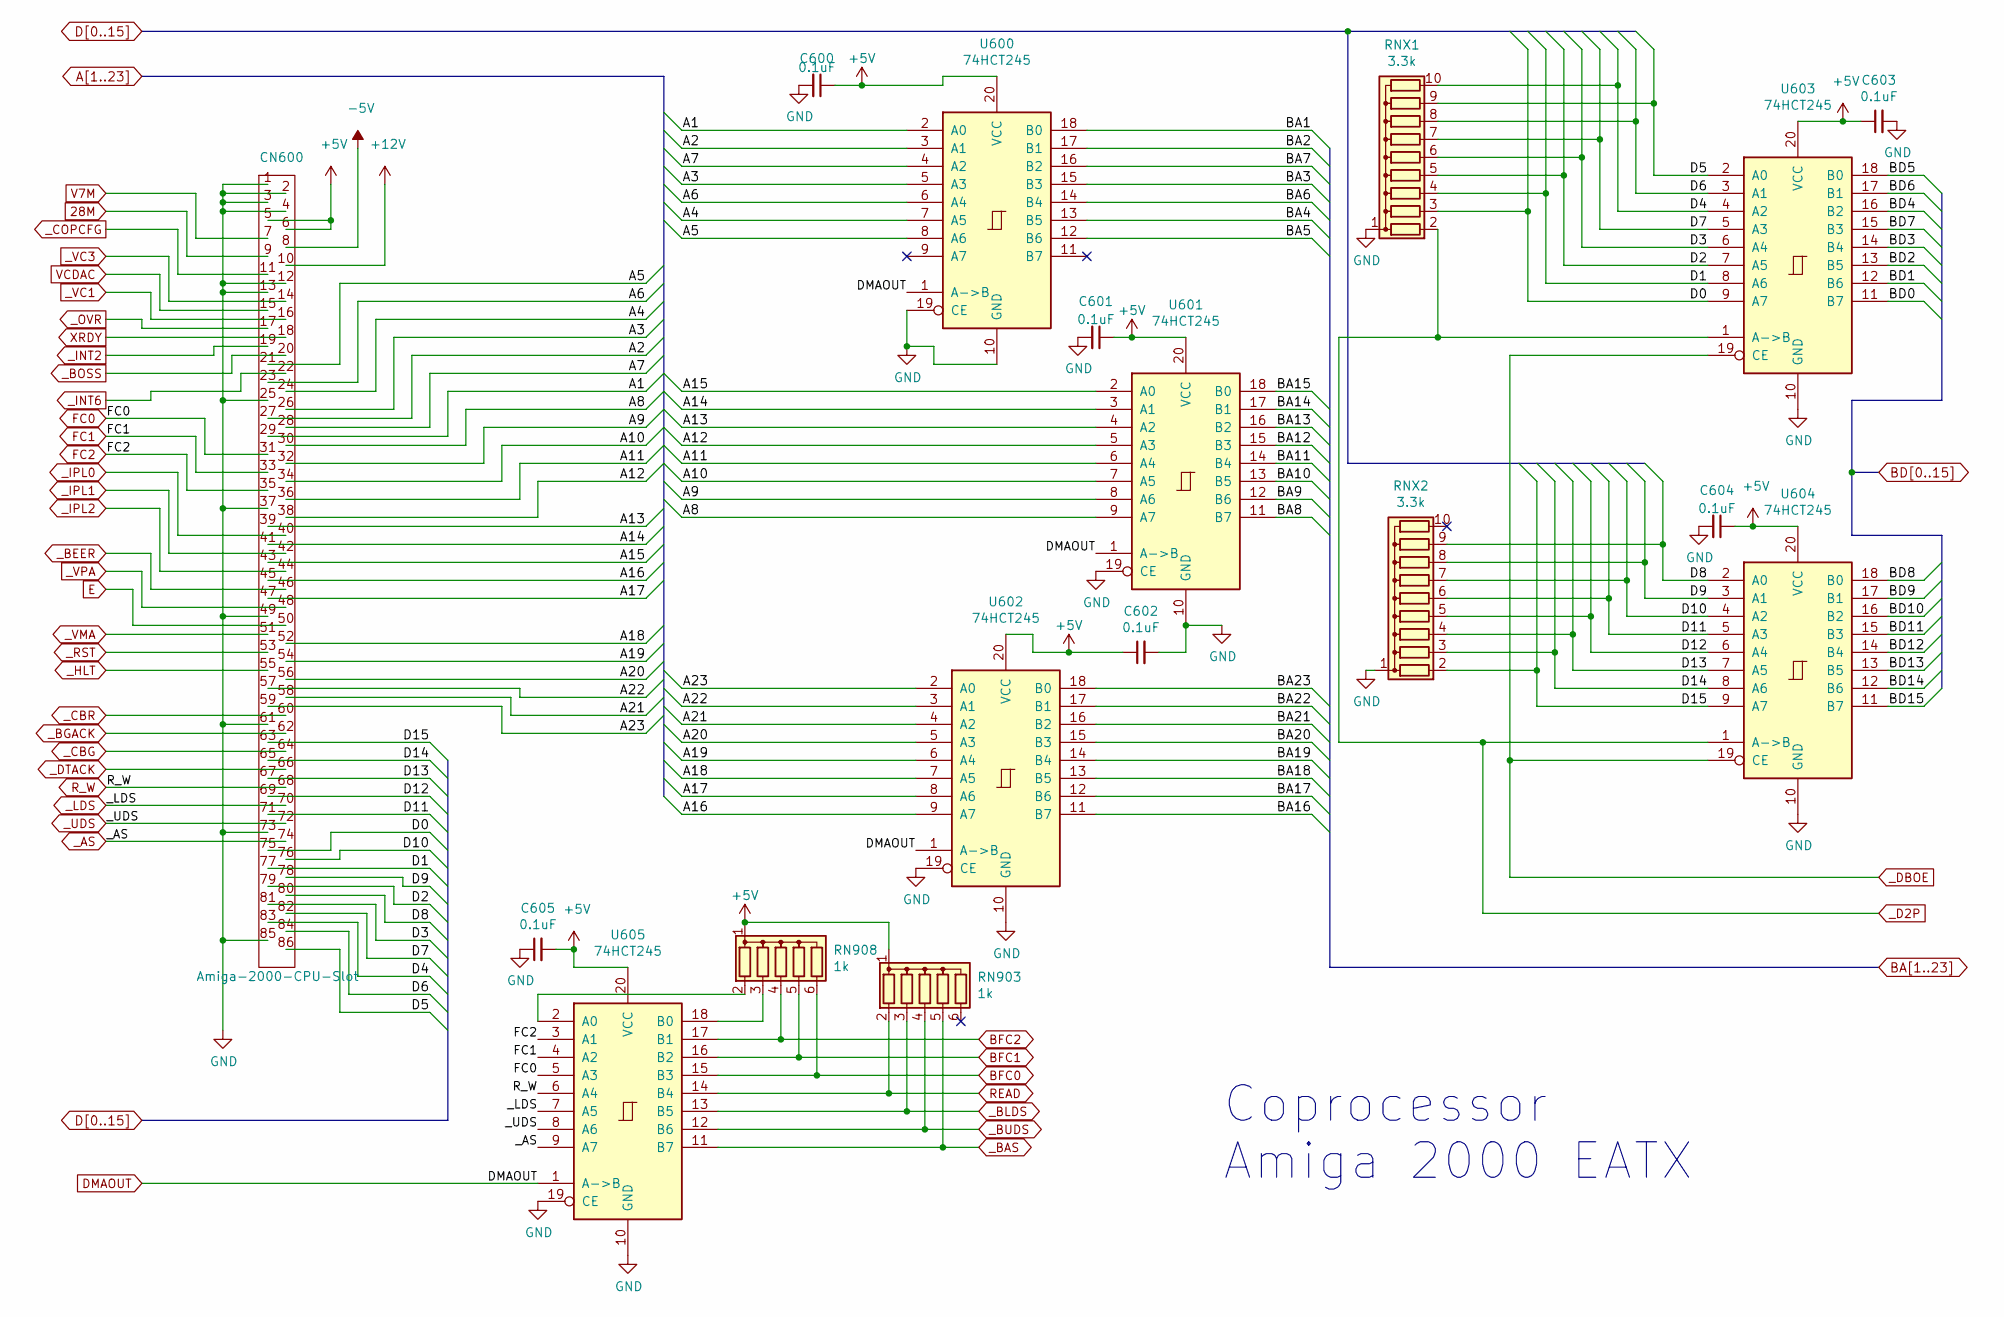
[picture p23: schematic coprocessor.sch]

Parts:
C600, C601, C602, C603, C604, C605: 0.1uF; C_1206_3216Metric
CN600: Amiga-2000-CPU-Slot; Samtec_HLE-150-02-xx-DV-TE_2x43_P2.54mm_Horizontal
RN903, RN908: 1k; R_Array_SIP6
RNX1, RNX2: 3.3k; R_Array_SIP10
U600, U601, U602, U603, U604, U605: 74HCT245; SOIC-20W_7.5x12.8mm_P1.27mm

Connections:
28M: CN600.9
+5V: C600.1, C601.1, C602.1, C603.1, C604.1, C605.2, CN600.5, CN600.6, RN903.1 (common), RN908.1 (common), U600.20 (VCC), U601.20 (VCC), U602.20 (VCC), U603.20 (VCC), U604.20 (VCC), U605.20 (VCC)
+12V: CN600.10
-5V: CN600.8
A1: CN600.29, U600.2 (A0)
A2: CN600.27, U600.3 (A1)
A3: CN600.26, U600.5 (A3)
A4: CN600.24, U600.7 (A5)
A5: CN600.21, U600.8 (A6)
A6: CN600.23, U600.6 (A4)
A7: CN600.28, U600.4 (A2)
A8: CN600.30, U601.9 (A7)
A9: CN600.32, U601.8 (A6)
A10: CN600.34, U601.7 (A5)
A11: CN600.36, U601.6 (A4)
A12: CN600.38, U601.5 (A3)
A13: CN600.39, U601.4 (A2)
A14: CN600.41, U601.3 (A1)
A15: CN600.43, U601.2 (A0)
A16: CN600.45, U602.9 (A7)
A17: CN600.47, U602.8 (A6)
A18: CN600.52, U602.7 (A5)
A19: CN600.54, U602.6 (A4)
A20: CN600.56, U602.5 (A3)
A21: CN600.58, U602.4 (A2)
A22: CN600.57, U602.3 (A1)
A23: CN600.59, U602.2 (A0)
BA1: U600.18 (B0)
BA2: U600.17 (B1)
BA3: U600.15 (B3)
BA4: U600.13 (B5)
BA5: U600.12 (B6)
BA6: U600.14 (B4)
BA7: U600.16 (B2)
BA8: U601.11 (B7)
BA9: U601.12 (B6)
BA10: U601.13 (B5)
BA11: U601.14 (B4)
BA12: U601.15 (B3)
BA13: U601.16 (B2)
BA14: U601.17 (B1)
BA15: U601.18 (B0)
BA16: U602.11 (B7)
BA17: U602.12 (B6)
BA18: U602.13 (B5)
BA19: U602.14 (B4)
BA20: U602.15 (B3)
BA21: U602.16 (B2)
BA22: U602.17 (B1)
BA23: U602.18 (B0)
BD0: U603.11 (B7)
BD1: U603.12 (B6)
BD2: U603.13 (B5)
BD3: U603.14 (B4)
BD4: U603.16 (B2)
BD5: U603.18 (B0)
BD6: U603.17 (B1)
BD7: U603.15 (B3)
BD8: U604.18 (B0)
BD9: U604.17 (B1)
BD10: U604.16 (B2)
BD11: U604.15 (B3)
BD12: U604.14 (B4)
BD13: U604.13 (B5)
BD14: U604.12 (B6)
BD15: U604.11 (B7)
BFC0: RN908.6 (R5), U605.15 (B3)
BFC1: RN908.5 (R4), U605.16 (B2)
BFC2: RN908.4 (R3), U605.17 (B1)
D0: CN600.75, RNX1.3 (R2), U603.9 (A7)
D1: CN600.77, RNX1.4 (R3), U603.8 (A6)
D2: CN600.79, RNX1.5 (R4), U603.7 (A5)
D3: CN600.81, RNX1.6 (R5), U603.6 (A4)
D4: CN600.83, RNX1.10 (R9), U603.4 (A2)
D5: CN600.86, RNX1.9 (R8), U603.2 (A0)
D6: CN600.84, RNX1.8 (R7), U603.3 (A1)
D7: CN600.82, RNX1.7 (R6), U603.5 (A3)
D8: CN600.80, RNX2.9 (R8), U604.2 (A0)
D9: CN600.78, RNX2.8 (R7), U604.3 (A1)
D10: CN600.76, RNX2.7 (R6), U604.4 (A2)
D11: CN600.71, RNX2.6 (R5), U604.5 (A3)
D12: CN600.69, RNX2.5 (R4), U604.6 (A4)
D13: CN600.67, RNX2.4 (R3), U604.7 (A5)
D14: CN600.65, RNX2.3 (R2), U604.8 (A6)
D15: CN600.63, RNX2.2 (R1), U604.9 (A7)
DMAOUT: U600.1 (A->B), U601.1 (A->B), U602.1 (A->B), U605.1 (A->B)
E: CN600.50
FC0: CN600.31, U605.5 (A3)
FC1: CN600.33, U605.4 (A2)
FC2: CN600.35, U605.3 (A1)
GND: C600.2, C601.2, C602.2, C603.2, C604.2, C605.1, CN600.1, CN600.2, CN600.3, CN600.4, CN600.12, CN600.13, CN600.25, CN600.37, CN600.49, CN600.61, CN600.73, CN600.85, RNX1.1 (common), RNX2.1 (common), U600.10 (GND), U600.19 (CE), U601.10 (GND), U601.19 (CE), U602.10 (GND), U602.19 (CE), U603.10 (GND), U604.10 (GND), U605.10 (GND), U605.19 (CE)
unnamed: RN908.2 (R1), U605.2 (A0)
unnamed: RN908.3 (R2), U605.18 (B0)
READ: RN903.2 (R1), U605.14 (B4)
R_W: CN600.68, U605.6 (A4)
V7M: CN600.7
VCDAC: CN600.15
XRDY: CN600.18
_AS: CN600.74, U605.9 (A7)
_BAS: RN903.5 (R4), U605.11 (B7)
_BEER: CN600.46
_BGACK: CN600.62
_BLDS: RN903.3 (R2), U605.13 (B5)
_BOSS: CN600.20
_BUDS: RN903.4 (R3), U605.12 (B6)
_CBG: CN600.64
_CBR: CN600.60
_COPCFG: CN600.11
_D2P: RNX1.2 (R1), U603.1 (A->B), U604.1 (A->B)
_DBOE: U603.19 (CE), U604.19 (CE)
_DTACK: CN600.66
_HLT: CN600.55
_INT2: CN600.19
_INT6: CN600.22
_IPL0: CN600.40
_IPL1: CN600.42
_IPL2: CN600.44
_LDS: CN600.70, U605.7 (A5)
_OVR: CN600.17
_RST: CN600.53
_UDS: CN600.72, U605.8 (A6)
_VC1: CN600.16
_VC3: CN600.14
_VMA: CN600.51
_VPA: CN600.48

Notes on the sheet:
Coprocessor Amiga 2000 EATX
