jgrip/Amiga-2000-EATX/2000EATX-KiCAD-R22/file6121153C.sch

## KiCad design 2000EATX-KiCAD-R22/file6121153C.sch (2021-12-02)

Schematic: file6121153C.sch

Parts:
R5555, R5556, R5557, R5558, R5559, R5560, R5561, R5562, R5563, R5564, R5565, R5567: 47
R5566, R5568, R5569: 22
U501: 74HCT00
U502, U504: CY74FCT821T; SOIC-24W_7.5x15.4mm_P1.27mm
U503: CY62167ELL-45ZXI (1M x 16/2M x 8) SRAM
U540, U541: 74AHCT244
U5555: 8375 AGNUS

Notes on the sheet:
_BYTE tied to Vcc to enable 1M x 16 mode
8375 2M AGNUS DRAFT
AMIGA 2000 EATX
NOT APPROVED FOR PRODUCTION
