jgrip/Amiga-2000-EATX/2000EATX-KiCAD-R22/floppyparallel.sch

## KiCad design 2000EATX-KiCAD-R22/floppyparallel.sch (2021-12-02)

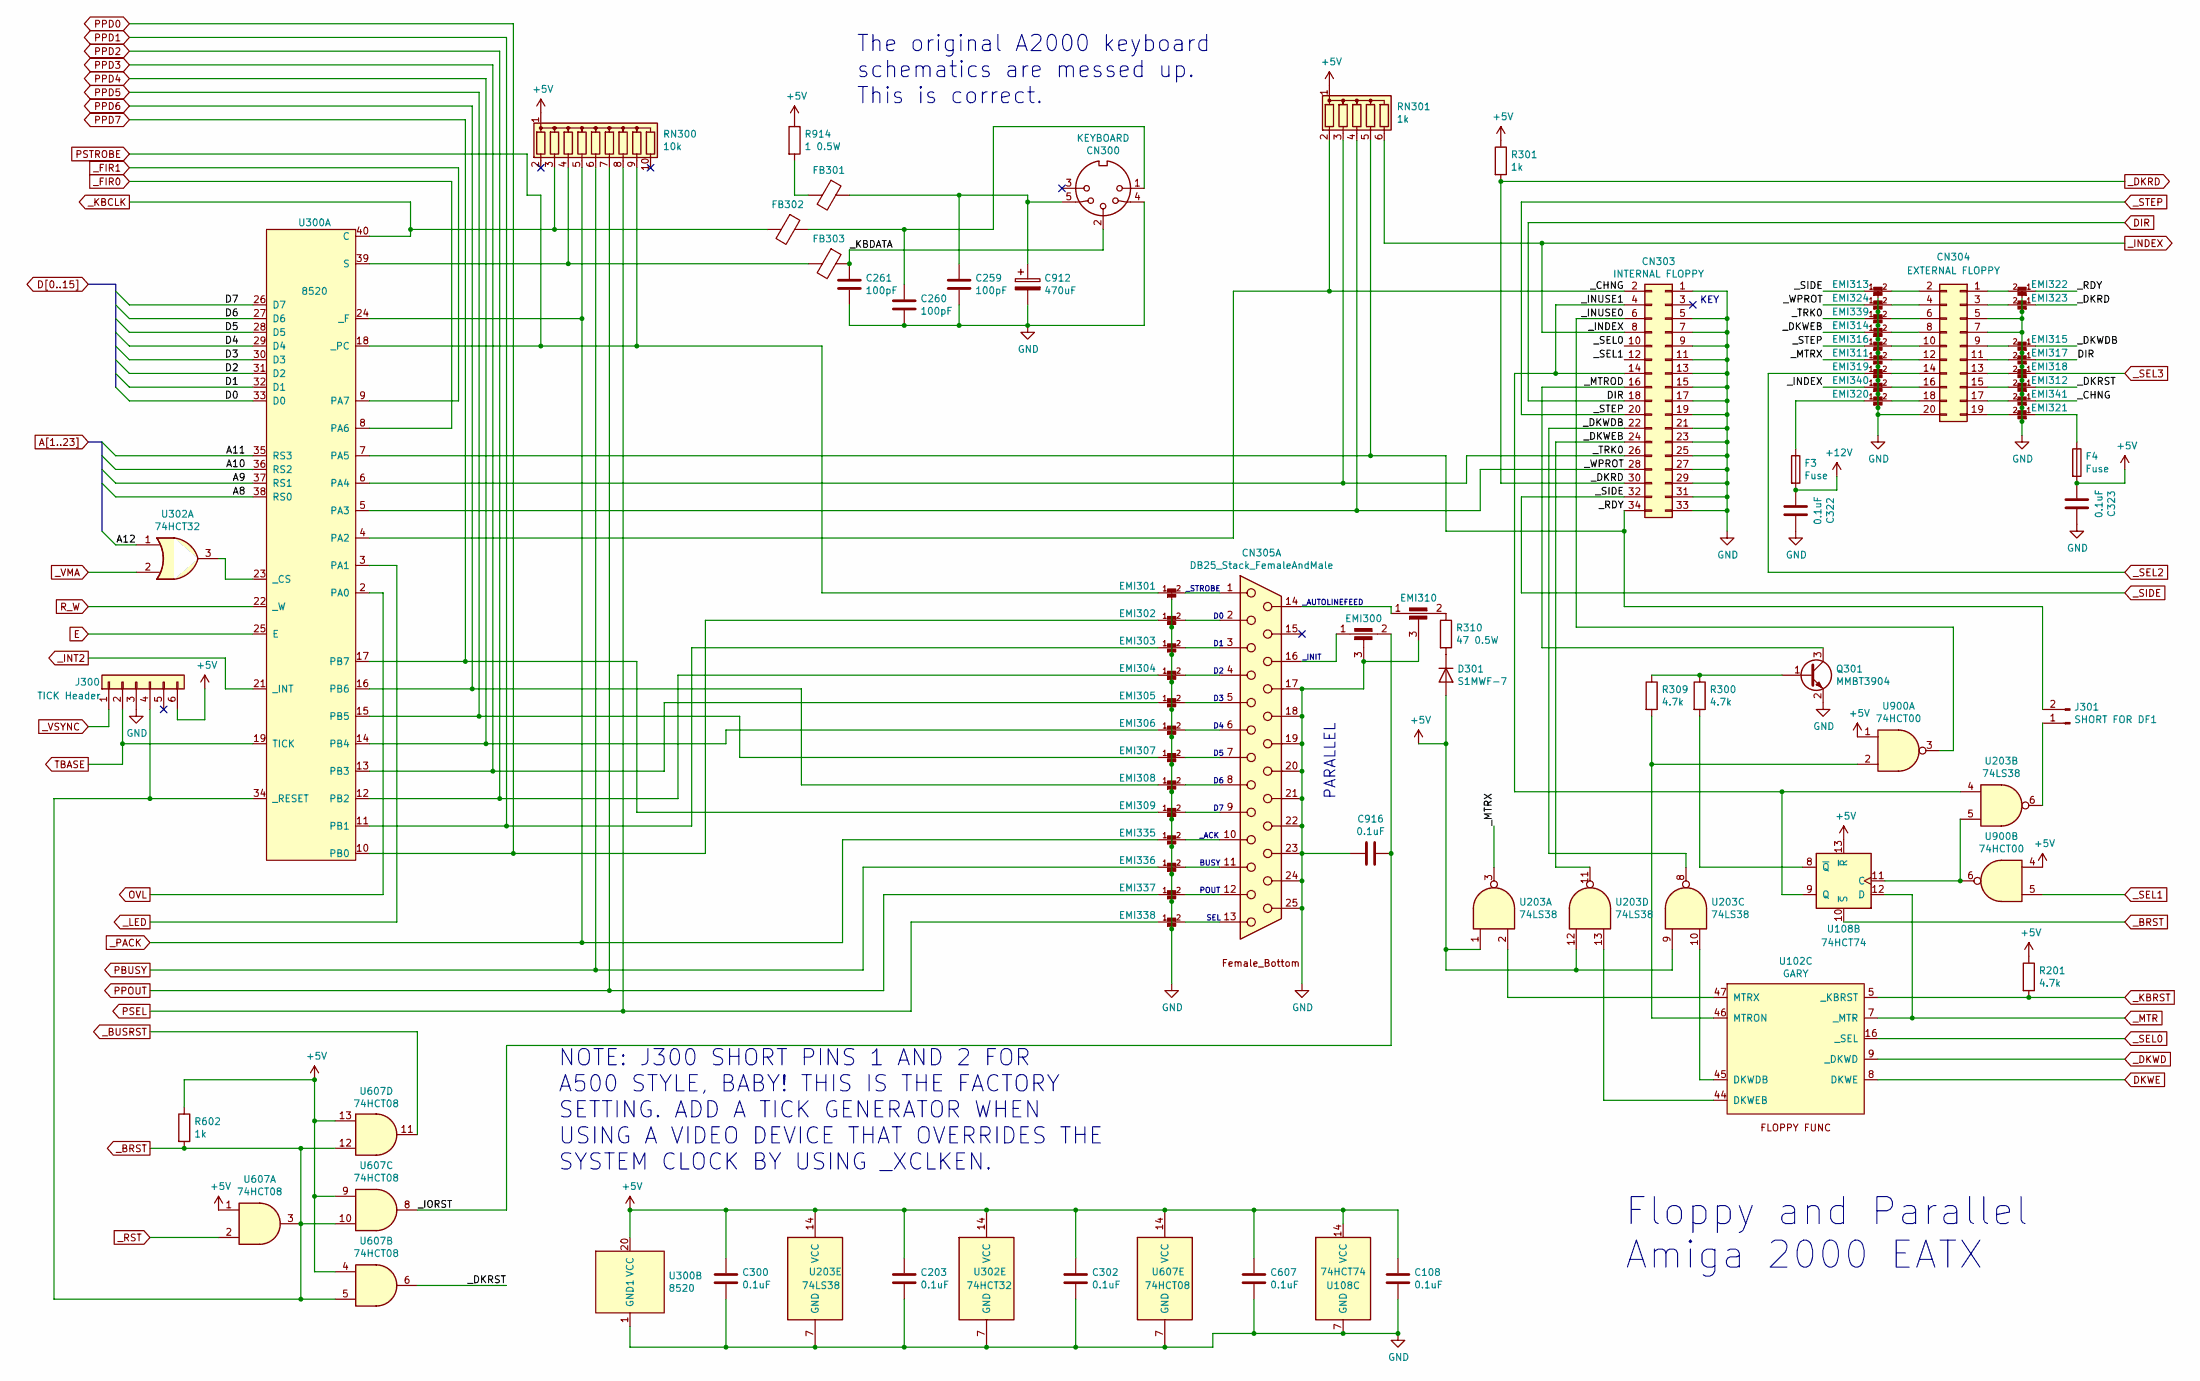
[picture p24: schematic floppyparallel.sch]

Parts:
C108, C203, C300, C302, C322, C323, C607, C916: 0.1uF; C_1206_3216Metric
C259, C260, C261: 100pF; C_1206_3216Metric
C912: 470uF; CP_Elec_8x10
CN300: KEYBOARD; DIN5; Part SDS-50J
CN303: INTERNAL FLOPPY; PinHeader_2x17_P2.54mm_Vertical
CN304: EXTERNAL FLOPPY; PinHeader_2x10_P2.54mm_Vertical
CN305: DB25_Stack_FemaleAndMale; DSUB-25_Stack_Female_Bottom_Male_Top
D301: S1MWF-7; D_SOD-123F
EMI300, EMI301, EMI302, EMI303, EMI304, EMI305, EMI306, EMI307, EMI308, EMI309, EMI310, EMI335, EMI336, EMI337, EMI338: C_Feedthrough; C_1206_3216_Feedthrough
EMI311, EMI312, EMI313, EMI314, EMI315, EMI316, EMI317, EMI318, EMI319, EMI320, EMI321, EMI322, EMI323, EMI324, EMI339, EMI340, EMI341: C_Feedthrough_Small; C_1206_3216_Feedthrough
F3, F4: Fuse; Fuse_1206_3216Metric
FB301, FB302, FB303: Ferrite_Bead; C_1206_3216Metric
J300: TICK Header; PinHeader_1x06_P2.54mm_Vertical
J301: SHORT FOR DF1; PinHeader_1x02_P2.54mm_Vertical
Q301: MMBT3904; SOT-23
R201, R300, R309: 4.7k; R_1206_3216Metric
R301, R602: 1k; R_1206_3216Metric
R310: 47 0.5W; R_1206_3216Metric
R914: 1 0.5W; R_1206_3216Metric
RN300: 10k; R_Array_SIP10
RN301: 1k; R_Array_SIP6
U102: GARY; DIP-48_W15.24mm
U108: 74HCT74; SOIC-14_3.9x8.7mm_P1.27mm
U203: 74LS38; SOIC-14_3.9x8.7mm_P1.27mm
U300: 8520; DIP-40_W15.24mm
U302: 74HCT32
U607: 74HCT08; SOIC-14_3.9x8.7mm_P1.27mm
U900: 74HCT00; SOIC-14_3.9x8.7mm_P1.27mm

Connections:
+5V: C108.2, C203.2, C300.2, C302.2, C323.2, C607.2, D301.2 (A), F4.2, J300.6, R201.1, R301.1, R602.1, R914.1, RN300.1 (common), RN301.1 (common), U108.13 (~R), U108.14 (VCC), U203.1, U203.9, U203.12, U203.14 (VCC), U300.20 (VCC), U302.14 (VCC), U607.1, U607.4, U607.9, U607.13, U607.14 (VCC), U900.1, U900.4
+12V: C322.2, F3.2
A8: U300.38 (RS0)
A9: U300.37 (RS1)
A10: U300.36 (RS2)
A11: U300.35 (RS3)
A12: U302.1
D0: U300.33 (D0)
D1: U300.32 (D1)
D2: U300.31 (D2)
D3: U300.30 (D3)
D4: U300.29 (D4)
D5: U300.28 (D5)
D6: U300.27 (D6)
D7: U300.26 (D7)
DIR: CN303.18, EMI317.1
DKWE: U102.8 (DKWE)
E: U300.25 (E)
GND: C108.1, C203.1, C259.2, C260.2, C261.2, C300.1, C302.1, C322.1, C323.1, C607.1, C912.2, C916.2, CN300.4, CN303.1, CN303.5, CN303.7, CN303.9, CN303.11, CN303.13, CN303.15, CN303.17, CN303.19, CN303.21, CN303.23, CN303.25, CN303.27, CN303.29, CN303.31, CN303.33, CN304.5, CN304.7, CN304.20, CN305.17, CN305.18, CN305.19, CN305.20, CN305.21, CN305.22, CN305.23, CN305.24, CN305.25, EMI300.3, EMI301.3, EMI302.3, EMI303.3, EMI304.3, EMI305.3, EMI306.3, EMI307.3, EMI308.3, EMI309.3, EMI310.3, EMI311.3, EMI312.3, EMI313.3, EMI314.3, EMI315.3, EMI316.3, EMI317.3, EMI318.3, EMI319.3, EMI320.3, EMI321.3, EMI322.3, EMI323.3, EMI324.3, EMI335.3, EMI336.3, EMI337.3, EMI338.3, EMI339.3, EMI340.3, EMI341.3, J300.3, Q301.2 (E), U108.7 (GND), U203.7 (GND), U300.1 (GND1), U302.7 (GND), U607.7 (GND)
unnamed: C259.1, C912.1, CN300.5, FB301.1
unnamed: C260.1, CN300.1, FB302.1
unnamed: CN304.1, EMI322.2
unnamed: CN304.2, EMI313.2
unnamed: CN304.3, EMI323.2
unnamed: CN304.4, EMI324.2
unnamed: CN304.6, EMI339.2
unnamed: CN304.8, EMI314.2
unnamed: CN304.9, EMI315.2
unnamed: CN304.10, EMI316.2
unnamed: CN304.11, EMI317.2
unnamed: CN304.12, EMI311.2
unnamed: CN304.13, EMI318.2
unnamed: CN304.14, EMI319.2
unnamed: CN304.15, EMI312.2
unnamed: CN304.16, EMI340.2
unnamed: CN304.17, EMI341.2
unnamed: CN304.18, EMI320.2
unnamed: CN304.19, EMI321.2
unnamed: CN305.1, EMI301.2
unnamed: CN305.2, EMI302.2
unnamed: CN305.3, EMI303.2
unnamed: CN305.4, EMI304.2
unnamed: CN305.5, EMI305.2
unnamed: CN305.6, EMI306.2
unnamed: CN305.7, EMI307.2
unnamed: CN305.8, EMI308.2
unnamed: CN305.9, EMI309.2
unnamed: CN305.10, EMI335.2
unnamed: CN305.11, EMI336.2
unnamed: CN305.12, EMI337.2
unnamed: CN305.13, EMI338.2
unnamed: CN305.14, EMI310.1
unnamed: CN305.16, EMI300.1
unnamed: D301.1 (K), R310.2
unnamed: EMI310.2, R310.1
unnamed: EMI320.1, F3.1
unnamed: EMI321.1, F4.1
unnamed: FB301.2, R914.2
unnamed: FB303.2, RN300.4 (R3), U300.39 (S)
unnamed: J301.1, U203.6
unnamed: Q301.1 (B), R300.1, R309.1
unnamed: R300.2, U108.8 (~Q)
unnamed: R309.2, U102.46 (MTRON), U900.2
unnamed: U102.44 (DKWEB), U203.13
unnamed: U102.45 (DKWDB), U203.10
unnamed: U102.47 (MTRX), U203.2
unnamed: U108.11 (C), U203.5, U900.6
unnamed: U300.23 (_CS), U302.3
OVL: U300.2 (PA0)
PBUSY: EMI336.1, RN300.6 (R5)
PPD0: EMI302.1, U300.10 (PB0)
PPD1: EMI303.1, U300.11 (PB1)
PPD2: EMI304.1, U300.12 (PB2)
PPD3: EMI305.1, U300.13 (PB3)
PPD4: EMI306.1, U300.14 (PB4)
PPD5: EMI307.1, U300.15 (PB5)
PPD6: EMI308.1, U300.16 (PB6)
PPD7: EMI309.1, U300.17 (PB7)
PPOUT: EMI337.1, RN300.7 (R6)
PSEL: EMI338.1, RN300.8 (R7)
PSTROBE: EMI301.1, RN300.9 (R8), U300.18 (_PC)
R_W: U300.22 (_W)
TBASE: J300.2, U300.19 (TICK)
_BRST: J300.4, R602.2, U108.10 (~S), U300.34 (_RESET), U607.3, U607.5, U607.10, U607.12
_BUSRST: U607.11
_CHNG: CN303.2, EMI341.1, RN301.2 (R1), U300.4 (PA2)
_DKRD: CN303.30, EMI323.1, R301.2
_DKRST: EMI312.1, U607.6
_DKWD: U102.9 (_DKWD)
_DKWDB: CN303.22, EMI315.1, U203.8
_DKWEB: CN303.24, EMI314.1, U203.11
_FIR0: U300.8 (PA6)
_FIR1: U300.9 (PA7)
_INDEX: CN303.8, EMI340.1, RN301.6 (R5)
_INT2: U300.21 (_INT)
_INUSE0: CN303.6, U900.3
_INUSE1: CN303.4, CN303.14, U108.9 (Q), U203.4
_IORST: C916.1, EMI300.2, U607.8
_KBCLK: FB302.2, RN300.3 (R2), U300.40 (C)
_KBDATA: C261.1, CN300.2, FB303.1
_KBRST: R201.2, U102.5 (_KBRST)
_LED: U300.3 (PA1)
_MTR: U102.7 (_MTR), U108.12 (D)
_MTROD: CN303.16, Q301.3 (C)
_MTRX: EMI311.1, U203.3
_PACK: EMI335.1, RN300.5 (R4), U300.24 (_F)
_RDY: CN303.34, EMI322.1, J301.2, RN301.5 (R4), U300.7 (PA5)
_RST: U607.2
_SEL0: CN303.10, U102.16 (_SEL)
_SEL1: CN303.12, U900.5
_SEL2: EMI319.1
_SEL3: EMI318.1
_SIDE: CN303.32, EMI313.1
_STEP: CN303.20, EMI316.1
_TRK0: CN303.26, EMI339.1, RN301.3 (R2), U300.6 (PA4)
_VMA: U302.2
_VSYNC: J300.1
_WPROT: CN303.28, EMI324.1, RN301.4 (R3), U300.5 (PA3)

Notes on the sheet:
NOTE: J300 SHORT PINS 1 AND 2 FOR A500 STYLE, BABY! THIS IS THE FACTORY SETTING. ADD A TICK GENERATOR WHEN USING A VIDEO DEVICE THAT OVERRIDES THE SYSTEM CLOCK BY USING _XCLKEN.
KEY
PARALLEL
Floppy and Parallel Amiga 2000 EATX
The original A2000 keyboard schematics are messed up. This is correct.
_STROBE
_ACK
BUSY
POUT
SEL
_AUTOLINEFEED
_INIT
