jgrip/Amiga-2000-EATX/2000EATX-KiCAD-R22/isa.sch

## KiCad design 2000EATX-KiCAD-R22/isa.sch (2021-12-02)

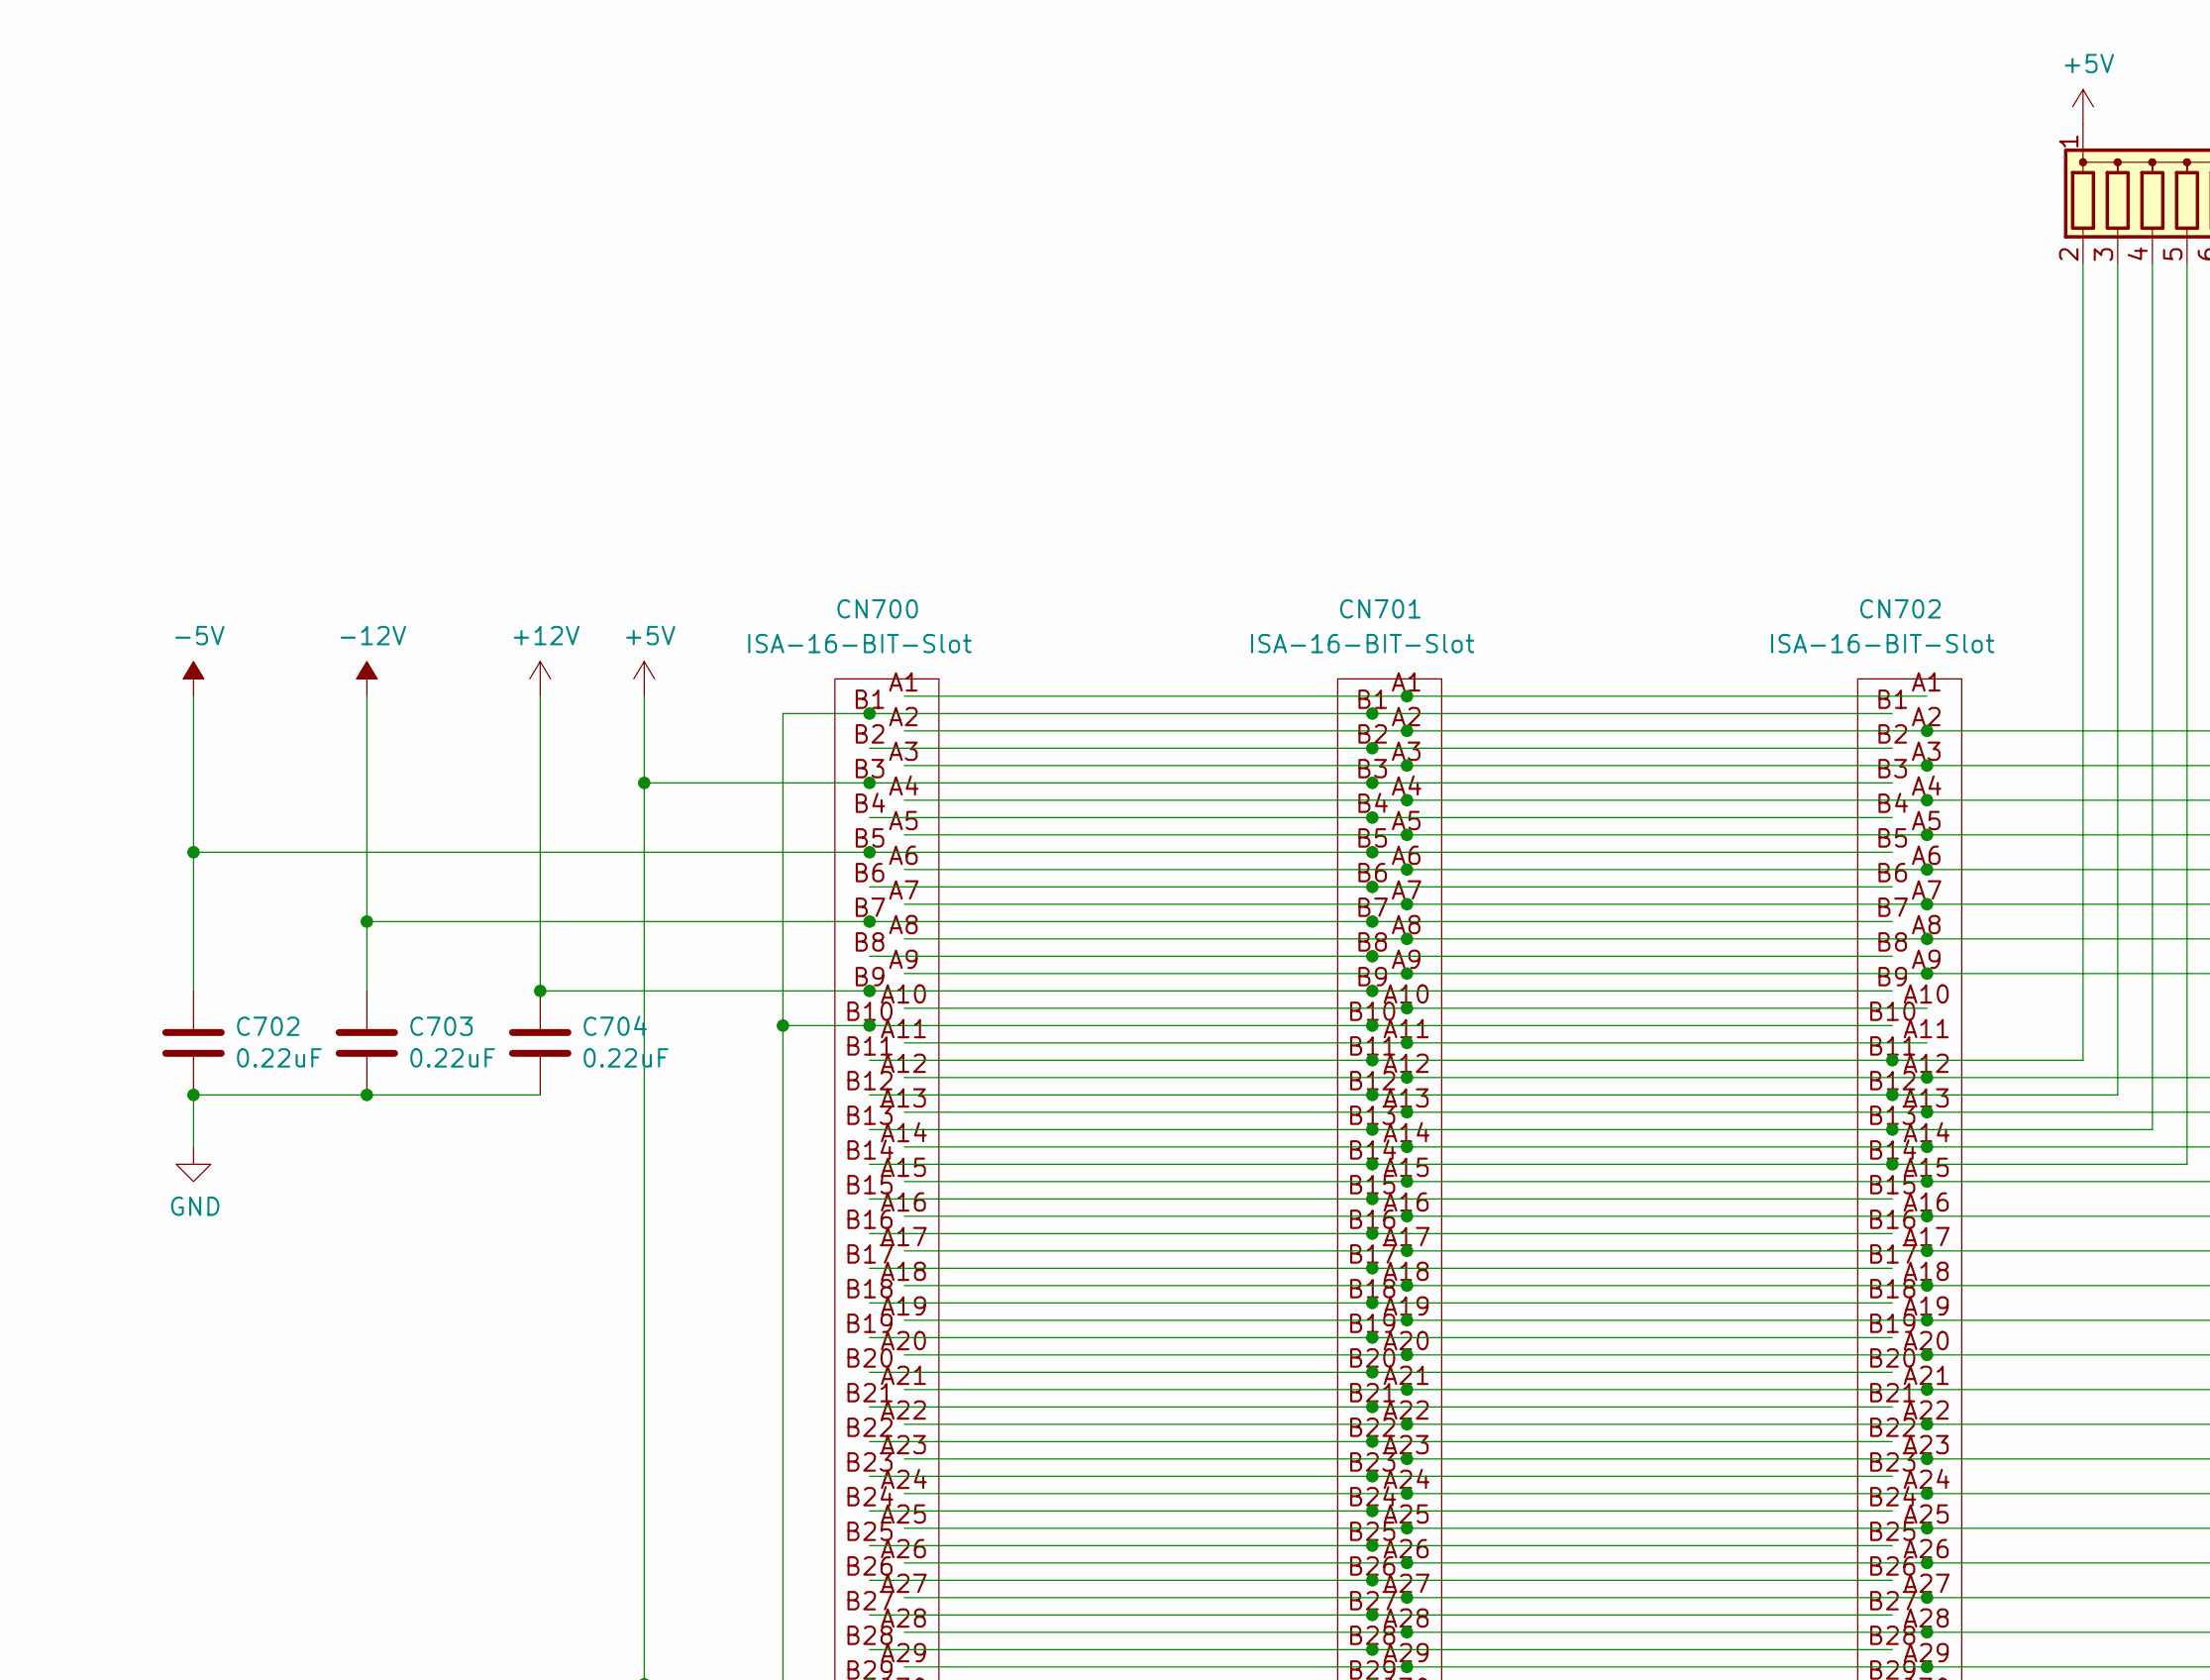
[picture p25: schematic isa.sch, part in row 1, column 1]

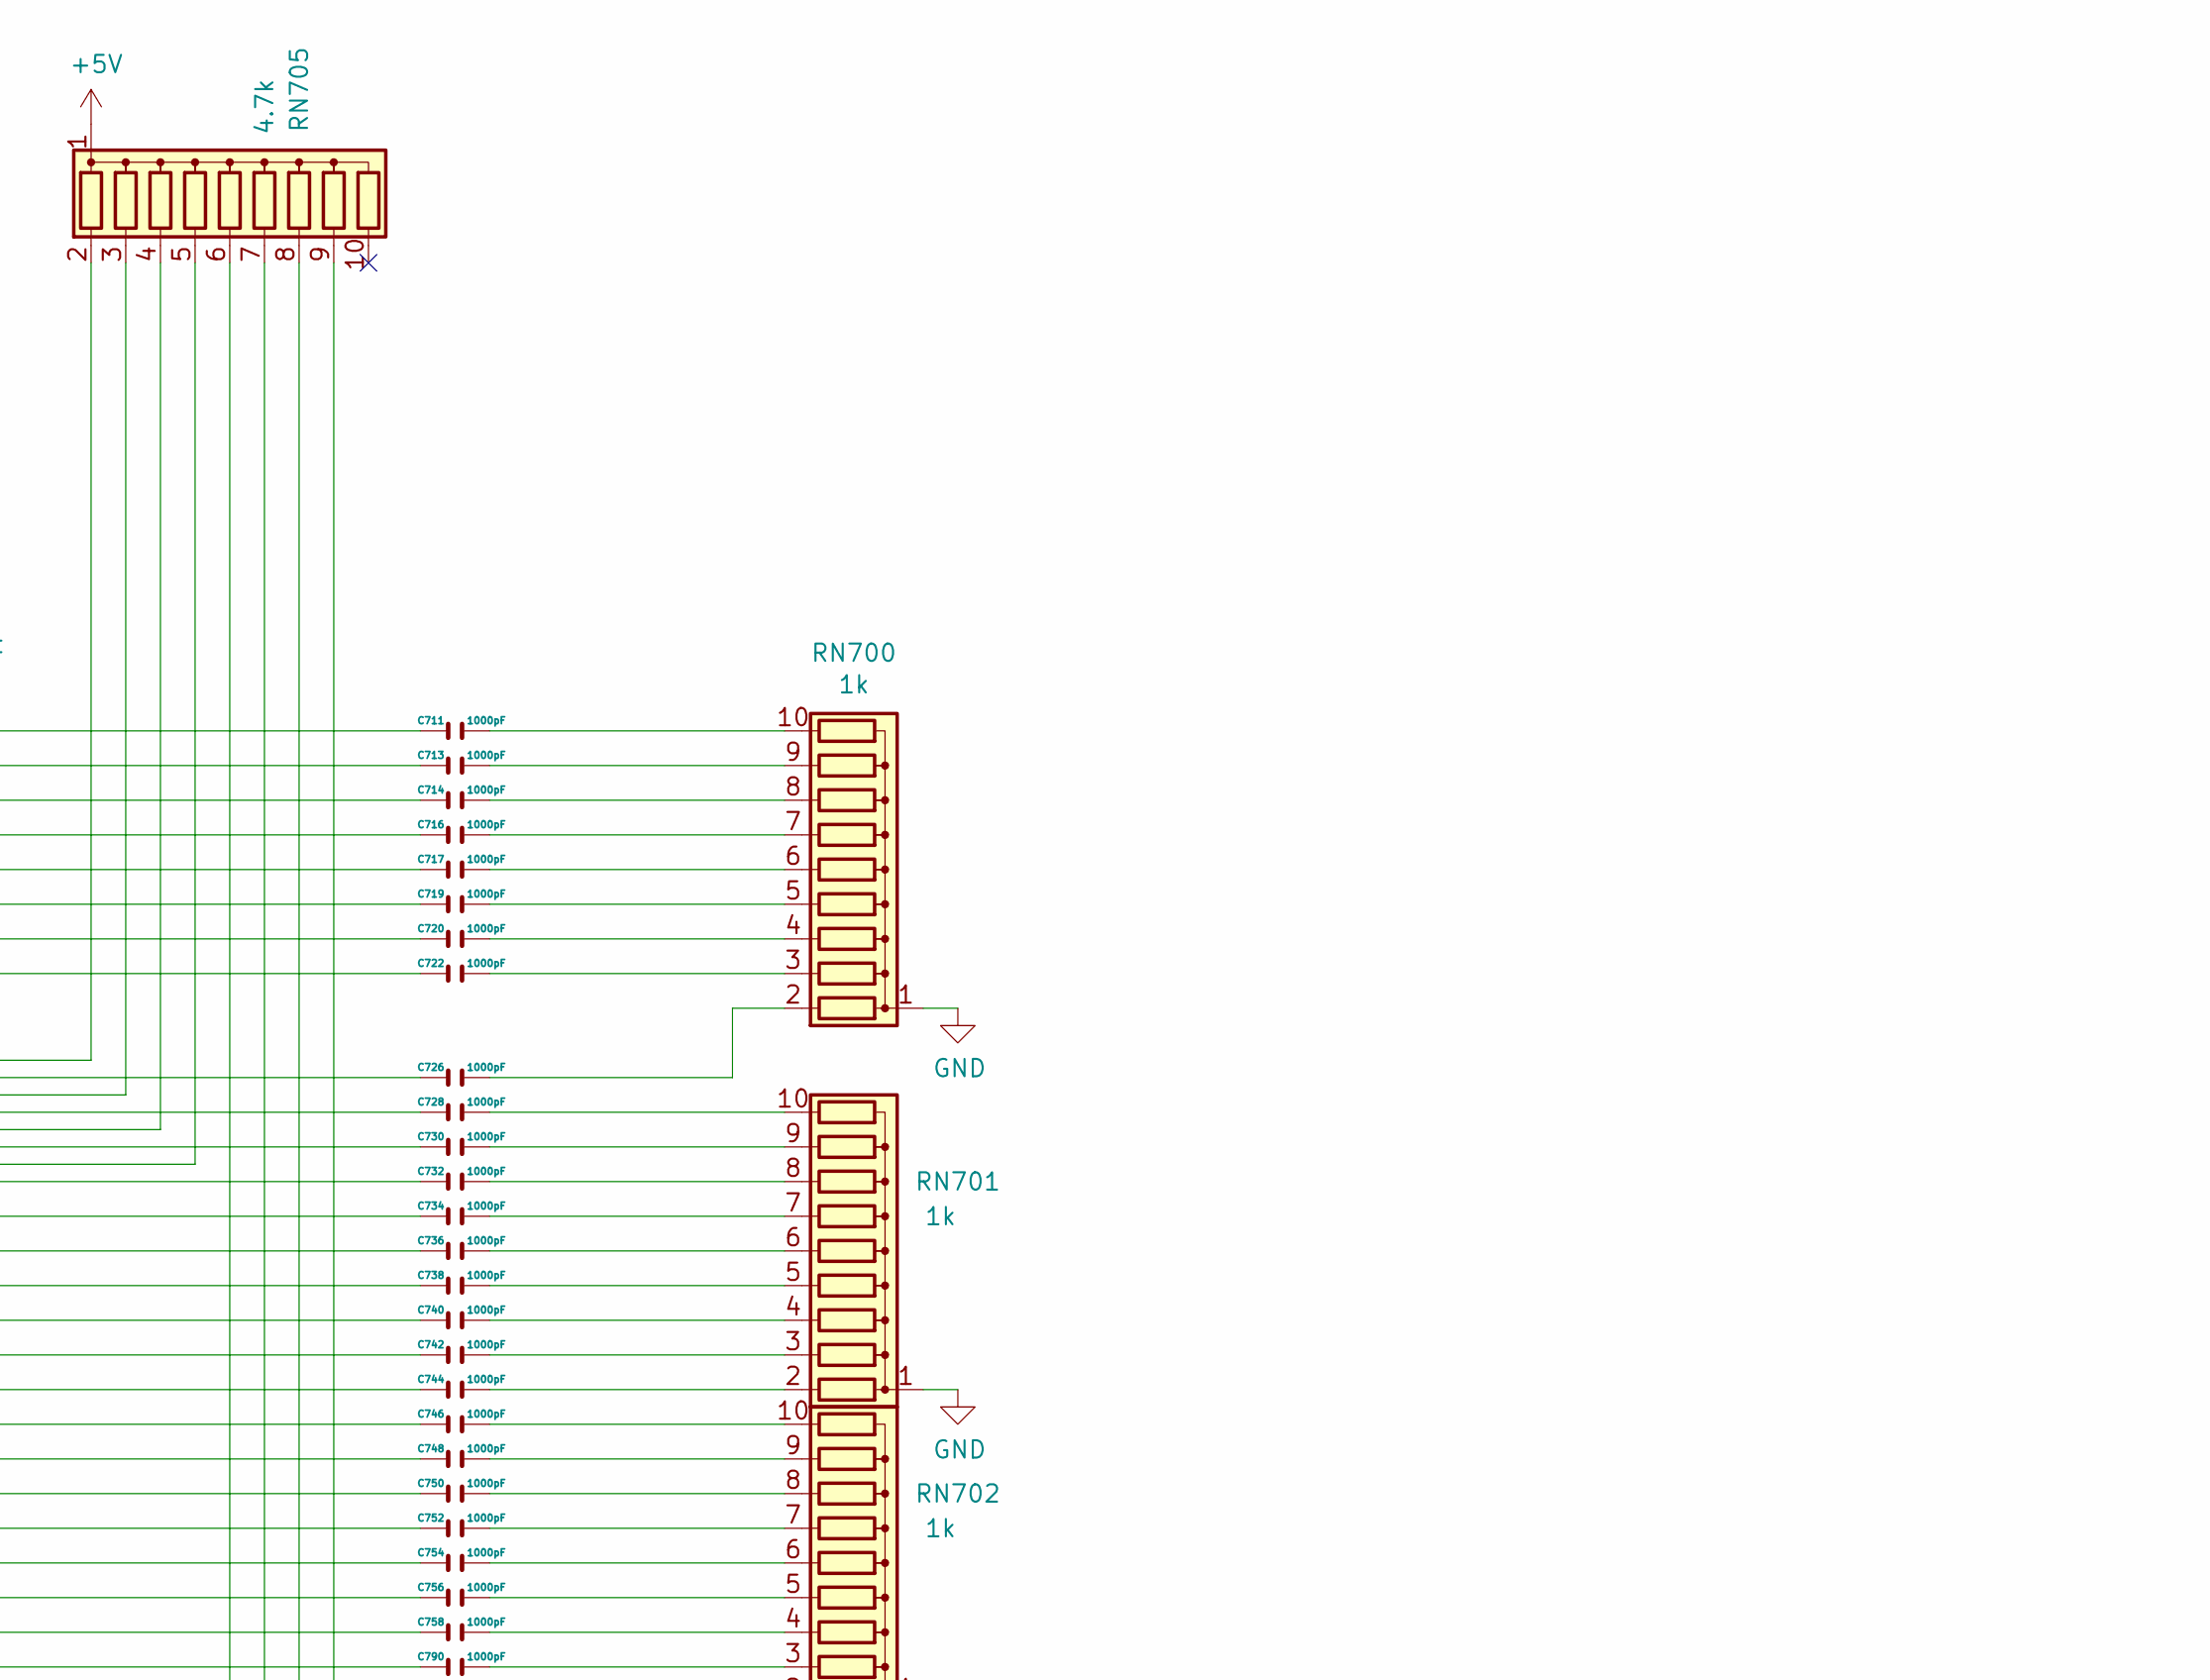
[picture p26: schematic isa.sch, part in row 1, column 2]

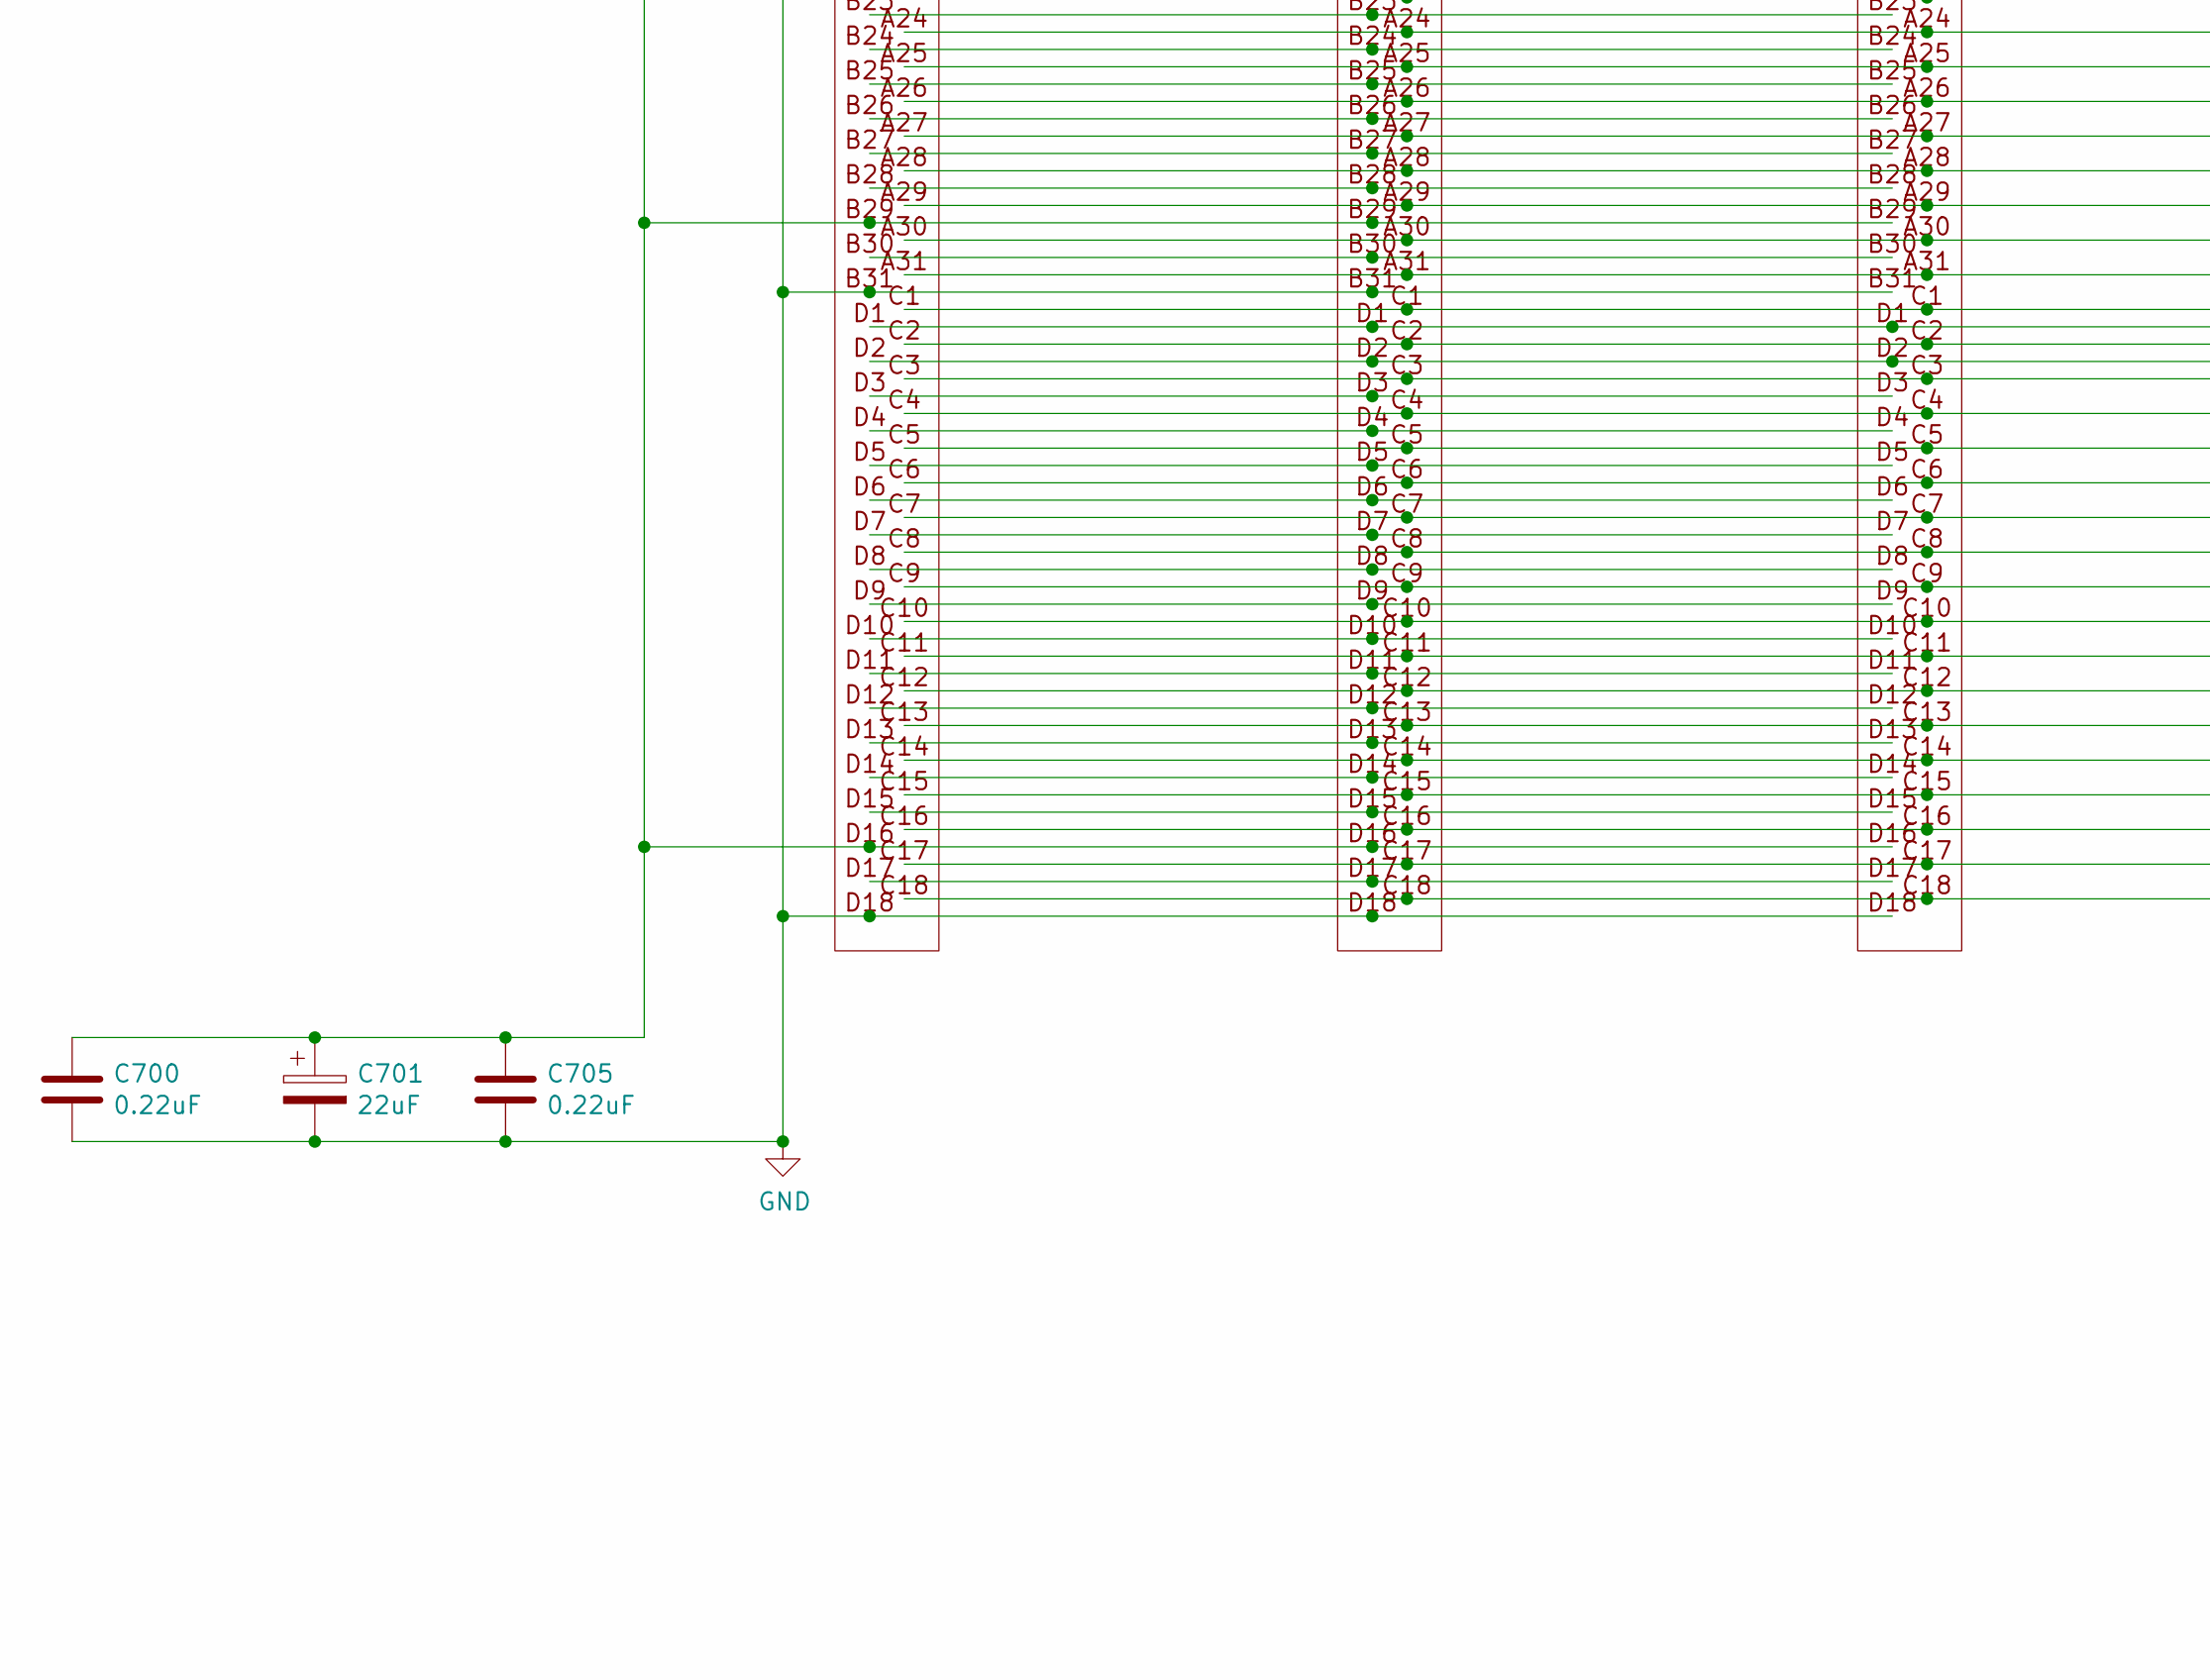
[picture p27: schematic isa.sch, part in row 2, column 1]

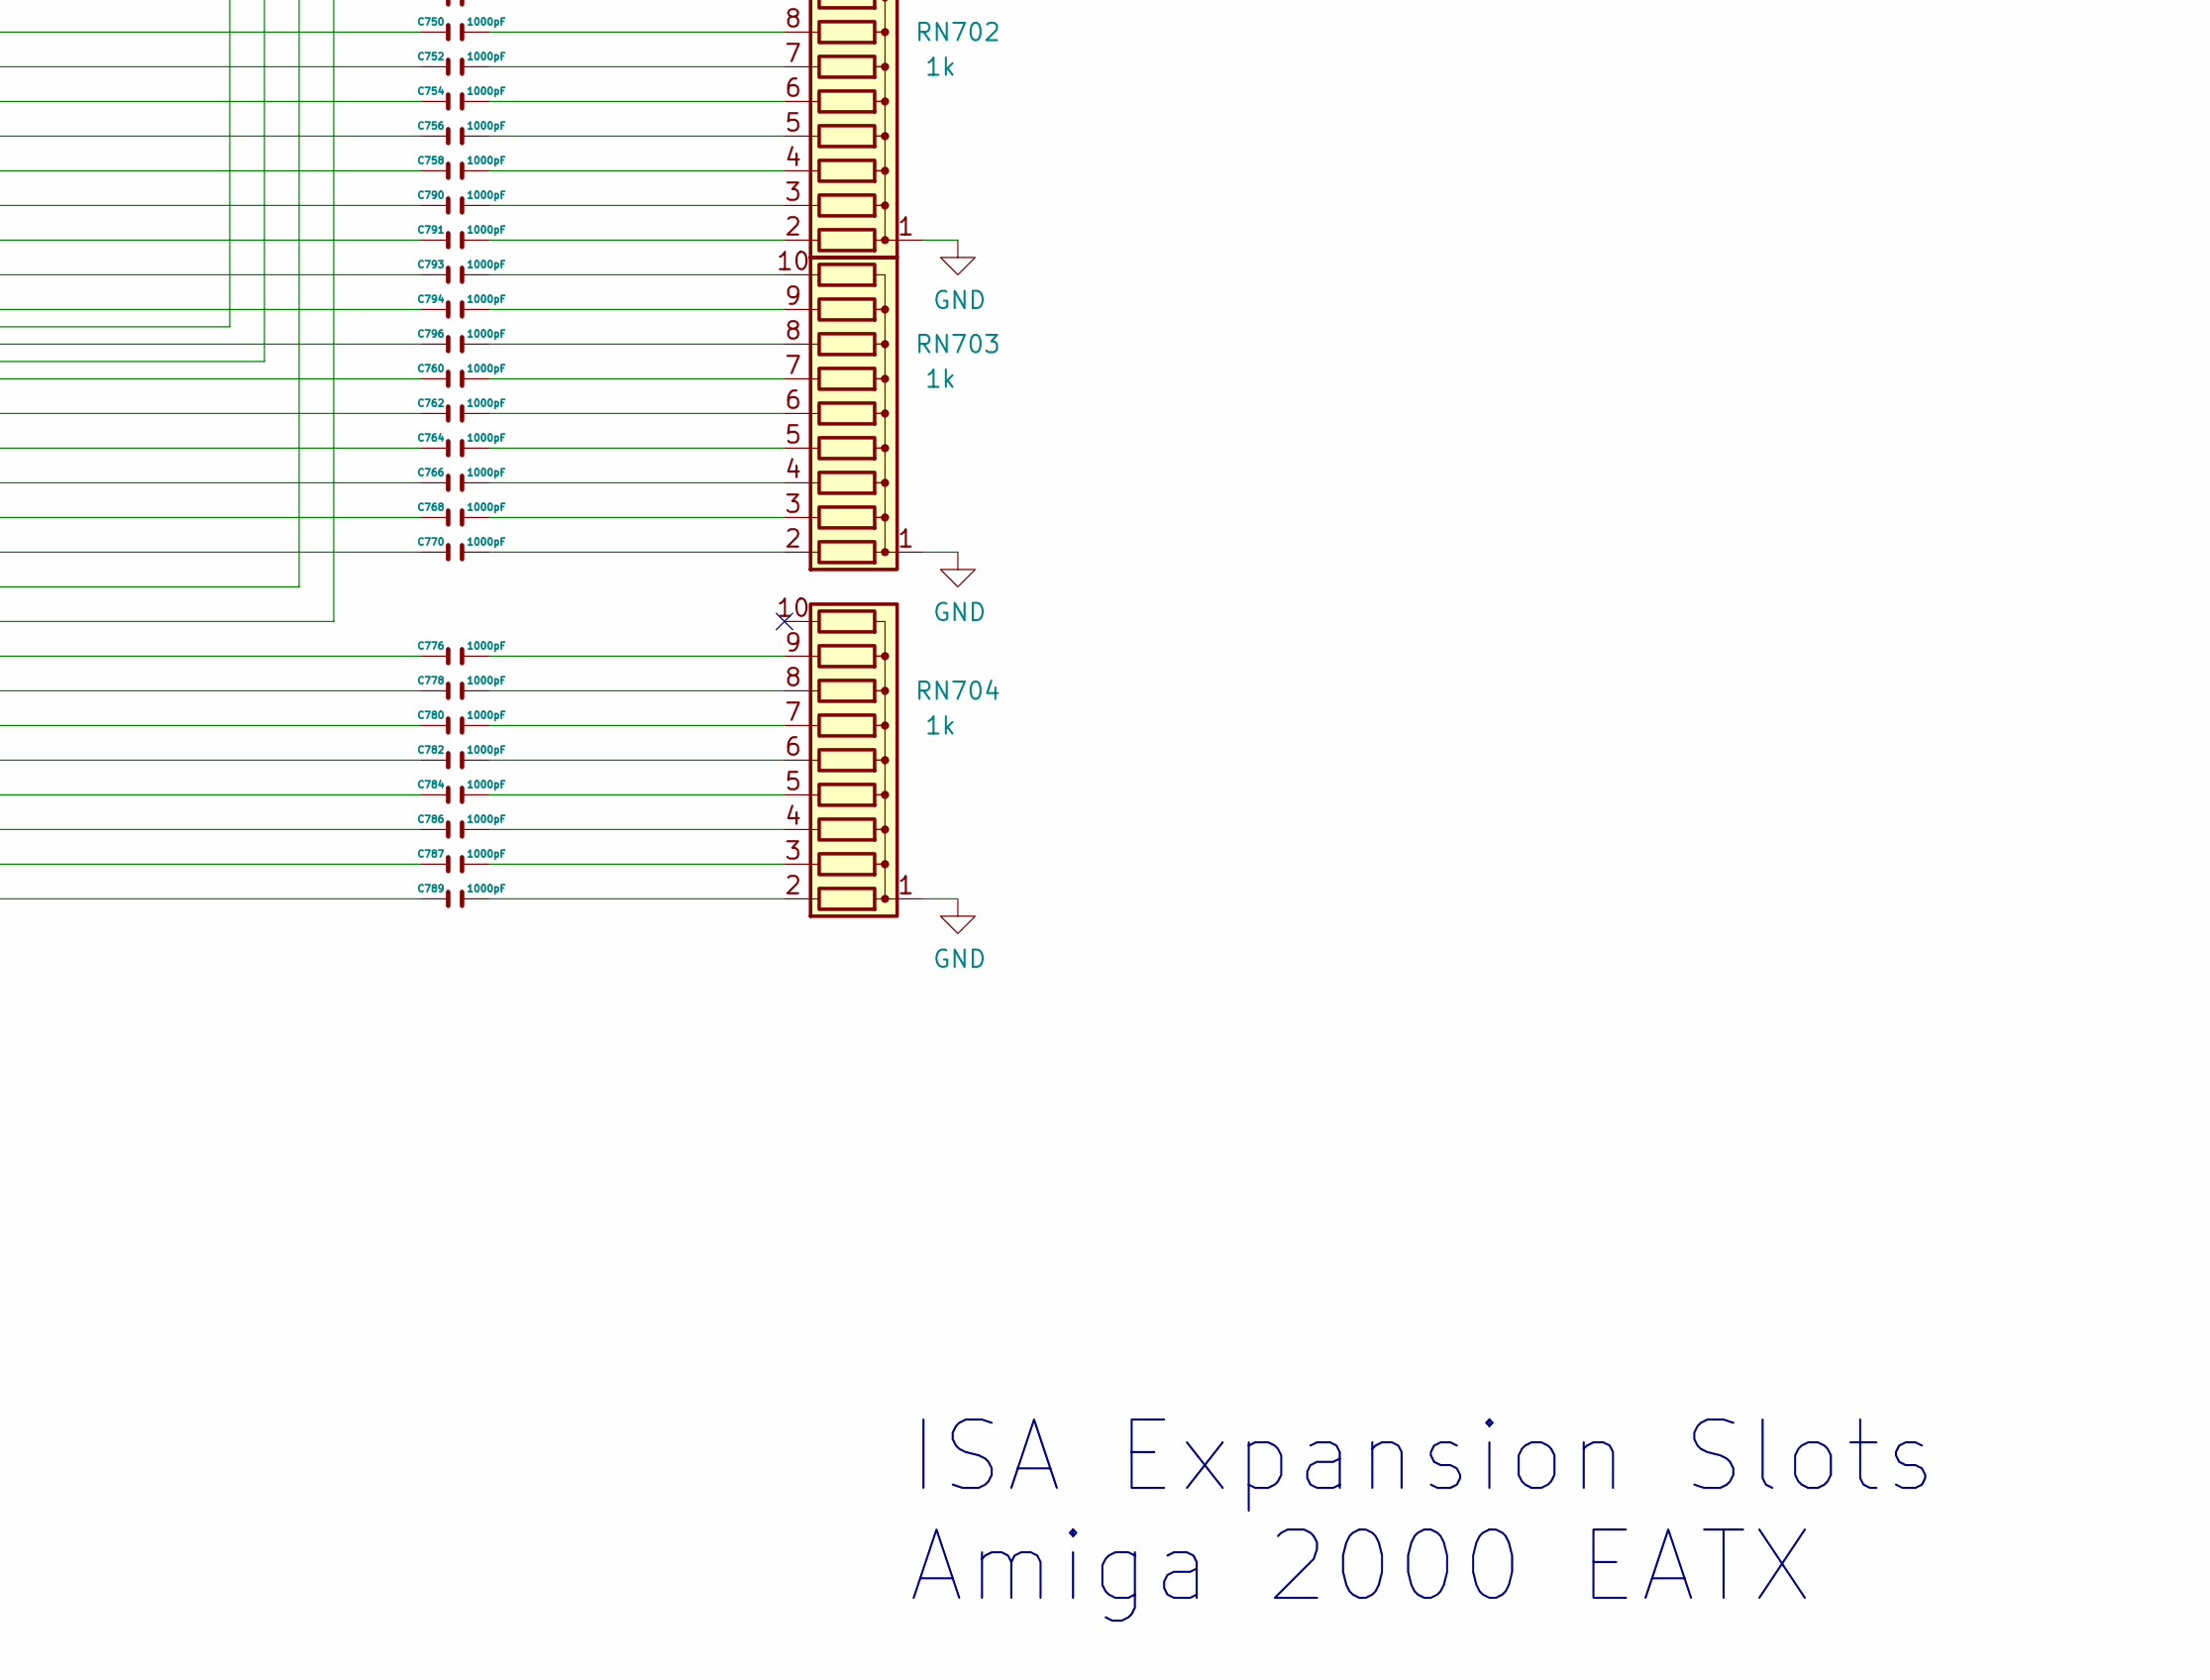
[picture p28: schematic isa.sch, part in row 2, column 2]

Parts:
C700, C702, C703, C704, C705: 0.22uF; C_1206_3216Metric
C701: 22uF; CP_Elec_6.3x5.8
C711, C713, C714, C716, C717, C719, C720, C722, C726, C728, C730, C732, C734, C736, C738, C740, C742, C744, C746, C748, C750, C752, C754, C756, C758, C760, C762, C764, C766, C768, C770, C776, C778, C780, C782, C784, C786, C787, C789, C790, C791, C793, C794, C796: 1000pF; C_1206_3216Metric
CN700, CN701, CN702: ISA-16-BIT-Slot; ISA_16-BIT_P2.54mm_Horizontal
RN700, RN701, RN702, RN703, RN704: 1k; R_Array_SIP10
RN705: 4.7k; R_Array_SIP10

Connections:
+5V: C700.1, C701.1, C705.1, CN700.B3, CN700.B29, CN700.D16, CN701.B3, CN701.B29, CN701.D16, CN702.B3, CN702.B29, CN702.D16, RN705.1 (common)
+12V: C704.1, CN700.B9, CN701.B9, CN702.B9
-5V: C702.1, CN700.B5, CN701.B5, CN702.B5
-12V: C703.1, CN700.B7, CN701.B7, CN702.B7
GND: C700.2, C701.2, C702.2, C703.2, C704.2, C705.2, CN700.B1, CN700.B10, CN700.B31, CN700.D18, CN701.B1, CN701.B10, CN701.B31, CN701.D18, CN702.B1, CN702.B10, CN702.B31, CN702.D18, RN700.1 (common), RN701.1 (common), RN702.1 (common), RN703.1 (common), RN704.1 (common)
unnamed: C711.1, RN700.10 (R9)
unnamed: C711.2, CN700.A2, CN701.A2, CN702.A2
unnamed: C713.1, RN700.9 (R8)
unnamed: C713.2, CN700.A3, CN701.A3, CN702.A3
unnamed: C714.1, RN700.8 (R7)
unnamed: C714.2, CN700.A4, CN701.A4, CN702.A4
unnamed: C716.1, RN700.7 (R6)
unnamed: C716.2, CN700.A5, CN701.A5, CN702.A5
unnamed: C717.1, RN700.6 (R5)
unnamed: C717.2, CN700.A6, CN701.A6, CN702.A6
unnamed: C719.1, RN700.5 (R4)
unnamed: C719.2, CN700.A7, CN701.A7, CN702.A7
unnamed: C720.1, RN700.4 (R3)
unnamed: C720.2, CN700.A8, CN701.A8, CN702.A8
unnamed: C722.1, RN700.3 (R2)
unnamed: C722.2, CN700.A9, CN701.A9, CN702.A9
unnamed: C726.1, RN700.2 (R1)
unnamed: C726.2, CN700.A12, CN701.A12, CN702.A12
unnamed: C728.1, RN701.10 (R9)
unnamed: C728.2, CN700.A13, CN701.A13, CN702.A13
unnamed: C730.1, RN701.9 (R8)
unnamed: C730.2, CN700.A14, CN701.A14, CN702.A14
unnamed: C732.1, RN701.8 (R7)
unnamed: C732.2, CN700.A15, CN701.A15, CN702.A15
unnamed: C734.1, RN701.7 (R6)
unnamed: C734.2, CN700.A16, CN701.A16, CN702.A16
unnamed: C736.1, RN701.6 (R5)
unnamed: C736.2, CN700.A17, CN701.A17, CN702.A17
unnamed: C738.1, RN701.5 (R4)
unnamed: C738.2, CN700.A18, CN701.A18, CN702.A18
unnamed: C740.1, RN701.4 (R3)
unnamed: C740.2, CN700.A19, CN701.A19, CN702.A19
unnamed: C742.1, RN701.3 (R2)
unnamed: C742.2, CN700.A20, CN701.A20, CN702.A20
unnamed: C744.1, RN701.2 (R1)
unnamed: C744.2, CN700.A21, CN701.A21, CN702.A21
unnamed: C746.1, RN702.10 (R9)
unnamed: C746.2, CN700.A22, CN701.A22, CN702.A22
unnamed: C748.1, RN702.9 (R8)
unnamed: C748.2, CN700.A23, CN701.A23, CN702.A23
unnamed: C750.1, RN702.8 (R7)
unnamed: C750.2, CN700.A24, CN701.A24, CN702.A24
unnamed: C752.1, RN702.7 (R6)
unnamed: C752.2, CN700.A25, CN701.A25, CN702.A25
unnamed: C754.1, RN702.6 (R5)
unnamed: C754.2, CN700.A26, CN701.A26, CN702.A26
unnamed: C756.1, RN702.5 (R4)
unnamed: C756.2, CN700.A27, CN701.A27, CN702.A27
unnamed: C758.1, RN702.4 (R3)
unnamed: C758.2, CN700.A28, CN701.A28, CN702.A28
unnamed: C760.1, RN703.7 (R6)
unnamed: C760.2, CN700.C3, CN701.C3, CN702.C3
unnamed: C762.1, RN703.6 (R5)
unnamed: C762.2, CN700.C4, CN701.C4, CN702.C4
unnamed: C764.1, RN703.5 (R4)
unnamed: C764.2, CN700.C5, CN701.C5, CN702.C5
unnamed: C766.1, RN703.4 (R3)
unnamed: C766.2, CN700.C6, CN701.C6, CN702.C6
unnamed: C768.1, RN703.3 (R2)
unnamed: C768.2, CN700.C7, CN701.C7, CN702.C7
unnamed: C770.1, RN703.2 (R1)
unnamed: C770.2, CN700.C8, CN701.C8, CN702.C8
unnamed: C776.1, RN704.9 (R8)
unnamed: C776.2, CN700.C11, CN701.C11, CN702.C11
unnamed: C778.1, RN704.8 (R7)
unnamed: C778.2, CN700.C12, CN701.C12, CN702.C12
unnamed: C780.1, RN704.7 (R6)
unnamed: C780.2, CN700.C13, CN701.C13, CN702.C13
unnamed: C782.1, RN704.6 (R5)
unnamed: C782.2, CN700.C14, CN701.C14, CN702.C14
unnamed: C784.1, RN704.5 (R4)
unnamed: C784.2, CN700.C15, CN701.C15, CN702.C15
unnamed: C786.1, RN704.4 (R3)
unnamed: C786.2, CN700.C16, CN701.C16, CN702.C16
unnamed: C787.1, RN704.3 (R2)
unnamed: C787.2, CN700.C17, CN701.C17, CN702.C17
unnamed: C789.1, RN704.2 (R1)
unnamed: C789.2, CN700.C18, CN701.C18, CN702.C18
unnamed: C790.1, RN702.3 (R2)
unnamed: C790.2, CN700.A29, CN701.A29, CN702.A29
unnamed: C791.1, RN702.2 (R1)
unnamed: C791.2, CN700.A30, CN701.A30, CN702.A30
unnamed: C793.1, RN703.10 (R9)
unnamed: C793.2, CN700.A31, CN701.A31, CN702.A31
unnamed: C794.1, RN703.9 (R8)
unnamed: C794.2, CN700.C1, CN701.C1, CN702.C1
unnamed: C796.1, RN703.8 (R7)
unnamed: C796.2, CN700.C2, CN701.C2, CN702.C2
unnamed: CN700.A1, CN701.A1, CN702.A1
unnamed: CN700.A10, CN701.A10, CN702.A10
unnamed: CN700.A11, CN701.A11, CN702.A11
unnamed: CN700.B2, CN701.B2, CN702.B2
unnamed: CN700.B4, CN701.B4, CN702.B4
unnamed: CN700.B6, CN701.B6, CN702.B6
unnamed: CN700.B8, CN701.B8, CN702.B8
unnamed: CN700.B11, CN701.B11, CN702.B11, RN705.2 (R1)
unnamed: CN700.B12, CN701.B12, CN702.B12, RN705.3 (R2)
unnamed: CN700.B13, CN701.B13, CN702.B13, RN705.4 (R3)
unnamed: CN700.B14, CN701.B14, CN702.B14, RN705.5 (R4)
unnamed: CN700.B15, CN701.B15, CN702.B15
unnamed: CN700.B16, CN701.B16, CN702.B16
unnamed: CN700.B17, CN701.B17, CN702.B17
unnamed: CN700.B18, CN701.B18, CN702.B18
unnamed: CN700.B19, CN701.B19, CN702.B19
unnamed: CN700.B20, CN701.B20, CN702.B20
unnamed: CN700.B21, CN701.B21, CN702.B21
unnamed: CN700.B22, CN701.B22, CN702.B22
unnamed: CN700.B23, CN701.B23, CN702.B23
unnamed: CN700.B24, CN701.B24, CN702.B24
unnamed: CN700.B25, CN701.B25, CN702.B25
unnamed: CN700.B26, CN701.B26, CN702.B26
unnamed: CN700.B27, CN701.B27, CN702.B27
unnamed: CN700.B28, CN701.B28, CN702.B28
unnamed: CN700.B30, CN701.B30, CN702.B30
unnamed: CN700.C9, CN701.C9, CN702.C9, RN705.8 (R7)
unnamed: CN700.C10, CN701.C10, CN702.C10, RN705.9 (R8)
unnamed: CN700.D1, CN701.D1, CN702.D1, RN705.6 (R5)
unnamed: CN700.D2, CN701.D2, CN702.D2, RN705.7 (R6)
unnamed: CN700.D3, CN701.D3, CN702.D3
unnamed: CN700.D4, CN701.D4, CN702.D4
unnamed: CN700.D5, CN701.D5, CN702.D5
unnamed: CN700.D6, CN701.D6, CN702.D6
unnamed: CN700.D7, CN701.D7, CN702.D7
unnamed: CN700.D8, CN701.D8, CN702.D8
unnamed: CN700.D9, CN701.D9, CN702.D9
unnamed: CN700.D10, CN701.D10, CN702.D10
unnamed: CN700.D11, CN701.D11, CN702.D11
unnamed: CN700.D12, CN701.D12, CN702.D12
unnamed: CN700.D13, CN701.D13, CN702.D13
unnamed: CN700.D14, CN701.D14, CN702.D14
unnamed: CN700.D15, CN701.D15, CN702.D15
unnamed: CN700.D17, CN701.D17, CN702.D17

Notes on the sheet:
ISA Expansion Slots Amiga 2000 EATX
