jgrip/Amiga-2000-EATX/2000EATX-KiCAD-R22/memory.sch

## KiCad design 2000EATX-KiCAD-R22/memory.sch (2021-12-02)

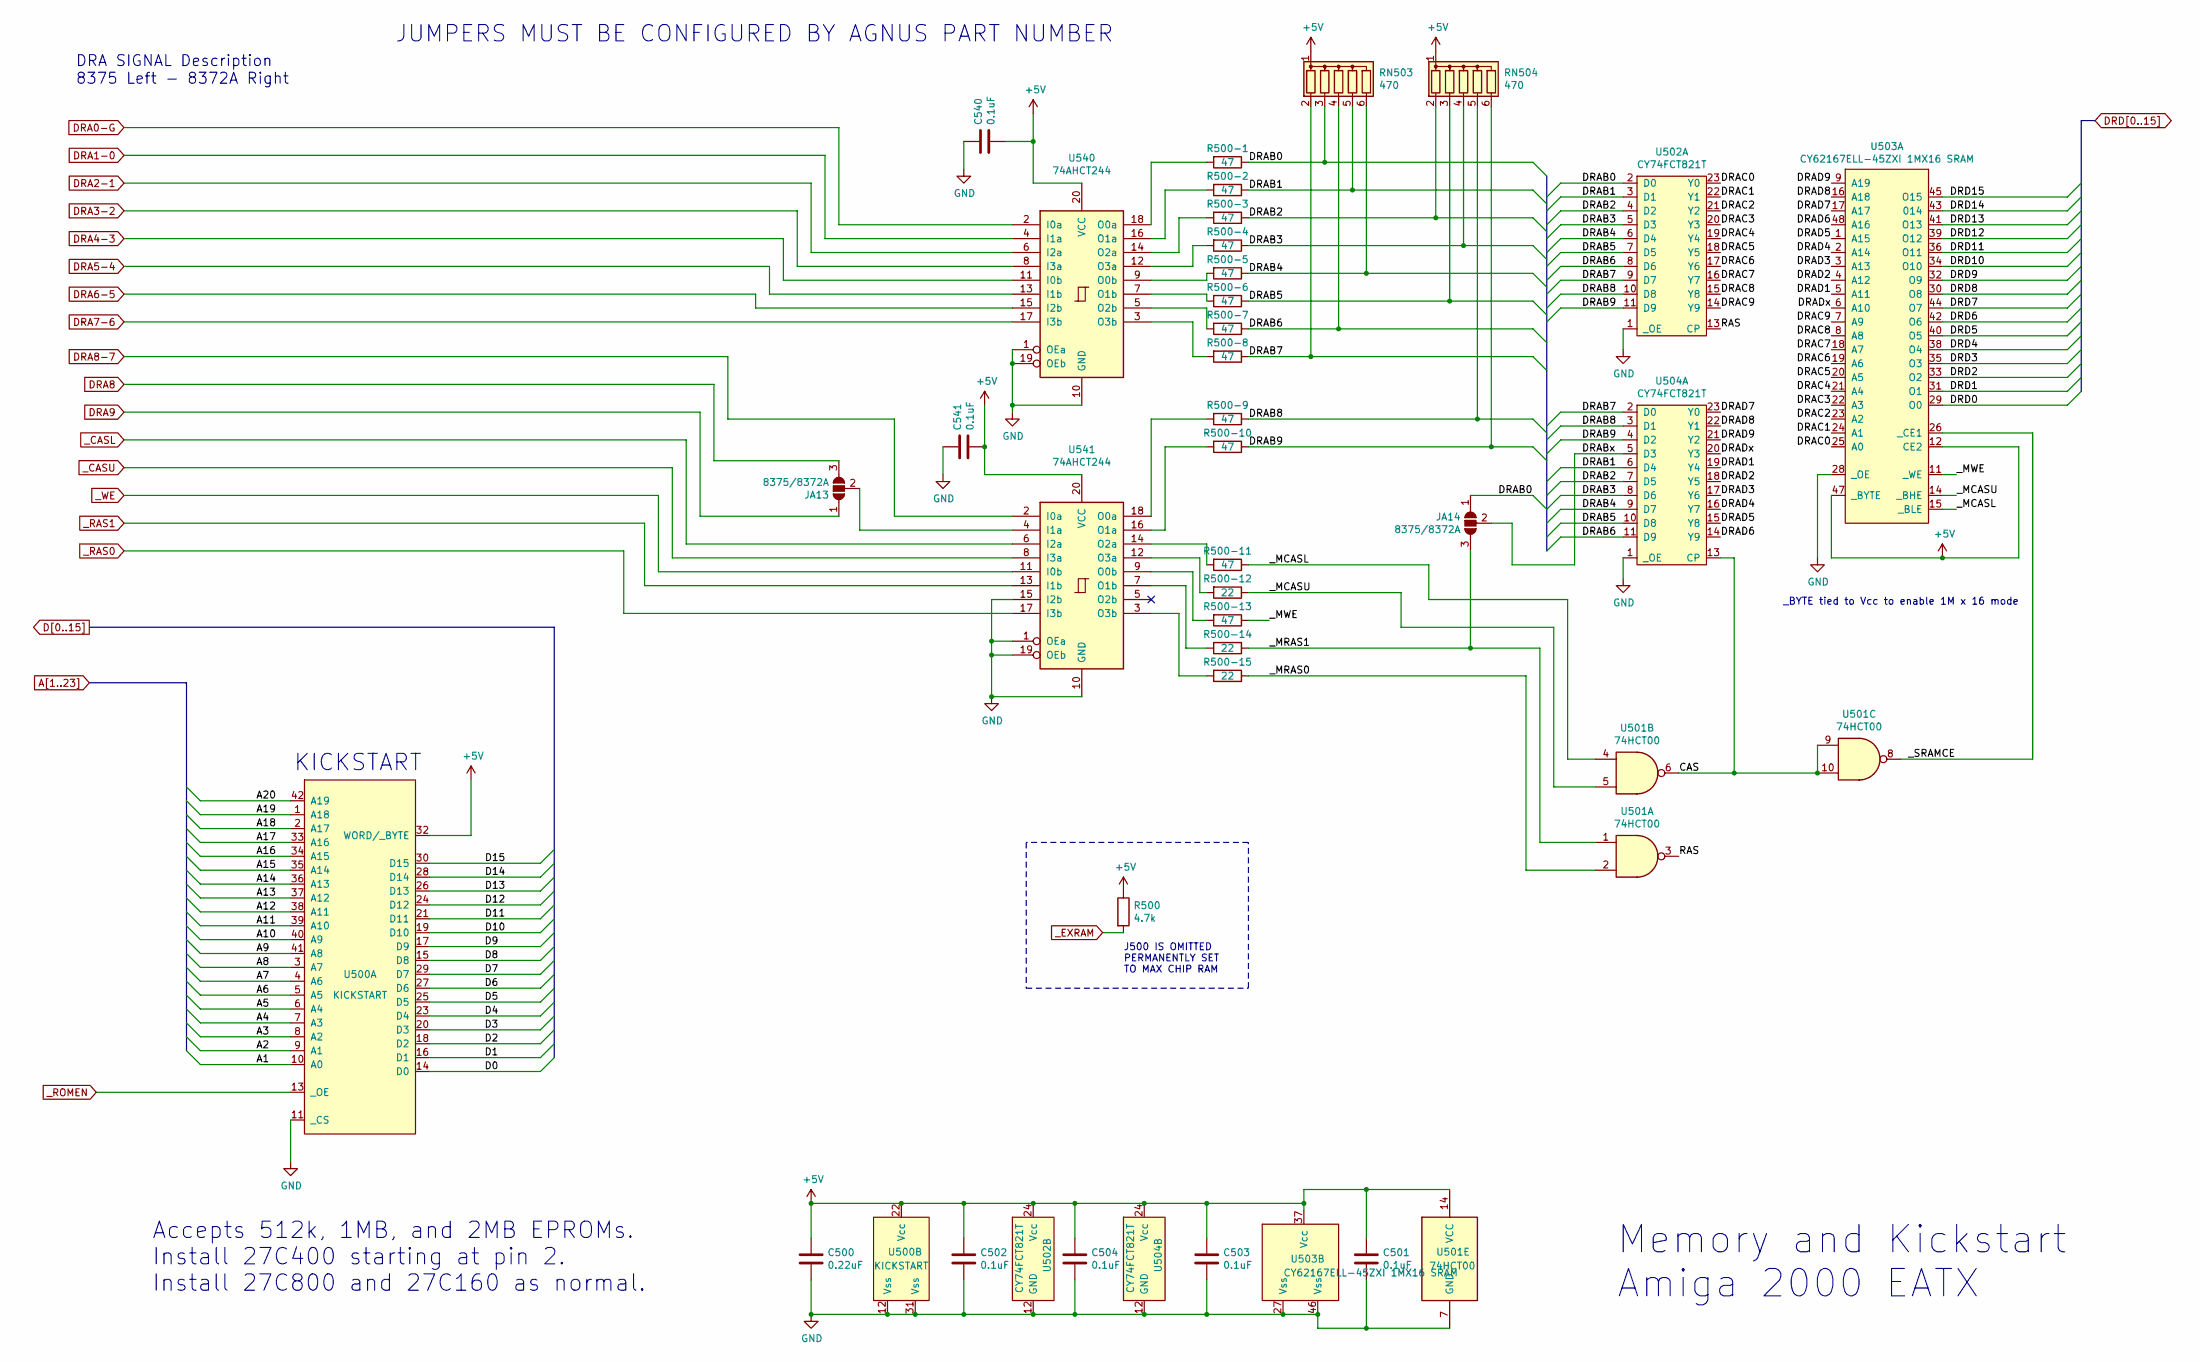
[picture p29: schematic memory.sch]

Parts:
C500: 0.22uF; C_1206_3216Metric
C501, C502, C503, C504, C540, C541: 0.1uF; C_1206_3216Metric
JA13, JA14: 8375/8372A; SolderJumper-3_P1.3mm_Open_RoundedPad1.0x1.5mm
R500: 4.7k; R_1206_3216Metric
R500-1, R500-2, R500-3, R500-4, R500-5, R500-6, R500-7, R500-8, R500-9, R500-10, R500-11, R500-13: 47; R_1206_3216Metric
R500-12, R500-14, R500-15: 22; R_1206_3216Metric
RN503: 470; R_Array_SIP6; Part 4606X-101-471LF
RN504: 470; R_Array_SIP6
U500: KICKSTART; DIP-42_W15.24mm
U501: 74HCT00; SOIC-14_3.9x8.7mm_P1.27mm
U502, U504: CY74FCT821T; SOIC-24W_7.5x15.4mm_P1.27mm
U503: CY62167ELL-45ZXI 1MX16 SRAM; TSOP-I-48_18.4x12mm_P0.5mm
U540, U541: 74AHCT244; SOIC-20W_7.5x12.8mm_P1.27mm

Connections:
+5V: C500.1, C501.1, C502.1, C503.1, C504.1, C540.2, C541.2, R500.1, RN503.1 (common), RN504.1 (common), U500.22 (Vcc), U500.32 (WORD/_BYTE), U501.14 (VCC), U502.24 (Vcc), U503.12 (CE2), U503.37 (Vcc), U503.47 (_BYTE), U504.24 (Vcc), U540.20 (VCC), U541.20 (VCC)
A1: U500.10 (A0)
A2: U500.9 (A1)
A3: U500.8 (A2)
A4: U500.7 (A3)
A5: U500.6 (A4)
A6: U500.5 (A5)
A7: U500.4 (A6)
A8: U500.3 (A7)
A9: U500.41 (A8)
A10: U500.40 (A9)
A11: U500.39 (A10)
A12: U500.38 (A11)
A13: U500.37 (A12)
A14: U500.36 (A13)
A15: U500.35 (A14)
A16: U500.34 (A15)
A17: U500.33 (A16)
A18: U500.2 (A17)
A19: U500.1 (A18)
A20: U500.42 (A19)
CAS: U501.6, U501.9, U501.10, U504.13 (CP)
D0: U500.14 (D0)
D1: U500.16 (D1)
D2: U500.18 (D2)
D3: U500.20 (D3)
D4: U500.23 (D4)
D5: U500.25 (D5)
D6: U500.27 (D6)
D7: U500.29 (D7)
D8: U500.15 (D8)
D9: U500.17 (D9)
D10: U500.19 (D10)
D11: U500.21 (D11)
D12: U500.24 (D12)
D13: U500.26 (D13)
D14: U500.28 (D14)
D15: U500.30 (D15)
DRA0-G: U540.2 (I0a)
DRA1-0: U540.4 (I1a)
DRA2-1: U540.6 (I2a)
DRA3-2: U540.8 (I3a)
DRA4-3: U540.11 (I0b)
DRA5-4: U540.13 (I1b)
DRA6-5: U540.15 (I2b)
DRA7-6: U540.17 (I3b)
DRA8: JA13.3 (B)
DRA8-7: U541.2 (I0a)
DRA9: JA13.1 (A)
DRAB0: JA14.1 (A), R500-1.1, RN503.3 (R2), U502.2 (D0)
DRAB1: R500-2.1, RN503.5 (R4), U502.3 (D1), U504.6 (D4)
DRAB2: R500-3.1, RN504.2 (R1), U502.4 (D2), U504.7 (D5)
DRAB3: R500-4.1, RN504.4 (R3), U502.5 (D3), U504.8 (D6)
DRAB4: R500-5.1, RN503.6 (R5), U502.6 (D4), U504.9 (D7)
DRAB5: R500-6.1, RN504.3 (R2), U502.7 (D5), U504.10 (D8)
DRAB6: R500-7.1, RN503.4 (R3), U502.8 (D6), U504.11 (D9)
DRAB7: R500-8.1, RN503.2 (R1), U502.9 (D7), U504.2 (D0)
DRAB8: R500-9.1, RN504.5 (R4), U502.10 (D8), U504.3 (D1)
DRAB9: R500-10.1, RN504.6 (R5), U502.11 (D9), U504.4 (D2)
DRABx: JA14.2 (C), U504.5 (D3)
DRAC0: U502.23 (Y0), U503.25 (A0)
DRAC1: U502.22 (Y1), U503.24 (A1)
DRAC2: U502.21 (Y2), U503.23 (A2)
DRAC3: U502.20 (Y3), U503.22 (A3)
DRAC4: U502.19 (Y4), U503.21 (A4)
DRAC5: U502.18 (Y5), U503.20 (A5)
DRAC6: U502.17 (Y6), U503.19 (A6)
DRAC7: U502.16 (Y7), U503.18 (A7)
DRAC8: U502.15 (Y8), U503.8 (A8)
DRAC9: U502.14 (Y9), U503.7 (A9)
DRAD1: U503.5 (A11), U504.19 (Y4)
DRAD2: U503.4 (A12), U504.18 (Y5)
DRAD3: U503.3 (A13), U504.17 (Y6)
DRAD4: U503.2 (A14), U504.16 (Y7)
DRAD5: U503.1 (A15), U504.15 (Y8)
DRAD6: U503.48 (A16), U504.14 (Y9)
DRAD7: U503.17 (A17), U504.23 (Y0)
DRAD8: U503.16 (A18), U504.22 (Y1)
DRAD9: U503.9 (A19), U504.21 (Y2)
DRADx: U503.6 (A10), U504.20 (Y3)
DRD0: U503.29 (O0)
DRD1: U503.31 (O1)
DRD2: U503.33 (O2)
DRD3: U503.35 (O3)
DRD4: U503.38 (O4)
DRD5: U503.40 (O5)
DRD6: U503.42 (O6)
DRD7: U503.44 (O7)
DRD8: U503.30 (O8)
DRD9: U503.32 (O9)
DRD10: U503.34 (O10)
DRD11: U503.36 (O11)
DRD12: U503.39 (O12)
DRD13: U503.41 (O13)
DRD14: U503.43 (014)
DRD15: U503.45 (O15)
GND: C500.2, C501.2, C502.2, C503.2, C504.2, C540.1, C541.1, U500.11 (_CS), U500.12 (Vss), U500.31 (Vss), U501.7 (GND), U502.1 (_OE), U502.12 (GND), U503.27 (Vss), U503.28 (_OE), U503.46 (Vss), U504.1 (_OE), U504.12 (GND), U540.1 (OEa), U540.10 (GND), U540.19 (OEb), U541.1 (OEa), U541.10 (GND), U541.15 (I2b), U541.19 (OEb)
unnamed: JA13.2 (C), U541.4 (I1a)
unnamed: R500-1.2, U540.18 (O0a)
unnamed: R500-2.2, U540.16 (O1a)
unnamed: R500-3.2, U540.14 (O2a)
unnamed: R500-4.2, U540.12 (O3a)
unnamed: R500-5.2, U540.9 (O0b)
unnamed: R500-6.2, U540.7 (O1b)
unnamed: R500-7.2, U540.5 (O2b)
unnamed: R500-8.2, U540.3 (O3b)
unnamed: R500-9.2, U541.18 (O0a)
unnamed: R500-10.2, U541.16 (O1a)
unnamed: R500-11.2, U541.14 (O2a)
unnamed: R500-12.2, U541.12 (O3a)
unnamed: R500-13.2, U541.9 (O0b)
unnamed: R500-14.2, U541.7 (O1b)
unnamed: R500-15.2, U541.3 (O3b)
RAS: U501.3, U502.13 (CP)
_CASL: U541.6 (I2a)
_CASU: U541.8 (I3a)
_EXRAM: R500.2
_MCASL: R500-11.1, U501.4, U503.15 (_BLE)
_MCASU: R500-12.1, U501.5, U503.14 (_BHE)
_MRAS0: R500-15.1, U501.2
_MRAS1: JA14.3 (B), R500-14.1, U501.1
_MWE: R500-13.1, U503.11 (_WE)
_RAS0: U541.17 (I3b)
_RAS1: U541.13 (I1b)
_ROMEN: U500.13 (_OE)
_SRAMCE: U501.8, U503.26 (_CE1)
_WE: U541.11 (I0b)

Notes on the sheet:
J500 IS OMITTED PERMANENTLY SET TO MAX CHIP RAM
KICKSTART
Memory and Kickstart Amiga 2000 EATX
Accepts 512k, 1MB, and 2MB EPROMs. Install 27C400 starting at pin 2. Install 27C800 and 27C160 as normal.
_BYTE tied to Vcc to enable 1M x 16 mode
JUMPERS MUST BE CONFIGURED BY AGNUS PART NUMBER
DRA SIGNAL Description 8375 Left - 8372A Right
