jgrip/Amiga-2000-EATX/2000EATX-KiCAD-R22/paula.sch

## KiCad design 2000EATX-KiCAD-R22/paula.sch (2021-12-02)

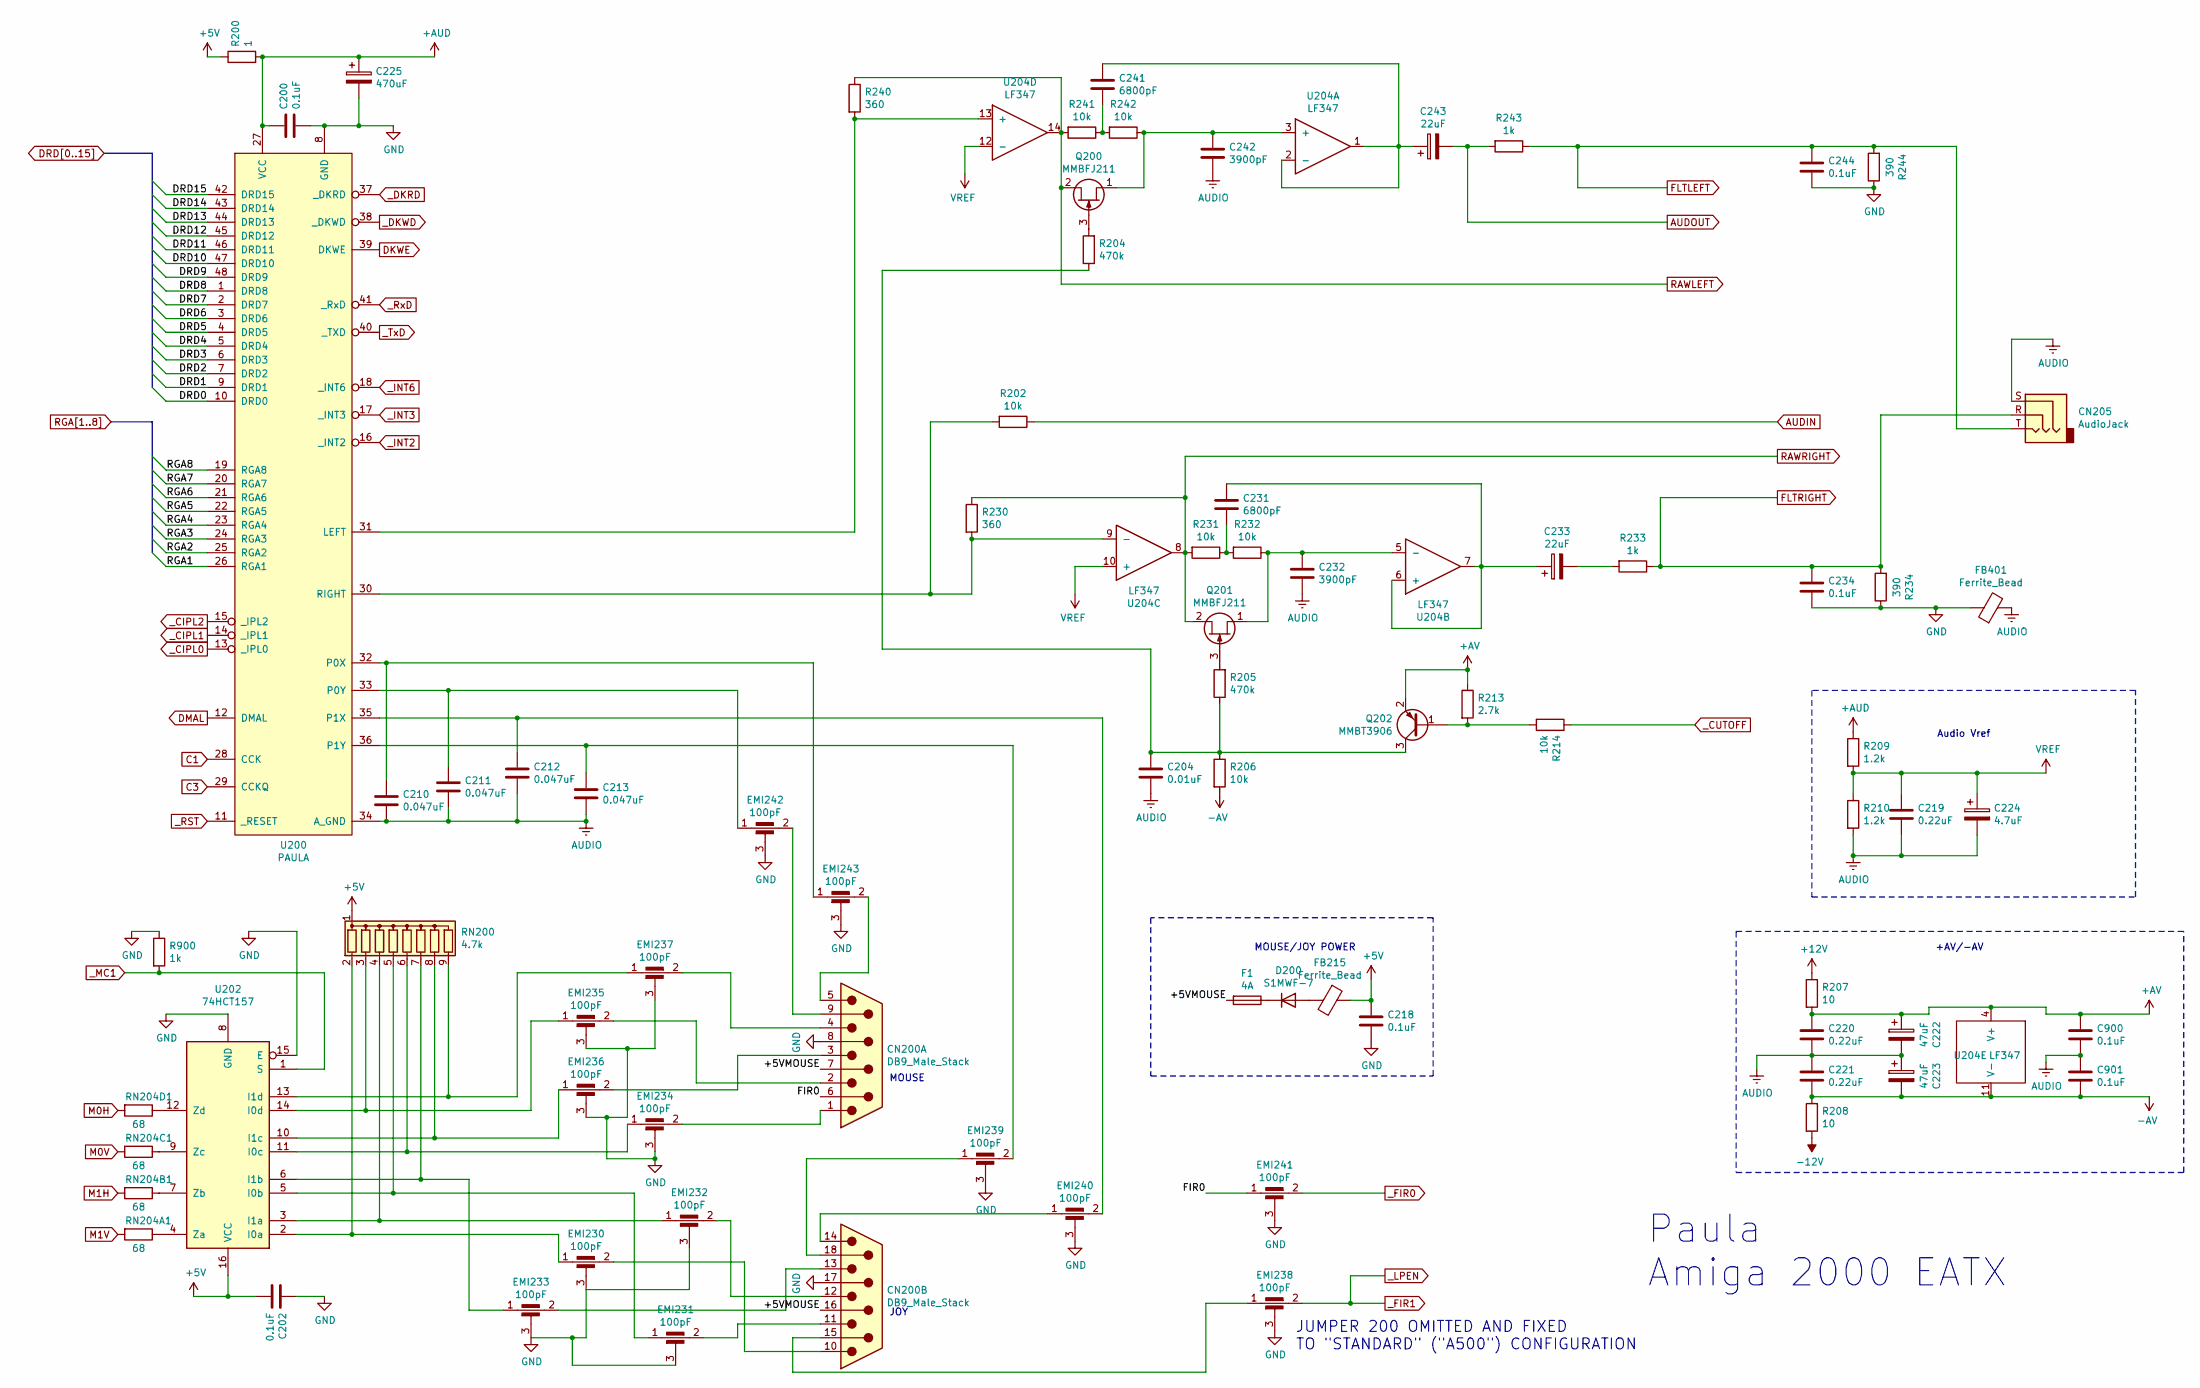
[picture p30: schematic paula.sch]

Parts:
C200, C202, C218, C234, C244, C900, C901: 0.1uF; C_1206_3216Metric
C204: 0.01uF; C_1206_3216Metric
C210, C211, C212, C213: 0.047uF; C_1206_3216Metric
C219, C220, C221: 0.22uF; C_1206_3216Metric
C222, C223: 47uF; CP_Elec_8x10
C224: 4.7uF; CP_Elec_4x5.8
C225: 470uF; CP_Elec_8x10
C231, C241: 6800pF; C_1206_3216Metric
C232, C242: 3900pF; C_1206_3216Metric
C233, C243: 22uF; CP_Elec_6.3x5.8
CN200: DB9_Male_Stack; DSUB-9_Male_Stack
CN205: AudioJack; Jack_3.5mm_CUI_SJ1-3533NG_Horizontal_CircularHoles; Part SJ1-3533NG
D200: S1MWF-7; D_SOD-123F
EMI230, EMI231, EMI232, EMI233, EMI234, EMI235, EMI236, EMI237, EMI238, EMI239, EMI240, EMI241, EMI242, EMI243: 100pF; C_1206_3216_Feedthrough
F1: 4A; Fuse_1206_3216Metric
FB215, FB401: Ferrite_Bead; C_1206_3216Metric
Q200, Q201: MMBFJ211; SOT-23
Q202: MMBT3906; SOT-23
R200: 1; R_1206_3216Metric
R202, R206, R214, R231, R232, R241, R242: 10k; R_1206_3216Metric
R204, R205: 470k; R_1206_3216Metric
R207, R208: 10; R_1206_3216Metric
R209, R210: 1.2k; R_1206_3216Metric
R213: 2.7k; R_1206_3216Metric
R230, R240: 360; R_1206_3216Metric
R233, R243, R900: 1k; R_1206_3216Metric
R234, R244: 390; R_1206_3216Metric
RN200: 4.7k; R_Array_SIP9
RN204A1, RN204B1, RN204C1, RN204D1: 68; R_1206_3216Metric
U200: PAULA; DIP-48_W15.24mm
U202: 74HCT157; SOIC-16_3.9x9.9mm_P1.27mm
U204: LF347; SOIC-14_3.9x8.7mm_P1.27mm

Connections:
+5V: C202.2, C218.1, FB215.1, R200.1, RN200.1 (common), U202.16 (VCC)
+5VMOUSE: CN200.7, CN200.16, F1.2
+12V: R207.1
+AUD: C200.1, C225.1, R200.2, R209.1, U200.27 (VCC)
+AV: C220.1, C222.1, C900.1, Q202.2 (E), R207.2, R213.1, U204.4 (V+)
-12V: R208.2
-AV: C221.2, C223.2, C901.2, R206.2, R208.1, U204.11 (V-)
AUDIN: R202.1
AUDIO: C204.2, C210.2, C211.2, C212.2, C213.2, C219.2, C220.2, C221.1, C222.2, C223.1, C224.2, C232.2, C242.2, C900.2, C901.1, CN205.S, FB401.2, R210.2, U200.34 (A_GND)
AUDOUT: C243.2, R243.2
C1: U200.28 (CCK)
C3: U200.29 (CCKQ)
DKWE: U200.39 (DKWE)
DMAL: U200.12 (DMAL)
DRD0: U200.10 (DRD0)
DRD1: U200.9 (DRD1)
DRD2: U200.7 (DRD2)
DRD3: U200.6 (DRD3)
DRD4: U200.5 (DRD4)
DRD5: U200.4 (DRD5)
DRD6: U200.3 (DRD6)
DRD7: U200.2 (DRD7)
DRD8: U200.1 (DRD8)
DRD9: U200.48 (DRD9)
DRD10: U200.47 (DRD10)
DRD11: U200.46 (DRD11)
DRD12: U200.45 (DRD12)
DRD13: U200.44 (DRD13)
DRD14: U200.43 (DRD14)
DRD15: U200.42 (DRD15)
FIR0: CN200.6, EMI241.1
FLTLEFT: C244.1, CN205.T, R243.1, R244.2
FLTRIGHT: C234.1, CN205.R, R233.1, R234.2
GND: C200.2, C202.1, C218.2, C225.2, C234.2, C244.2, CN200.8, CN200.17, EMI230.3, EMI231.3, EMI232.3, EMI233.3, EMI234.3, EMI235.3, EMI236.3, EMI237.3, EMI238.3, EMI239.3, EMI240.3, EMI241.3, EMI242.3, EMI243.3, FB401.1, R234.1, R244.1, R900.1, U200.8 (GND), U202.8 (GND), U202.15 (E)
M0H: RN204D1.2
M0V: RN204C1.2
M1H: RN204B1.2
M1V: RN204A1.2
unnamed: C204.1, Q202.3 (C), R204.1, R205.1, R206.1
unnamed: C210.1, EMI243.1, U200.32 (P0X)
unnamed: C211.1, EMI242.1, U200.33 (P0Y)
unnamed: C212.1, EMI240.2, U200.35 (P1X)
unnamed: C213.1, EMI239.2, U200.36 (P1Y)
unnamed: C231.1, C233.1, U204.6 (+), U204.7
unnamed: C231.2, R231.1, R232.2
unnamed: C232.1, Q201.1 (S), R232.1, U204.5 (-)
unnamed: C233.2, R233.2
unnamed: C241.1, C243.1, U204.1, U204.2 (-)
unnamed: C241.2, R241.1, R242.2
unnamed: C242.1, Q200.1 (S), R242.1, U204.3 (+)
unnamed: CN200.1, EMI234.2
unnamed: CN200.2, EMI235.2
unnamed: CN200.3, EMI236.2
unnamed: CN200.4, EMI237.2
unnamed: CN200.5, EMI243.2
unnamed: CN200.9, EMI242.2
unnamed: CN200.10, EMI230.2
unnamed: CN200.11, EMI231.2
unnamed: CN200.12, EMI232.2
unnamed: CN200.13, EMI233.2
unnamed: CN200.14, EMI240.1
unnamed: CN200.15, EMI238.1
unnamed: CN200.18, EMI239.1
unnamed: D200.1 (K), F1.1
unnamed: D200.2 (A), FB215.2
unnamed: EMI230.1, RN200.2 (R1), U202.2 (I0a)
unnamed: EMI231.1, RN200.5 (R4), U202.5 (I0b)
unnamed: EMI232.1, RN200.4 (R3), U202.3 (I1a)
unnamed: EMI233.1, RN200.7 (R6), U202.6 (I1b)
unnamed: EMI234.1, RN200.6 (R5), U202.11 (I0c)
unnamed: EMI235.1, RN200.3 (R2), U202.14 (I0d)
unnamed: EMI236.1, RN200.8 (R7), U202.10 (I1c)
unnamed: EMI237.1, RN200.9 (R8), U202.13 (I1d)
unnamed: Q200.3 (G), R204.2
unnamed: Q201.3 (G), R205.2
unnamed: Q202.1 (B), R213.2, R214.2
unnamed: R202.2, R230.2, U200.30 (RIGHT), U204.9 (-)
unnamed: R240.2, U200.31 (LEFT), U204.13 (+)
unnamed: RN204A1.1, U202.4 (Za)
unnamed: RN204B1.1, U202.7 (Zb)
unnamed: RN204C1.1, U202.9 (Zc)
unnamed: RN204D1.1, U202.12 (Zd)
RAWLEFT: Q200.2 (D), R240.1, R241.2, U204.14
RAWRIGHT: Q201.2 (D), R230.1, R231.2, U204.8
RGA1: U200.26 (RGA1)
RGA2: U200.25 (RGA2)
RGA3: U200.24 (RGA3)
RGA4: U200.23 (RGA4)
RGA5: U200.22 (RGA5)
RGA6: U200.21 (RGA6)
RGA7: U200.20 (RGA7)
RGA8: U200.19 (RGA8)
VREF: C219.1, C224.1, R209.2, R210.1, U204.10 (+), U204.12 (-)
_CIPL0: U200.13 (_IPL0)
_CIPL1: U200.14 (_IPL1)
_CIPL2: U200.15 (_IPL2)
_CUTOFF: R214.1
_DKRD: U200.37 (_DKRD)
_DKWD: U200.38 (_DKWD)
_FIR0: EMI241.2
_FIR1: EMI238.2
_INT2: U200.16 (_INT2)
_INT3: U200.17 (_INT3)
_INT6: U200.18 (_INT6)
_MC1: R900.2, U202.1 (S)
_RST: U200.11 (_RESET)
_RxD: U200.41 (_RxD)
_TxD: U200.40 (_TXD)

Notes on the sheet:
JUMPER 200 OMITTED AND FIXED TO "STANDARD" ("A500") CONFIGURATION
MOUSE/JOY POWER
Paula Amiga 2000 EATX
Audio Vref
+AV/-AV
MOUSE
JOY
