jgrip/Amiga-2000-EATX/2000EATX-KiCAD-R22/power.sch

## KiCad design 2000EATX-KiCAD-R22/power.sch (2021-12-02)

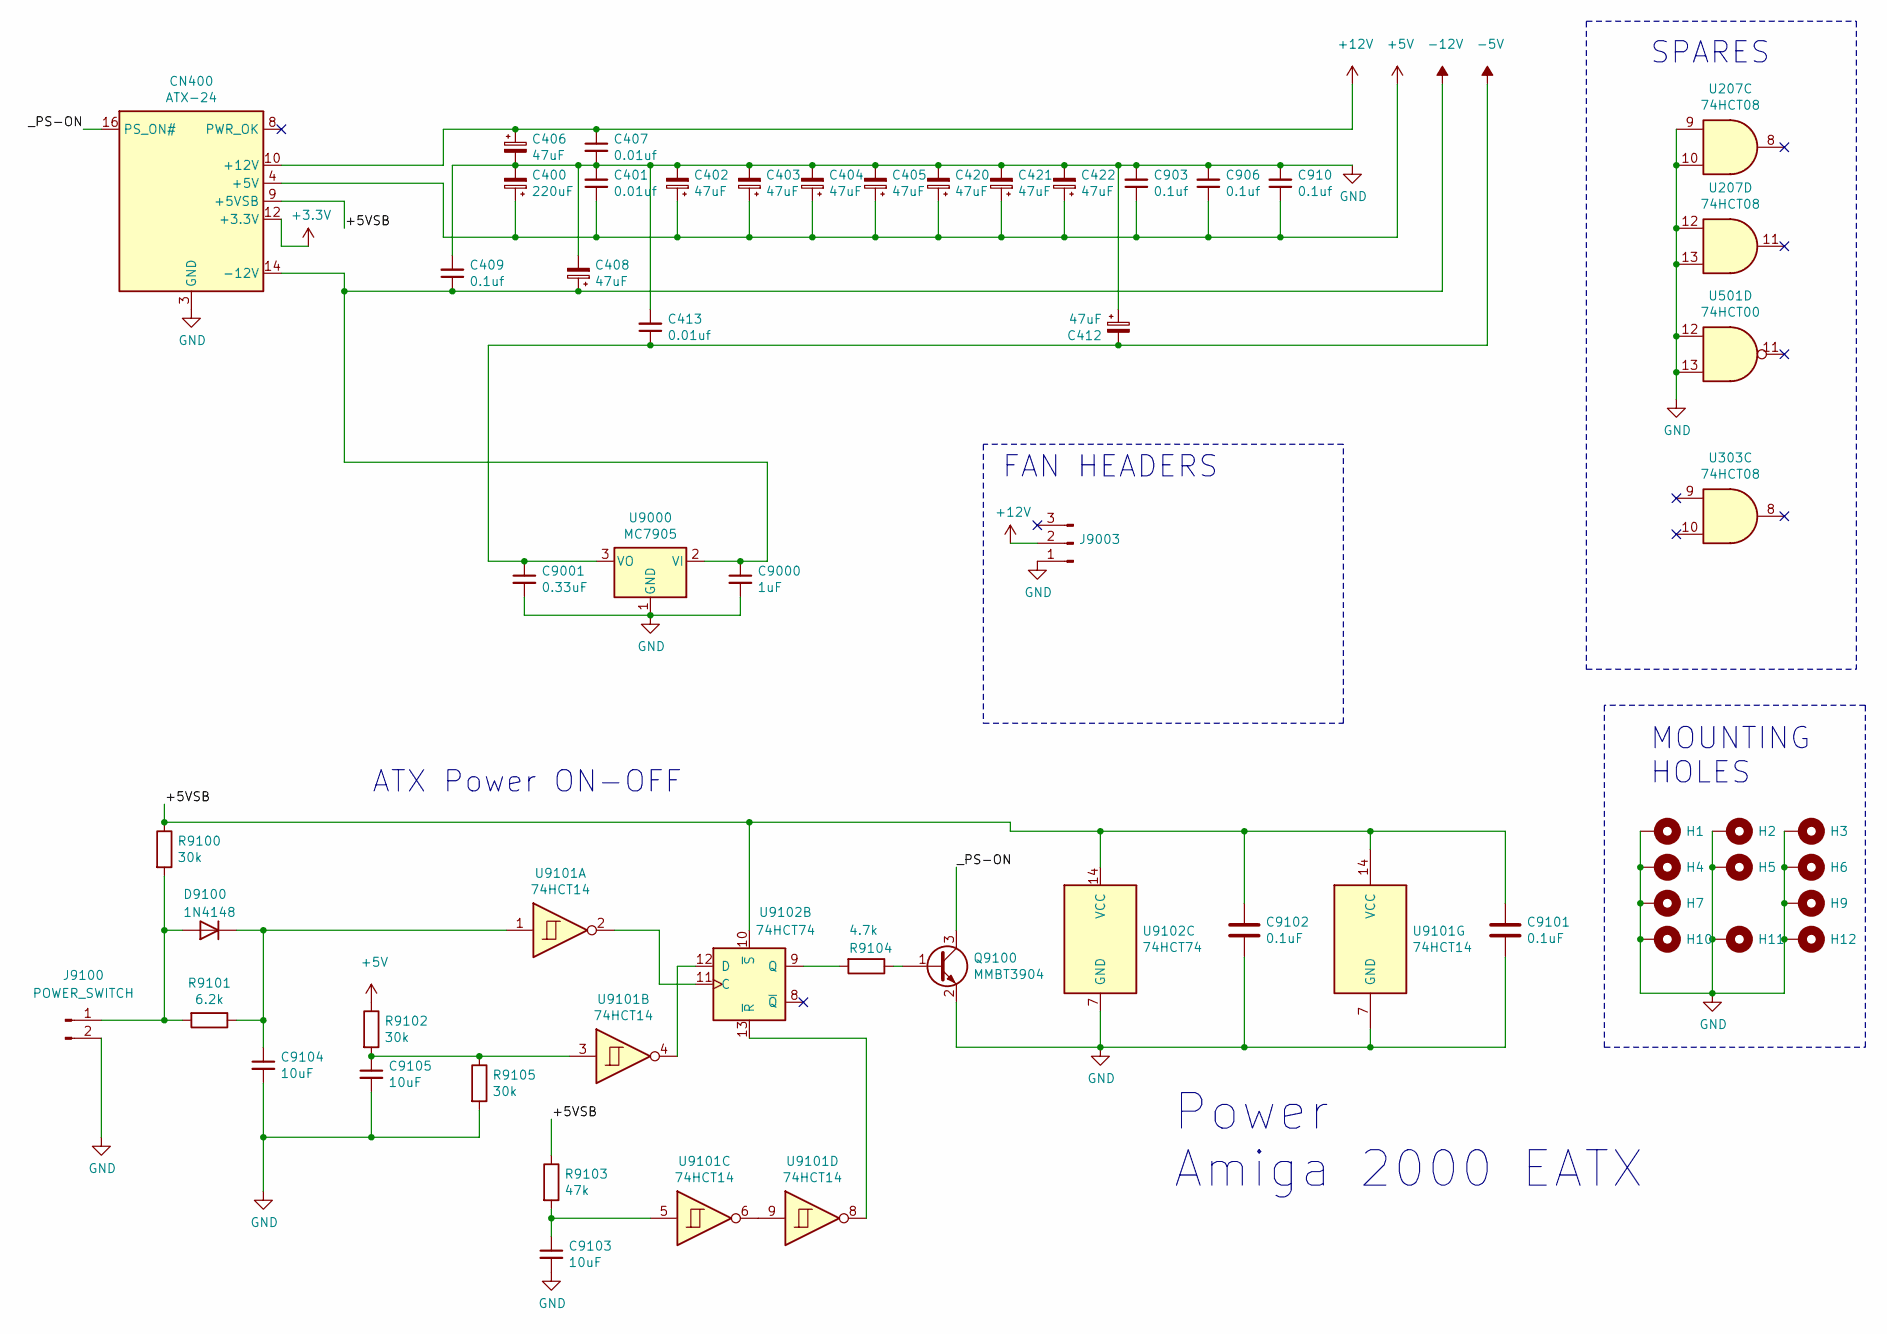
[picture p31: schematic power.sch]

Parts:
C400: 220uF; CP_Elec_8x10
C401, C407, C413: 0.01uf; C_1206_3216Metric
C402, C403, C404, C405, C406, C408, C412, C420, C421, C422: 47uF; CP_Elec_8x10
C409, C903, C906, C910: 0.1uf; C_1206_3216Metric
C9000: 1uF; C_1206_3216Metric
C9001: 0.33uF; C_1206_3216Metric
C9101, C9102: 0.1uF; C_1206_3216Metric
C9103, C9104, C9105: 10uF; C_1206_3216Metric
CN400: ATX-24; Molex_Mini-Fit_Jr_5566-24A_2x12_P4.20mm_Vertical; Part 39281243
D9100: 1N4148; D_SOD-323
H1, H2, H3, H4, H5, H6, H7, H9, H10, H11, H12: MountingHole_Pad
J9003: Case Fan; PinHeader_1x03_P2.54mm_Vertical
J9100: POWER_SWITCH; PinHeader_1x02_P2.54mm_Vertical
Q9100: MMBT3904; SOT-23
R9100, R9102, R9105: 30k; R_1206_3216Metric
R9101: 6.2k; R_1206_3216Metric
R9103: 47k; R_1206_3216Metric
R9104: 4.7k; R_1206_3216Metric
U207, U303: 74HCT08; SOIC-14_3.9x8.7mm_P1.27mm
U501: 74HCT00; SOIC-14_3.9x8.7mm_P1.27mm
U9000: MC7905; TO-263-3_TabPin2
U9101: 74HCT14; SOIC-14_3.9x8.7mm_P1.27mm
U9102: 74HCT74; SOIC-14_3.9x8.7mm_P1.27mm

Connections:
+3.3V: CN400.12 (+3.3V)
+5V: C400.1, C401.1, C402.1, C403.1, C404.1, C405.1, C420.1, C421.1, C422.1, C903.1, C906.1, C910.1, CN400.4 (+5V), CN400.6 (+5V), CN400.21 (+5V), CN400.22 (+5V), CN400.23 (+5V), R9102.1
+5VSB: C9101.1, C9102.1, CN400.9 (+5VSB), R9100.1, R9103.1, U9101.14 (VCC), U9102.10 (~S), U9102.14 (VCC)
+12V: C406.1, C407.1, CN400.10 (+12V), CN400.11 (+12V), J9003.2
-5V: C412.2, C413.1, C9001.1, U9000.3 (VO)
-12V: C408.1, C409.1, C9000.1, CN400.14 (-12V), U9000.2 (VI)
GND: C400.2, C401.2, C402.2, C403.2, C404.2, C405.2, C406.2, C407.2, C408.2, C409.2, C412.1, C413.2, C420.2, C421.2, C422.2, C903.2, C906.2, C910.2, C9000.2, C9001.2, C9101.2, C9102.2, C9103.2, C9104.2, C9105.2, CN400.3 (GND), CN400.5 (GND), CN400.7 (GND), CN400.15 (GND), CN400.17 (GND), CN400.18 (GND), CN400.19 (GND), CN400.24 (GND), H1.1, H2.1, H3.1, H4.1, H5.1, H6.1, H7.1, H9.1, H10.1, H11.1, H12.1, J9003.1, J9100.2, Q9100.2 (E), R9105.2, U207.9, U207.10, U207.12, U207.13, U501.12, U501.13, U9000.1 (GND), U9101.7 (GND), U9102.7 (GND)
unnamed: C9103.1, R9103.2, U9101.5
unnamed: C9104.1, D9100.1 (K), R9101.1, U9101.1
unnamed: C9105.1, R9102.2, R9105.1, U9101.3
unnamed: D9100.2 (A), J9100.1, R9100.2, R9101.2
unnamed: Q9100.1 (B), R9104.1
unnamed: R9104.2, U9102.9 (Q)
unnamed: U9101.2, U9102.11 (C)
unnamed: U9101.4, U9102.12 (D)
unnamed: U9101.6, U9101.9
unnamed: U9101.8, U9102.13 (~R)
_PS-ON: CN400.16 (PS_ON#), Q9100.3 (C)

Notes on the sheet:
ATX Power ON-OFF
Power Amiga 2000 EATX
MOUNTING HOLES
FAN HEADERS
SPARES
