jgrip/Amiga-2000-EATX/2000EATX-KiCAD-R22/serial.sch

## KiCad design 2000EATX-KiCAD-R22/serial.sch (2021-12-02)

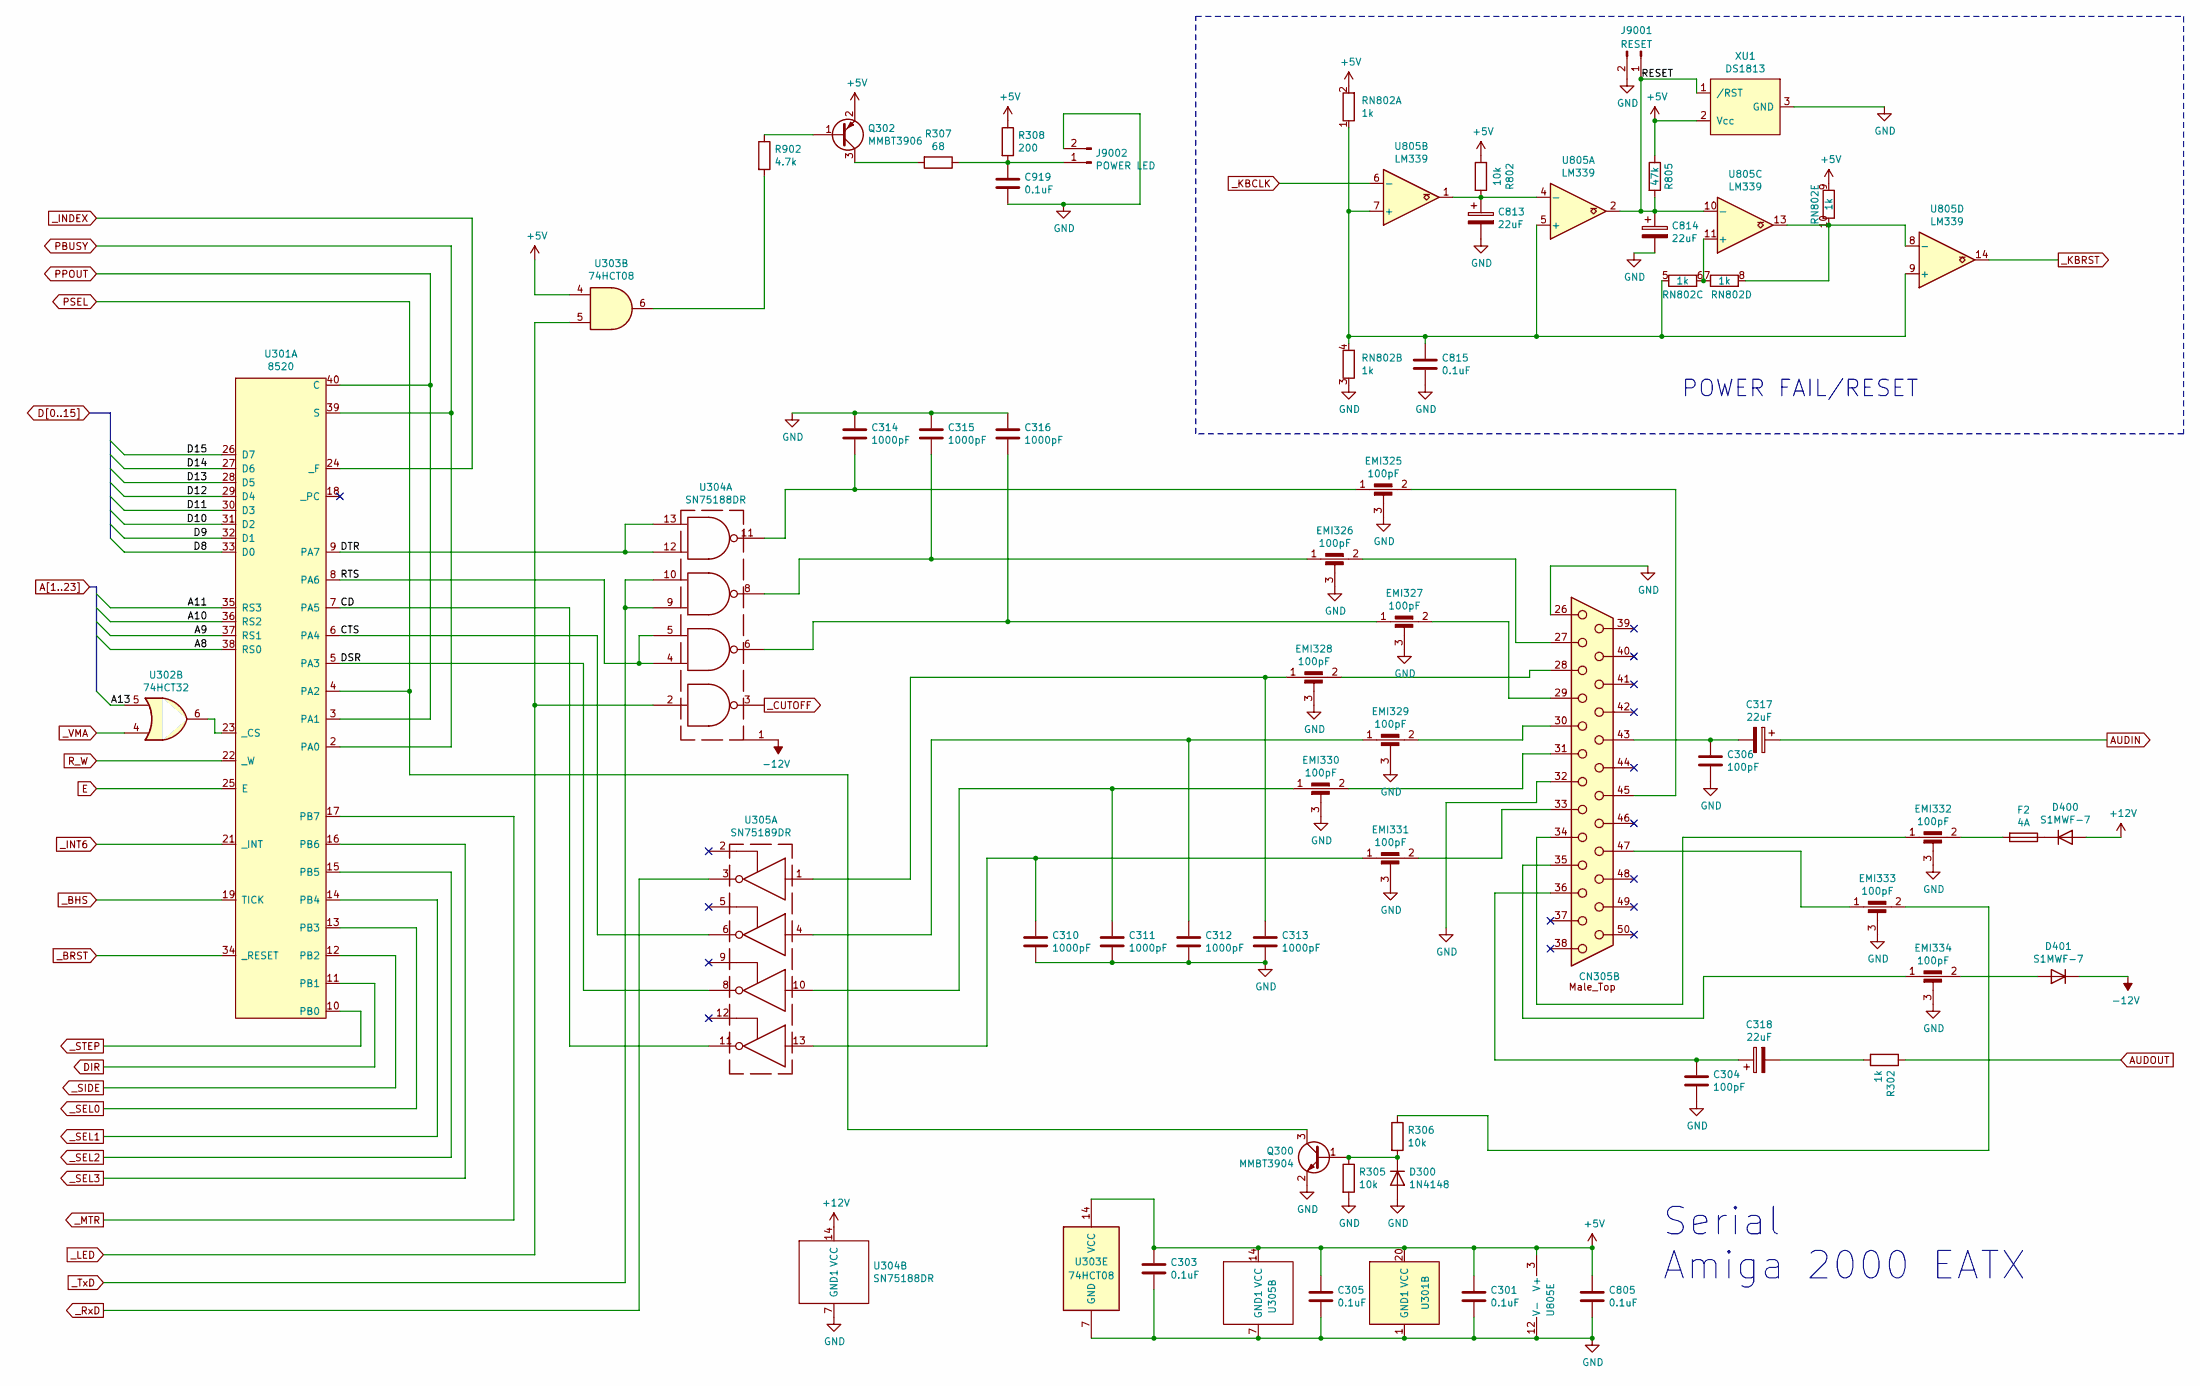
[picture p32: schematic serial.sch]

Parts:
C301, C303, C305, C805, C815, C919: 0.1uF; C_1206_3216Metric
C304, C306: 100pF; C_1206_3216Metric
C310, C311, C312, C313, C314, C315, C316: 1000pF; C_1206_3216Metric
C317, C318, C813, C814: 22uF; CP_Elec_6.3x5.8
CN305: DB25_Stack_FemaleAndMale; DSUB-25_Stack_Female_Bottom_Male_Top
D300: 1N4148; D_SOD-323; pART 1N4148WSTR
D400, D401: S1MWF-7; D_SOD-123F
EMI325, EMI326, EMI327, EMI328, EMI329, EMI330, EMI331, EMI332, EMI333, EMI334: 100pF; C_1206_3216_Feedthrough
F2: 4A; Fuse_1206_3216Metric
J9001: RESET; PinHeader_1x02_P2.54mm_Vertical
J9002: POWER LED; PinHeader_1x02_P2.54mm_Vertical
Q300: MMBT3904; SOT-23
Q302: MMBT3906; SOT-23
R302: 1k; R_1206_3216Metric
R305, R306, R802: 10k; R_1206_3216Metric
R307: 68; R_1206_3216Metric
R308: 200; R_1206_3216Metric
R805: 47k; R_1206_3216Metric
R902: 4.7k; R_1206_3216Metric
RN802: 1k; R_Array_SIP10
U301: 8520; DIP-40_W15.24mm
U302: 74HCT32
U303: 74HCT08
U304: SN75188DR; SOIC-14_3.9x8.7mm_P1.27mm
U305: SN75189DR; SOIC-14_3.9x8.7mm_P1.27mm
U805: LM339; SOIC-14_3.9x8.7mm_P1.27mm; Part LM339ADR
XU1: DS1813; SOT-23

Connections:
+5V: C301.1, C303.1, C305.1, C805.1, Q302.2 (E), R308.1, R802.2, R805.1, RN802.2 (R1.2), RN802.9 (R5.1), U301.20 (VCC), U303.4, U303.14 (VCC), U305.14 (VCC), U805.3 (V+), XU1.2 (Vcc)
+12V: D400.2 (A), U304.14 (VCC)
-12V: D401.1 (K), U304.1
A8: U301.38 (RS0)
A9: U301.37 (RS1)
A10: U301.36 (RS2)
A11: U301.35 (RS3)
A13: U302.5
AUDIN: C317.1
AUDOUT: R302.1
CD: U301.7 (PA5), U305.11
CTS: U301.6 (PA4), U305.6
D8: U301.33 (D0)
D9: U301.32 (D1)
D10: U301.31 (D2)
D11: U301.30 (D3)
D12: U301.29 (D4)
D13: U301.28 (D5)
D14: U301.27 (D6)
D15: U301.26 (D7)
DIR: U301.11 (PB1)
DSR: U301.5 (PA3), U305.8
DTR: U301.9 (PA7), U304.12, U304.13
E: U301.25 (E)
GND: C301.2, C303.2, C304.2, C305.2, C306.2, C310.2, C311.2, C312.2, C313.2, C314.1, C315.1, C316.1, C805.2, C813.2, C814.2, C815.2, C919.2, CN305.26, CN305.32, D300.2 (A), EMI325.3, EMI326.3, EMI327.3, EMI328.3, EMI329.3, EMI330.3, EMI331.3, EMI332.3, EMI333.3, EMI334.3, J9001.2, J9002.2, Q300.2 (E), R305.2, RN802.3 (R2.1), U301.1 (GND1), U303.7 (GND), U304.7 (GND1), U305.7 (GND1), U805.12 (V-), XU1.3 (GND)
unnamed: C304.1, C318.1, CN305.36
unnamed: C306.1, C317.2, CN305.43
unnamed: C310.1, EMI331.1, U305.13
unnamed: C311.1, EMI330.1, U305.10
unnamed: C312.1, EMI329.1, U305.4
unnamed: C313.1, EMI328.1, U305.1
unnamed: C314.2, EMI325.1, U304.11
unnamed: C315.2, EMI326.1, U304.8
unnamed: C316.2, EMI327.1, U304.6
unnamed: C318.2, R302.2
unnamed: C813.1, R802.1, U805.1, U805.4 (-)
unnamed: C815.1, RN802.1 (R1.1), RN802.4 (R2.2), RN802.5 (R3.1), U805.5 (+), U805.7 (+), U805.9 (+)
unnamed: C919.1, J9002.1, R307.1, R308.2
unnamed: CN305.27, EMI326.2
unnamed: CN305.28, EMI328.2
unnamed: CN305.29, EMI327.2
unnamed: CN305.30, EMI329.2
unnamed: CN305.31, EMI330.2
unnamed: CN305.33, EMI331.2
unnamed: CN305.34, EMI332.1
unnamed: CN305.35, EMI334.1
unnamed: CN305.45, EMI325.2
unnamed: CN305.47, EMI333.1
unnamed: D300.1 (K), Q300.1 (B), R305.1, R306.2
unnamed: D400.1 (K), F2.1
unnamed: D401.2 (A), EMI334.2
unnamed: EMI332.2, F2.2
unnamed: EMI333.2, R306.1
unnamed: Q302.1 (B), R902.1
unnamed: Q302.3 (C), R307.2
unnamed: R902.2, U303.6
unnamed: RN802.6 (R3.2), RN802.7 (R4.1), U805.11 (+)
unnamed: RN802.8 (R4.2), RN802.10 (R5.2), U805.8 (-), U805.13
unnamed: U301.23 (_CS), U302.6
PBUSY: U301.2 (PA0), U301.39 (S)
PPOUT: U301.3 (PA1), U301.40 (C)
PSEL: Q300.3 (C), U301.4 (PA2)
RESET: C814.1, J9001.1, R805.2, U805.2, U805.10 (-), XU1.1 (/RST)
RTS: U301.8 (PA6), U304.4, U304.5
R_W: U301.22 (_W)
_BHS: U301.19 (TICK)
_BRST: U301.34 (_RESET)
_CUTOFF: U304.3
_INDEX: U301.24 (_F)
_INT6: U301.21 (_INT)
_KBCLK: U805.6 (-)
_KBRST: U805.14
_LED: U303.5, U304.2
_MTR: U301.17 (PB7)
_RxD: U305.3
_SEL0: U301.13 (PB3)
_SEL1: U301.14 (PB4)
_SEL2: U301.15 (PB5)
_SEL3: U301.16 (PB6)
_SIDE: U301.12 (PB2)
_STEP: U301.10 (PB0)
_TxD: U304.9, U304.10
_VMA: U302.4

Notes on the sheet:
POWER FAIL/RESET
Serial Amiga 2000 EATX
