jgrip/Amiga-2000-EATX/2000EATX-KiCAD-R22/video.sch

## KiCad design 2000EATX-KiCAD-R22/video.sch (2021-12-02)

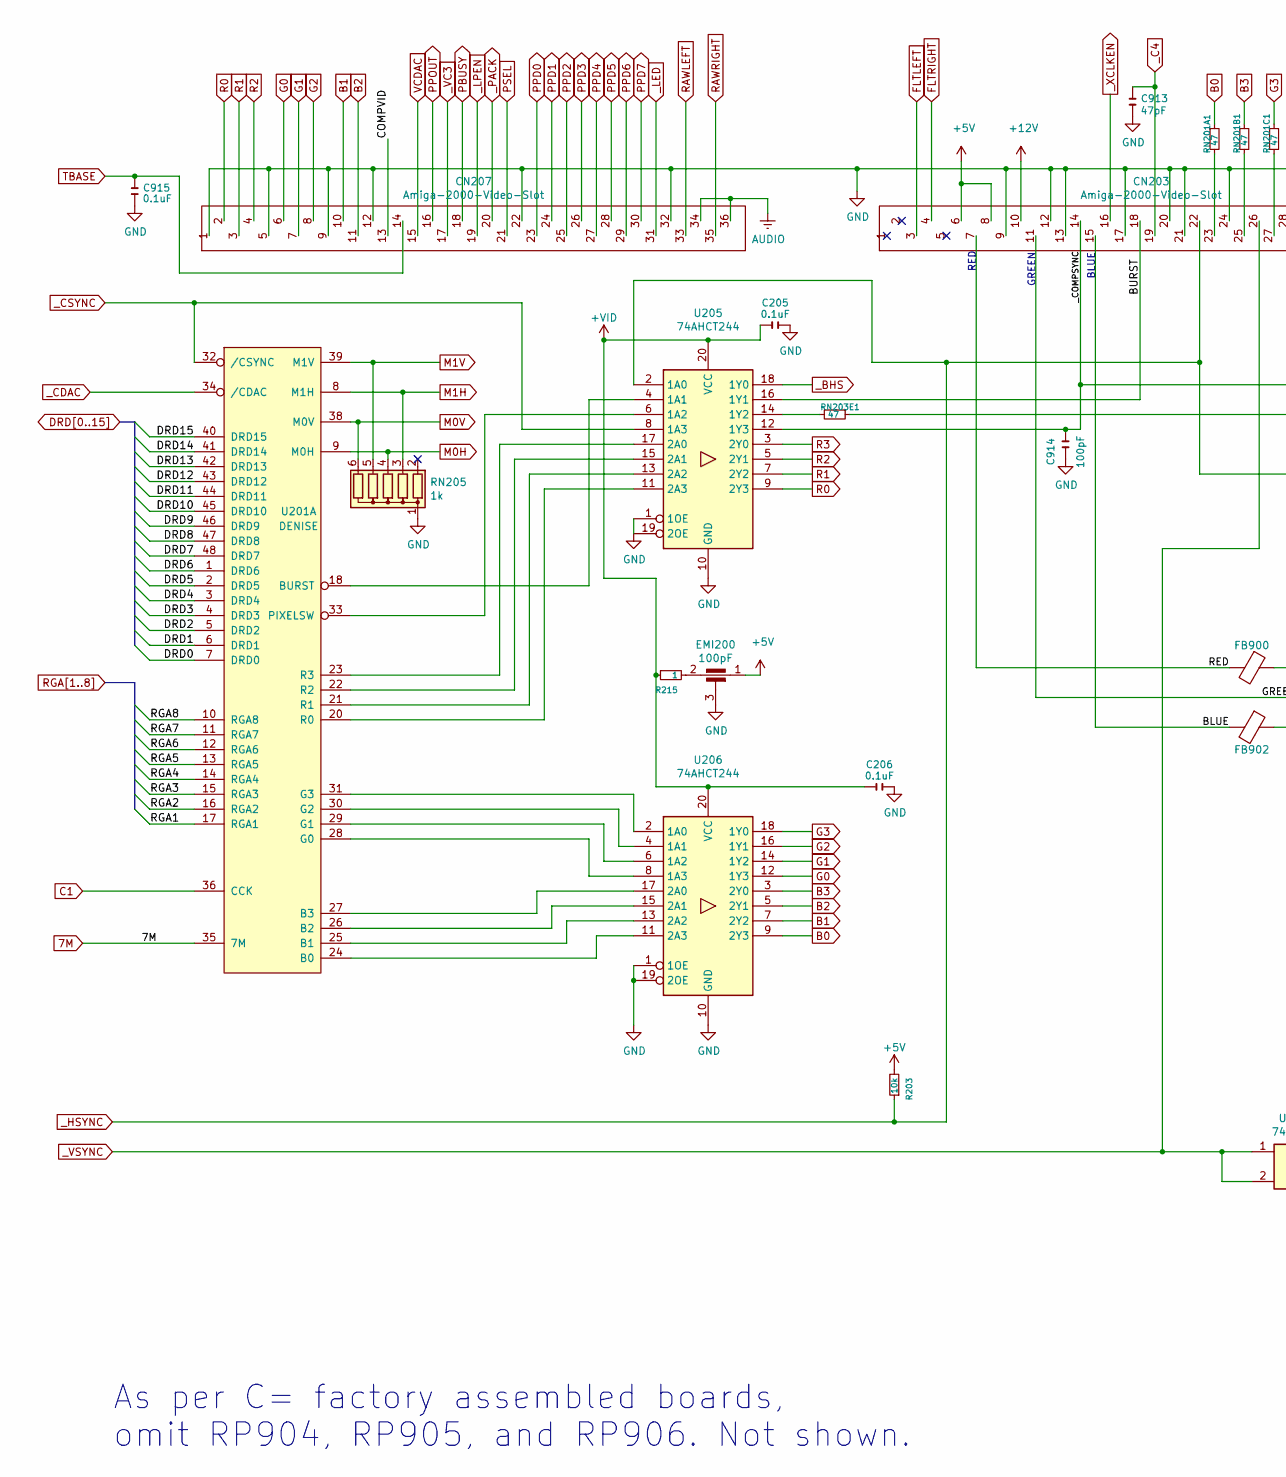
[picture p33: schematic video.sch, part in row 1, column 1]

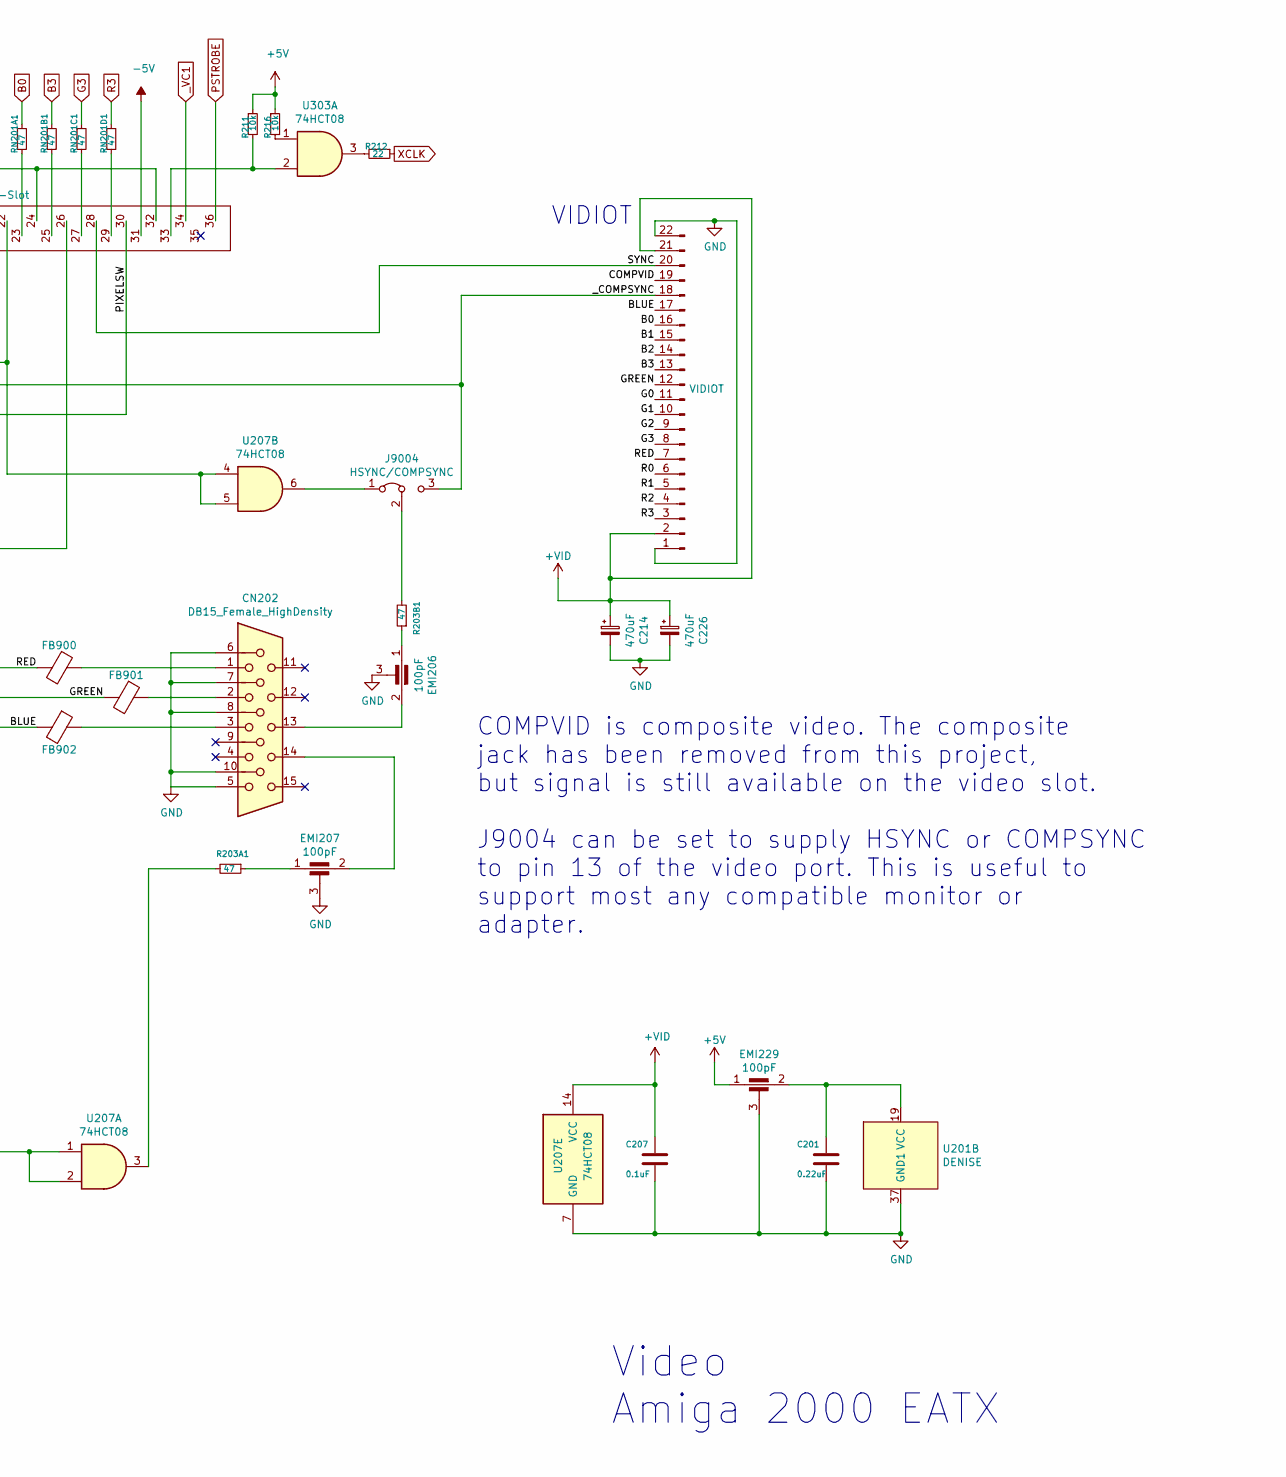
[picture p34: schematic video.sch, part in row 1, column 2]

Parts:
C201: 0.22uF; C_1206_3216Metric
C205, C206, C207, C915: 0.1uF; C_1206_3216Metric
C214, C226: 470uF; CP_Elec_8x10
C913: 47pF; C_1206_3216Metric
C914: 100pF; C_1206_3216Metric
CN202: DB15_Female_HighDensity; DSUB-15-HD_Female_Horizontal_P2.29x1.98mm_EdgePinOffset8.35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
CN203, CN207: Amiga-2000-Video-Slot; 2x18_P2.54mm_Horizontal
EMI200, EMI206, EMI207, EMI229: 100pF; C_1206_3216_Feedthrough
FB900, FB901, FB902: Ferrite_Bead; C_1206_3216Metric; Part ILHB1206ER750V
HY200: VIDIOT; PinSocket_1x22_P2.54mm_Vertical
J9004: HSYNC/COMPSYNC; PinHeader_1x03_P2.54mm_Vertical
R203, R211, R216: 10k; R_1206_3216Metric
R203A1, R203B1: 47; R_1206_3216Metric
R212: 22; R_1206_3216Metric
R215: 1; R_1206_3216Metric
RN201A1, RN201B1, RN201C1, RN201D1, RN203E1: 47; R_1206_3216Metric
RN205: 1k; R_Array_SIP6
U201: DENISE; DIP-48_W15.24mm
U205, U206: 74AHCT244; SOIC-20W_7.5x12.8mm_P1.27mm
U207, U303: 74HCT08; SOIC-14_3.9x8.7mm_P1.27mm

Connections:
7M: U201.35 (7M)
+5V: CN203.6, CN203.8, EMI200.1, EMI229.1, R203.2, R211.1, R216.1
+12V: CN203.10
+VID: C205.2, C206.2, C207.1, C214.1, C226.1, HY200.2, HY200.21, R215.1, U205.20 (VCC), U206.20 (VCC), U207.14 (VCC)
-5V: CN203.31
AUDIO: CN207.34, CN207.36
B0: HY200.16, RN201A1.1, U206.9 (2Y3)
B1: CN207.10, HY200.15, U206.7 (2Y2)
B2: CN207.11, HY200.14, U206.5 (2Y1)
B3: HY200.13, RN201B1.1, U206.3 (2Y0)
BLUE: CN203.15, FB902.2, HY200.17
BURST: CN203.18, U205.16 (1Y1)
C1: U201.36 (CCK)
COMPVID: CN207.13, HY200.19
DRD0: U201.7 (DRD0)
DRD1: U201.6 (DRD1)
DRD2: U201.5 (DRD2)
DRD3: U201.4 (DRD3)
DRD4: U201.3 (DRD4)
DRD5: U201.2 (DRD5)
DRD6: U201.1 (DRD6)
DRD7: U201.48 (DRD7)
DRD8: U201.47 (DRD8)
DRD9: U201.46 (DRD9)
DRD10: U201.45 (DRD10)
DRD11: U201.44 (DRD11)
DRD12: U201.43 (DRD12)
DRD13: U201.42 (DRD13)
DRD14: U201.41 (DRD14)
DRD15: U201.40 (DRD15)
FLTLEFT: CN203.3
FLTRIGHT: CN203.4
G0: CN207.6, HY200.11, U206.12 (1Y3)
G1: CN207.7, HY200.10, U206.14 (1Y2)
G2: CN207.8, HY200.9, U206.16 (1Y1)
G3: HY200.8, RN201C1.1, U206.18 (1Y0)
GND: C201.2, C205.1, C206.1, C207.2, C214.2, C226.2, C913.2, C914.1, C915.2, CN202.5, CN202.6, CN202.7, CN202.8, CN202.10, CN203.9, CN203.12, CN203.13, CN203.17, CN203.20, CN203.21, CN203.24, CN203.32, CN207.1, CN207.5, CN207.9, CN207.12, CN207.22, CN207.32, EMI200.3, EMI206.3, EMI207.3, EMI229.3, HY200.1, HY200.22, RN205.1 (common), U201.37 (GND1), U205.1 (1OE), U205.10 (GND), U205.19 (2OE), U206.1 (1OE), U206.10 (GND), U206.19 (2OE), U207.7 (GND)
GREEN: CN203.11, FB901.2, HY200.12
M0H: RN205.4 (R3), U201.9 (M0H)
M0V: RN205.6 (R5), U201.38 (M0V)
M1H: RN205.3 (R2), U201.8 (M1H)
M1V: RN205.5 (R4), U201.39 (M1V)
unnamed: C201.1, EMI229.2, U201.19 (VCC)
unnamed: CN202.1, FB900.1
unnamed: CN202.2, FB901.1
unnamed: CN202.3, FB902.1
unnamed: CN202.13, EMI206.2
unnamed: CN202.14, EMI207.2
unnamed: CN203.23, RN201A1.2
unnamed: CN203.25, RN201B1.2
unnamed: CN203.27, RN201C1.2
unnamed: CN203.29, RN201D1.2
unnamed: CN203.33, R211.2, U303.2
unnamed: EMI200.2, R215.2
unnamed: EMI206.1, R203B1.1
unnamed: EMI207.1, R203A1.1
unnamed: J9004.1 (A), U207.6
unnamed: J9004.2 (C), R203B1.2
unnamed: R203A1.2, U207.3
unnamed: R212.2, U303.3
unnamed: R216.2, U303.1
unnamed: RN203E1.2, U205.14 (1Y2)
unnamed: U201.18 (BURST), U205.4 (1A1)
unnamed: U201.20 (R0), U205.11 (2A3)
unnamed: U201.21 (R1), U205.13 (2A2)
unnamed: U201.22 (R2), U205.15 (2A1)
unnamed: U201.23 (R3), U205.17 (2A0)
unnamed: U201.24 (B0), U206.11 (2A3)
unnamed: U201.25 (B1), U206.13 (2A2)
unnamed: U201.26 (B2), U206.15 (2A1)
unnamed: U201.27 (B3), U206.17 (2A0)
unnamed: U201.28 (G0), U206.8 (1A3)
unnamed: U201.29 (G1), U206.6 (1A2)
unnamed: U201.30 (G2), U206.4 (1A1)
unnamed: U201.31 (G3), U206.2 (1A0)
unnamed: U201.33 (PIXELSW), U205.6 (1A2)
PBUSY: CN207.18
PIXELSW: CN203.30, RN203E1.1
PPD0: CN207.23
PPD1: CN207.24
PPD2: CN207.25
PPD3: CN207.26
PPD4: CN207.27
PPD5: CN207.28
PPD6: CN207.29
PPD7: CN207.30
PPOUT: CN207.16
PSEL: CN207.21
PSTROBE: CN203.36
R0: CN207.2, HY200.6, U205.9 (2Y3)
R1: CN207.3, HY200.5, U205.7 (2Y2)
R2: CN207.4, HY200.4, U205.5 (2Y1)
R3: HY200.3, RN201D1.1, U205.3 (2Y0)
RAWLEFT: CN207.33
RAWRIGHT: CN207.35
RED: CN203.7, FB900.2, HY200.7
RGA1: U201.17 (RGA1)
RGA2: U201.16 (RGA2)
RGA3: U201.15 (RGA3)
RGA4: U201.14 (RGA4)
RGA5: U201.13 (RGA5)
RGA6: U201.12 (RGA6)
RGA7: U201.11 (RGA7)
RGA8: U201.10 (RGA8)
SYNC: CN203.28, HY200.20
TBASE: C915.1, CN207.14
VCDAC: CN207.15
XCLK: R212.1
_BHS: U205.18 (1Y0)
_C4: C913.1, CN203.19
_CDAC: U201.34 (/CDAC)
_COMPSYNC: C914.2, CN203.14, HY200.18, J9004.3 (B), U205.12 (1Y3)
_CSYNC: U201.32 (/CSYNC), U205.8 (1A3)
_HSYNC: CN203.22, R203.1, U205.2 (1A0), U207.4, U207.5
_LED: CN207.31
_LPEN: CN207.19
_PACK: CN207.20
_VC1: CN203.34
_VC3: CN207.17
_VSYNC: CN203.26, U207.1, U207.2
_XCLKEN: CN203.16

Notes on the sheet:
Video Amiga 2000 EATX
VIDIOT
As per C= factory assembled boards, omit RP904, RP905, and RP906. Not shown.
COMPVID is composite video. The composite jack has been removed from this project, but signal is still available on the video slot. J9004 can be set to supply HSYNC or COMPSYNC to pin 13 of the video port. This is useful to support most any compatible monitor or adapter.
BLUE
GREEN
RED
